track-cooler/docs/Estrutura/PC2/Simulações/statistics_malha_sapatas.PNG

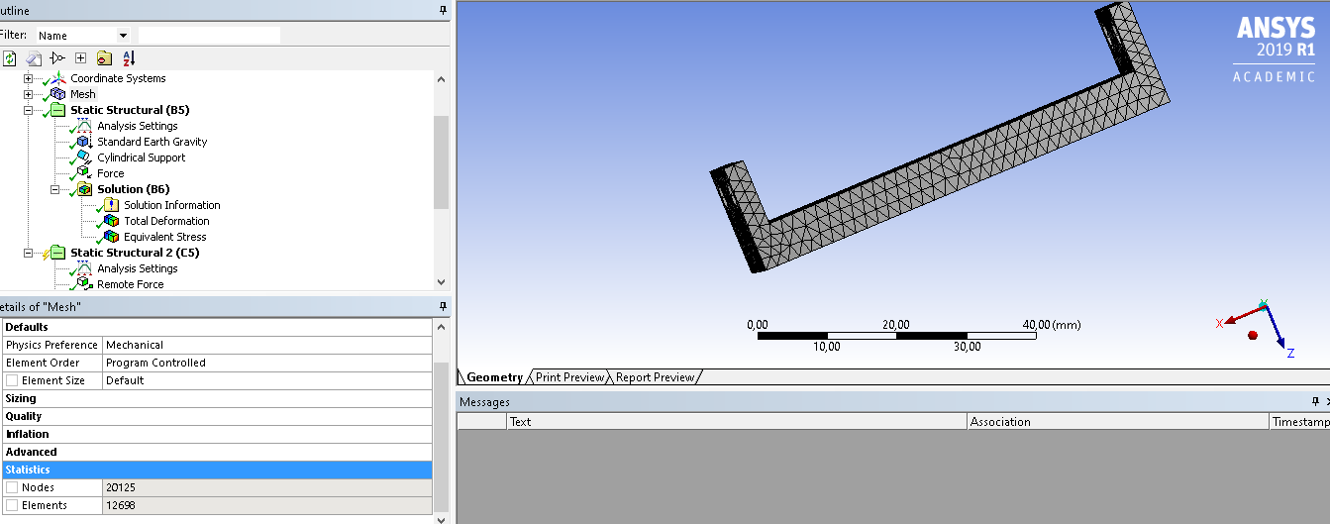
Estrutura/PC2/Simulações/statistics_malha_sapatas.PNG
