track-cooler/docs/Estrutura/PC2/Simulações/sapatanovaforcas.png

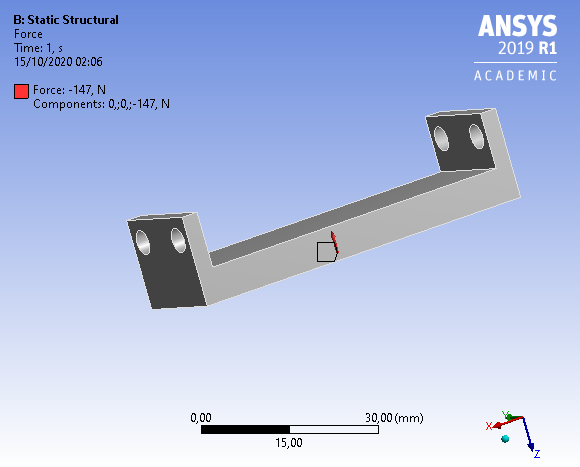
Estrutura/PC2/Simulações/sapatanovaforcas.png
