track-cooler/docs/README.md

# docs
Documentos relacionados ao Track Cooler - PI2
