track-cooler/docs/Software/README.md

## docs de Software

Para entender um pouco mais sobre o produto, acesse nossa [documentação](https://track-cooler.github.io/app_track_cooler/).
