track-cooler/docs/Estrutura/PC2/Análise Térmica/README.md

# Pasta para arquivos de análise térmica
