track-cooler/docs/Estrutura/PC2/Sistema de Alimentação/README.md

# Pasta para arquivos do sistema de alimentação
