track-cooler/docs/Apresentacoes/PONTO_DE_CONTROLE_1/TRACK_COOLER.pptx

## Track Cooler

## Problema

- Mudança nos Hábitos de Consumo;
- Busca de Produtos e Serviços;
- Soluções modernas no setor de bens de consumo;
- Tecnologia Disruptivas;
- Entretenimento e Lazer;

## Slide 3

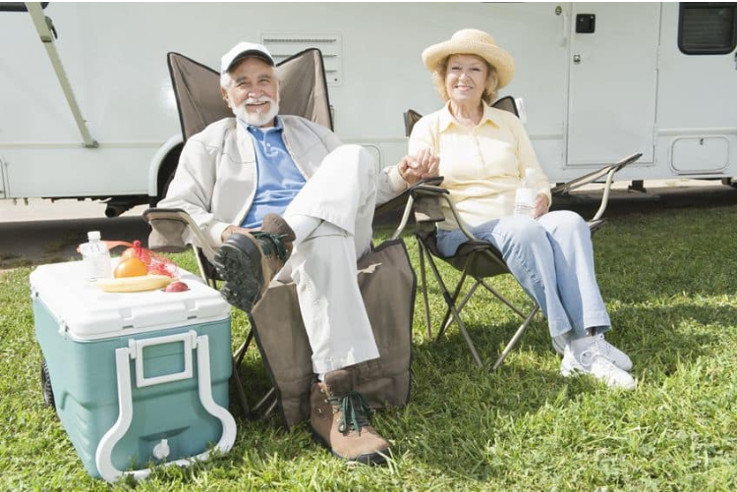
[picture p27: figure]
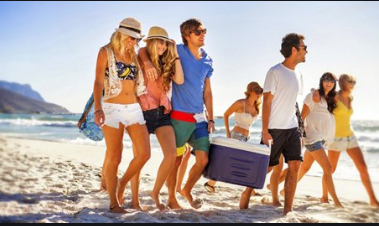
[picture p28: figure]
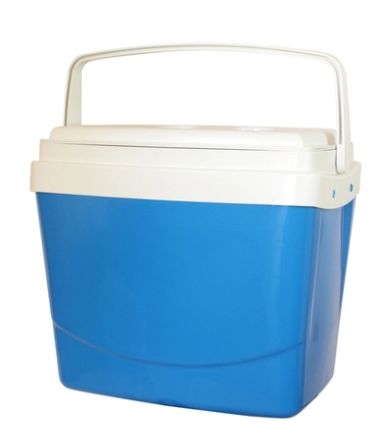
[picture p29: figure]
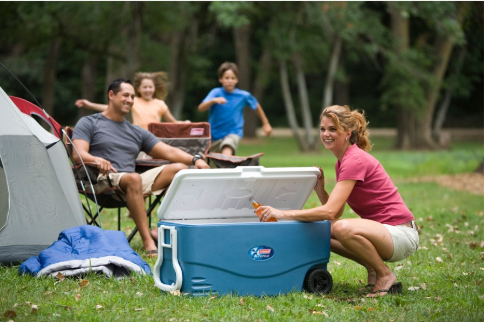
[picture p30: figure]
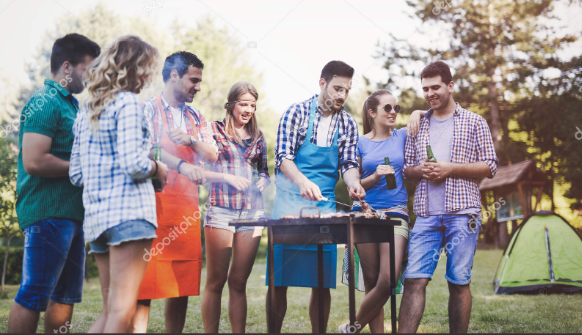
[picture p31: figure]

## Escopo

- TRACK COOLER

## Slide 5

Oportunidade de Negócio

- Público Alvo;
- Carência;
- Solução;
- Descrição da Solução;
- Diferenciais;

## Slide 6

Oportunidade de Negócio

- Linguagem Simples;
- Aplicação possuirá menu com todos recursos não-administrativos do sistema
- Consultar a temperatura
- Melhora a Capacidade de locomoção do usuário

## Requisitos do Projeto

## Requisitos de estrutura

- Boa capacidade de manter a temperatura interna;
- Possível se movimentar em terrenos planos e baixa erosão;
- Absorver vibrações;
- Suportar a carga total da caixa térmica;
- Suprir a demanda de potência das cargas eletroeletrônicas do cooler;

## Requisitos Eletrônica

- Localizar o cooler através do GPS.
- Seguir o cliente a partir do uso de celular por módulo bluetooth.
- Aferir a temperatura do cooler.
- Identificar desníveis
- Protótipo funcionará através do app ligado.
- Seguir o usuário a partir de determinada distância.

## Requisitos de Software

- Ver e atualizar informações do cooler;
- Conectar com bluetooth do cooler;
- Ligar/desligar o cooler;
- Abrir configurações (gps e bluetooth);
- Exibir alerta caso o cooler não consiga seguir a pessoa ou se for desconectado;
- Comandos por voz;
- Mudança de contraste no aplicativo;
- Alterar tamanho da fonte da letra;

## Estrutura Analítica do Projeto (EAP)

## Slide 12

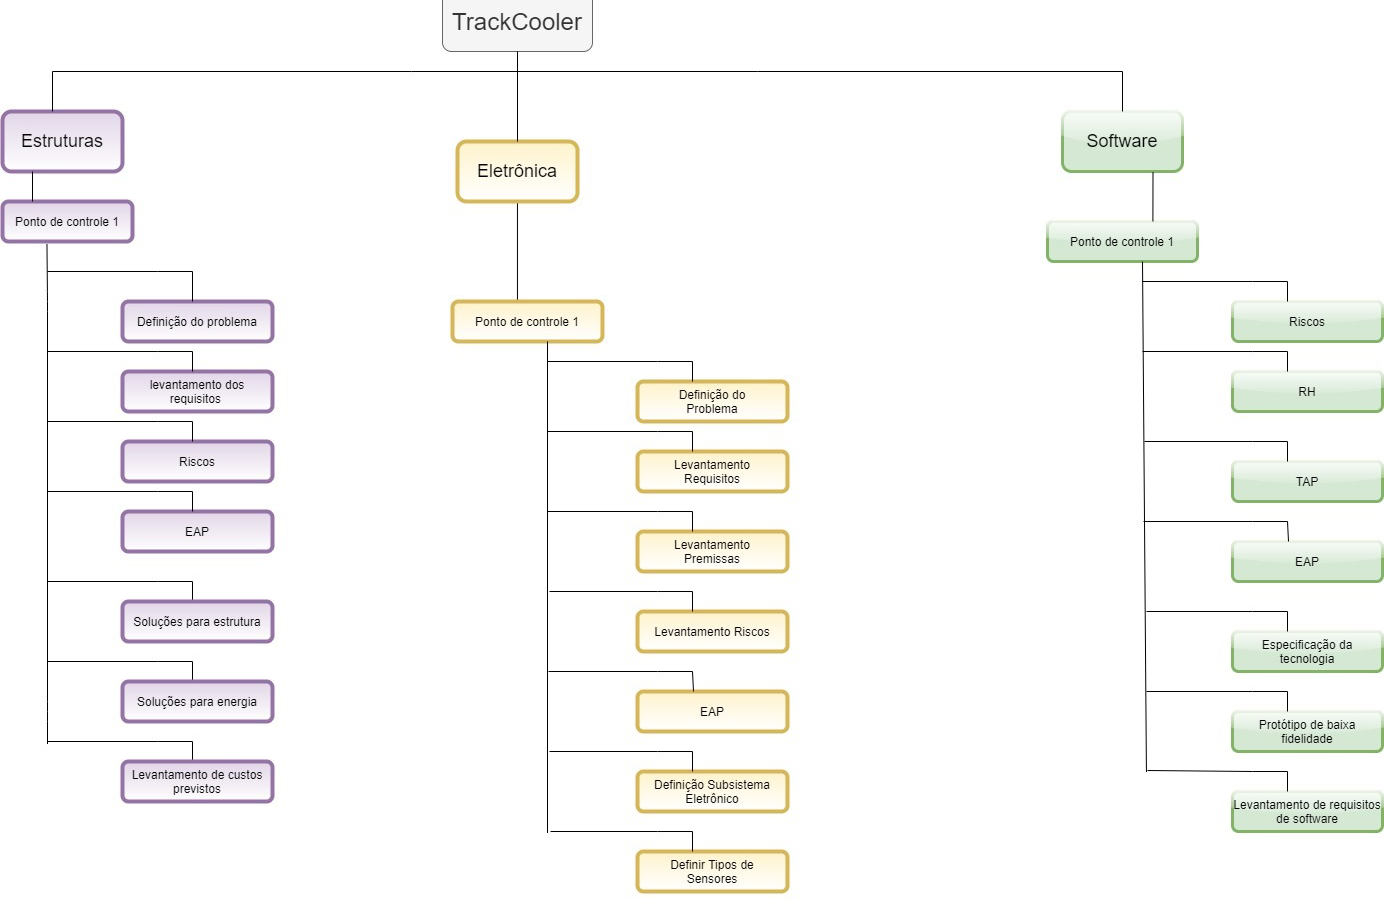
[picture p32: figure]

## Slide 13


## Slide 14

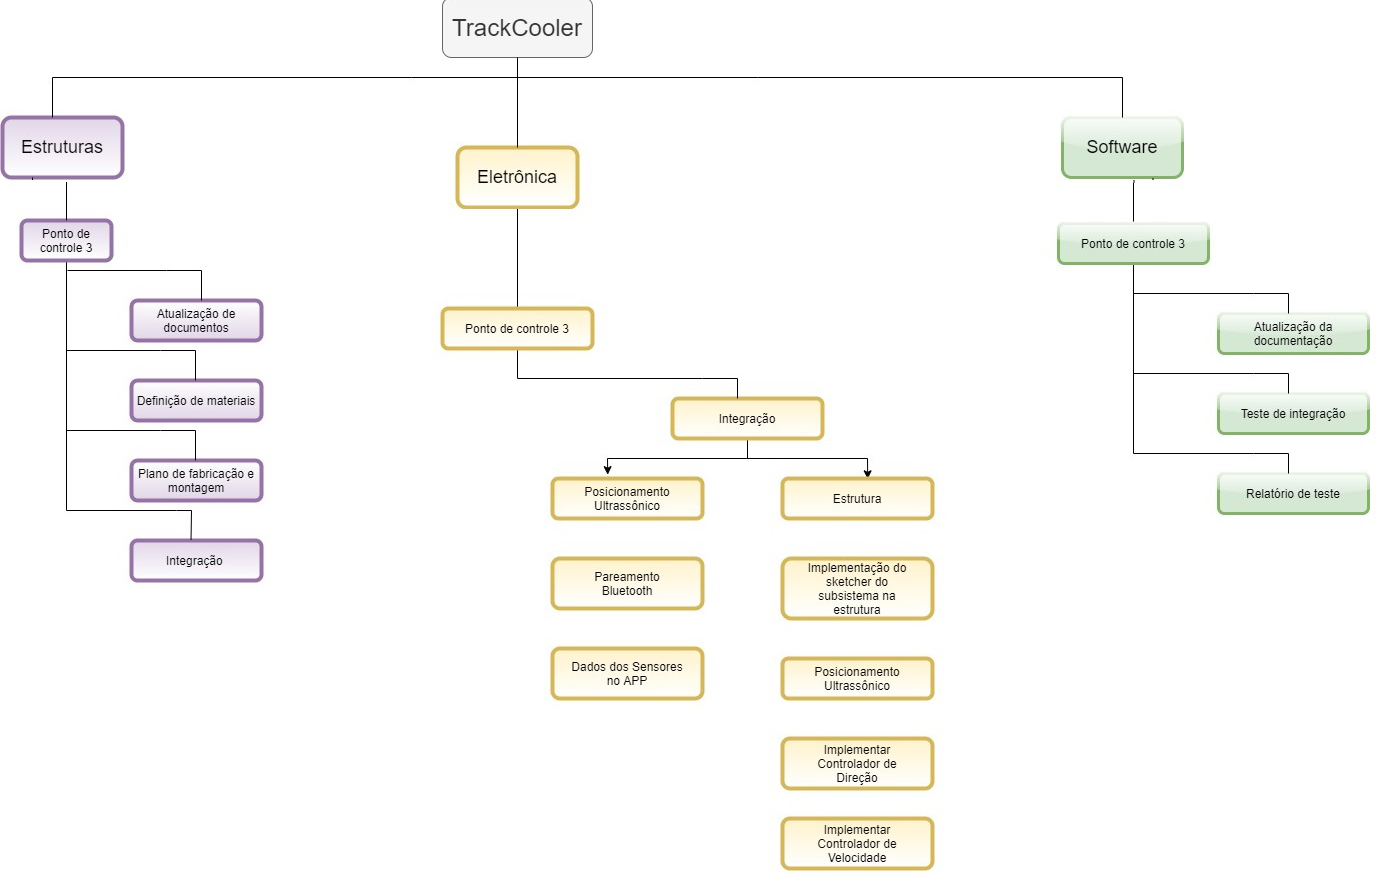
[picture p33: figure]

## Proposta de Solução

## Solução de estruturas

- Mecanismo de locomoção;
- Cooler;
- Chassi;
- Sistema de alimentação.

## Slide 17

Mecanismo de locomoção


## Slide 18

Mecanismo de locomoção

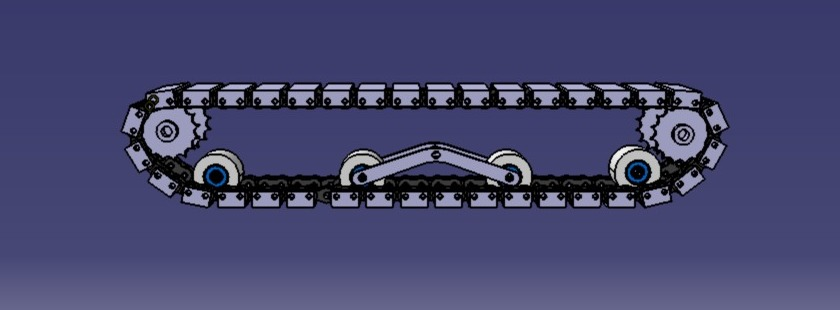
[picture p34: figure]

## Cooler

- Caixa organizadora para a parte interna;
- Poliestireno expandido (isopor) para a segunda camada;
- Chapas de policloreto de vinila (PVC) para a terceira e última camada.

## Slide 20

Chassi

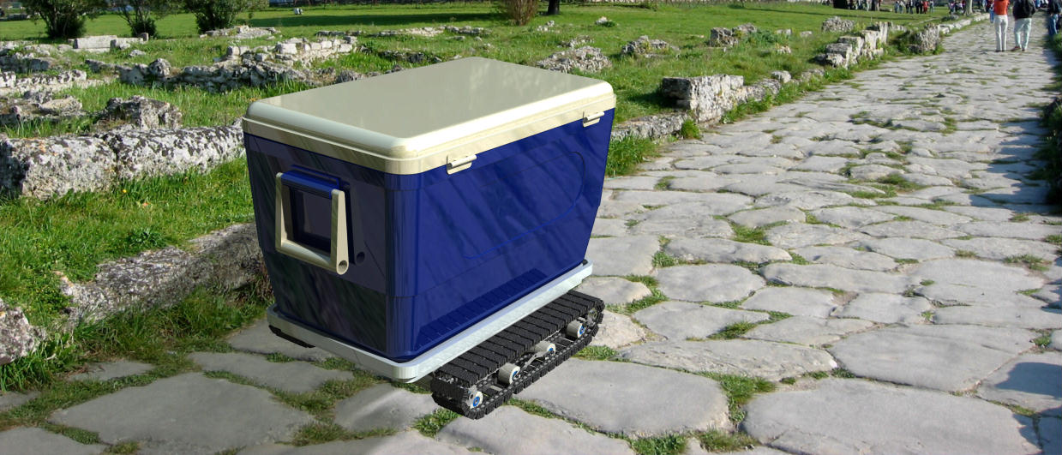
[picture p35: figure]

## Slide 21

Sistema de alimentação

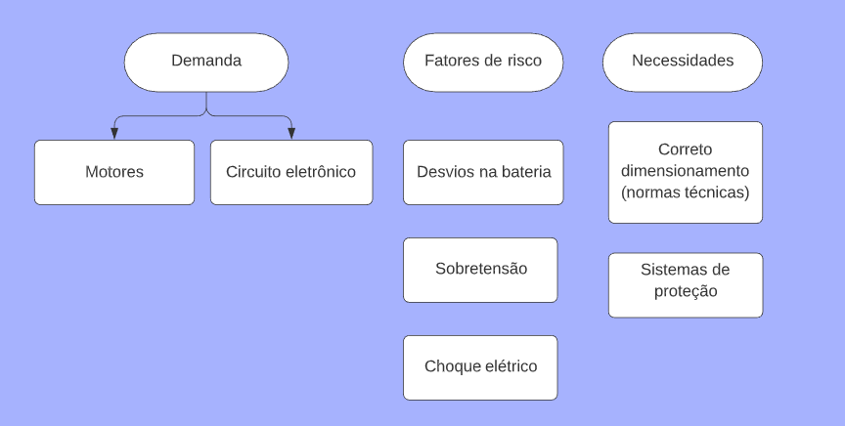
[picture p36: figure]

## Slide 22

Sistema de alimentação

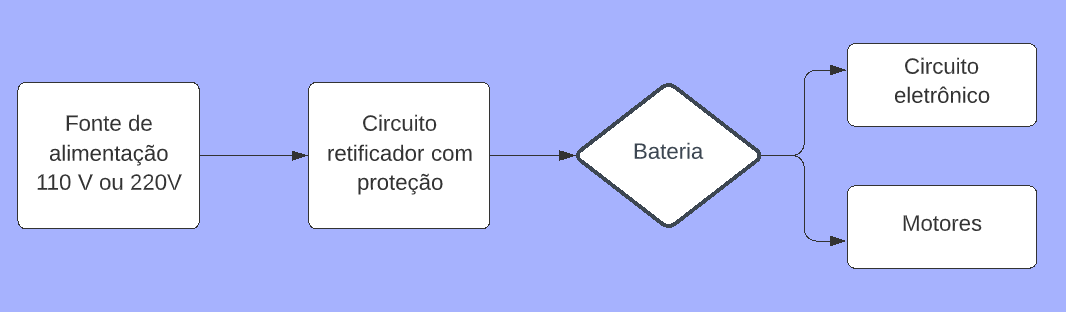
[picture p37: figure]

## Solução de Eletrônica

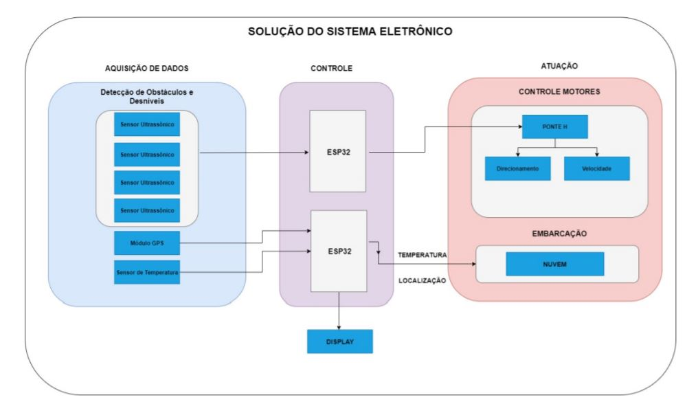
[picture p38: figure]

## Solução de Software

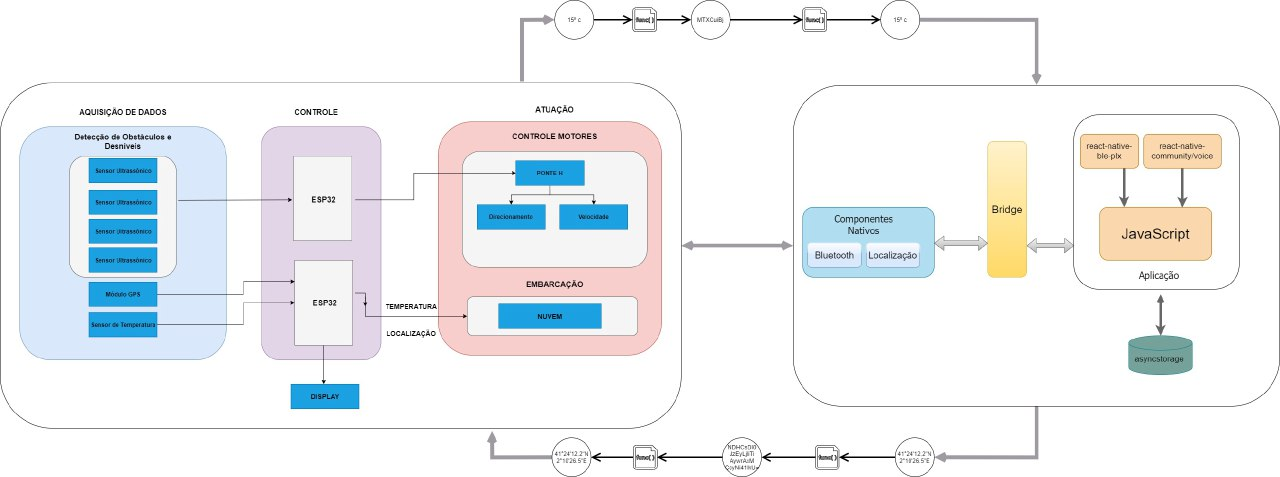
[picture p39: figure]

## Slide 25

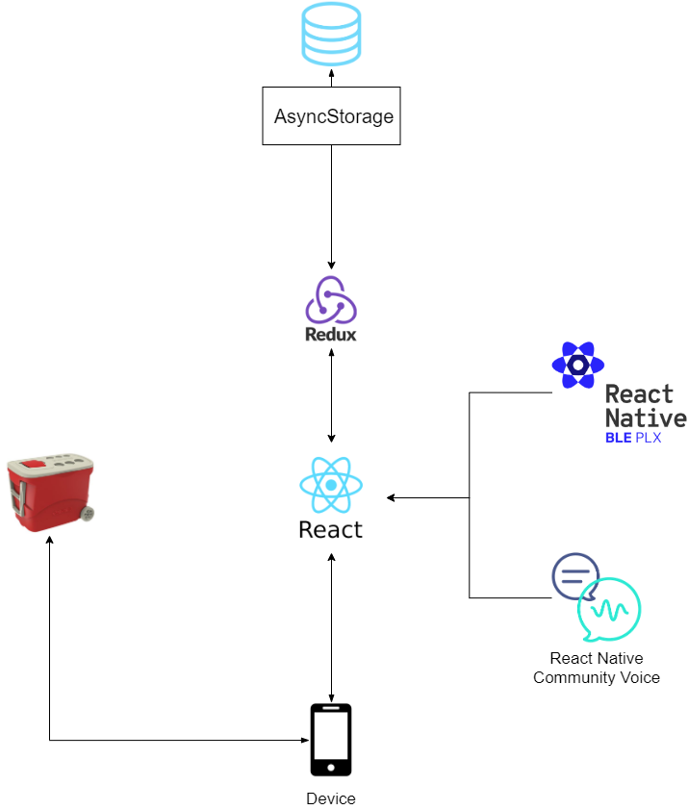
[picture p40: figure]

## Slide 26

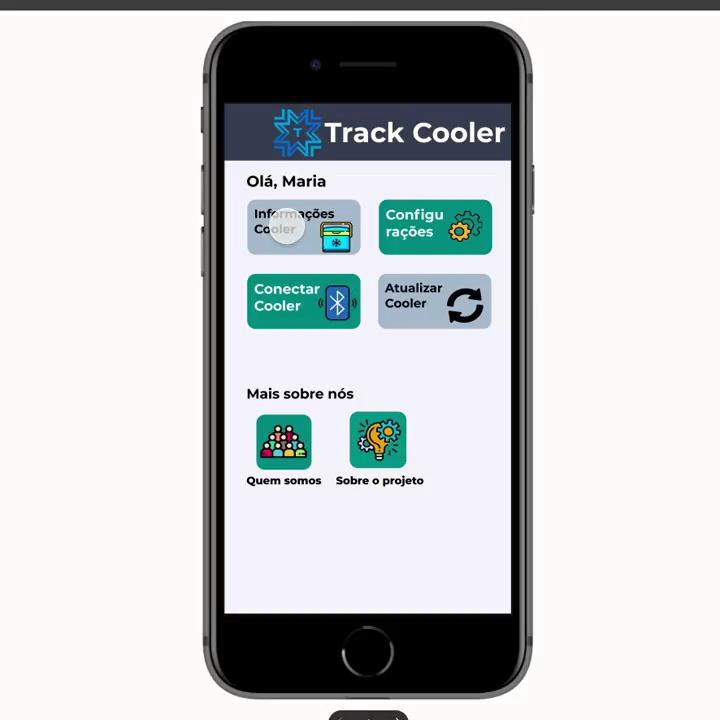
[picture p41: figure]

## Obrigado!
