track-cooler/docs/Reunioes/PC1/REUNIÃO_18_09.pdf

-Oportunidade de Negócios

-Visão do produto (Sannya estruturar) - Apêndice

-perfil do usuário

-Trabalhos Correlatos

-Animação com movimentação (Apresentação).

-Resumo: Resultados esperados

-Mandar TAP para o Apêndice A:

- Descrição do Projeto;
- Justificativa;
- Objetivo;
- Requisitos;
- Riscos
- Cronograma;

-Apêndice B: Plano de Gerenciamento de Recursos Humanos

-Imagens nos anexos ????

REUNIÃO (18/09/2020):

-Objetivos Gerais mais integrados;

-gráfico de Gantt (arruma texto);

- integração software e Eletrônica;
- desenvolvimento de diagramas de integração.

-Apresentar trabalho – antes da premissa;

- Integrar os tópicos =;

-Escopo (1.4) = talvez colocar antes das premissas;

- Apresentar Resultados esperados

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
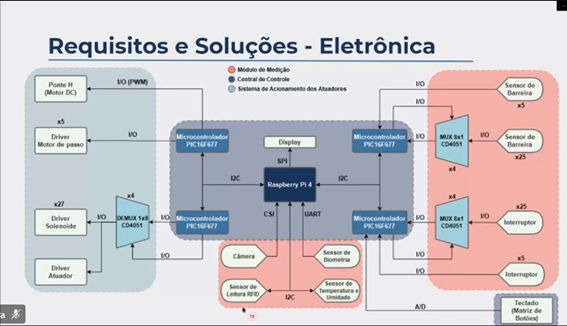
[picture p42: figure]
