track-cooler/docs/Estrutura/PC3/Alimentacao/Simulações.pdf

SIMULAÇÕES

Software Proteus

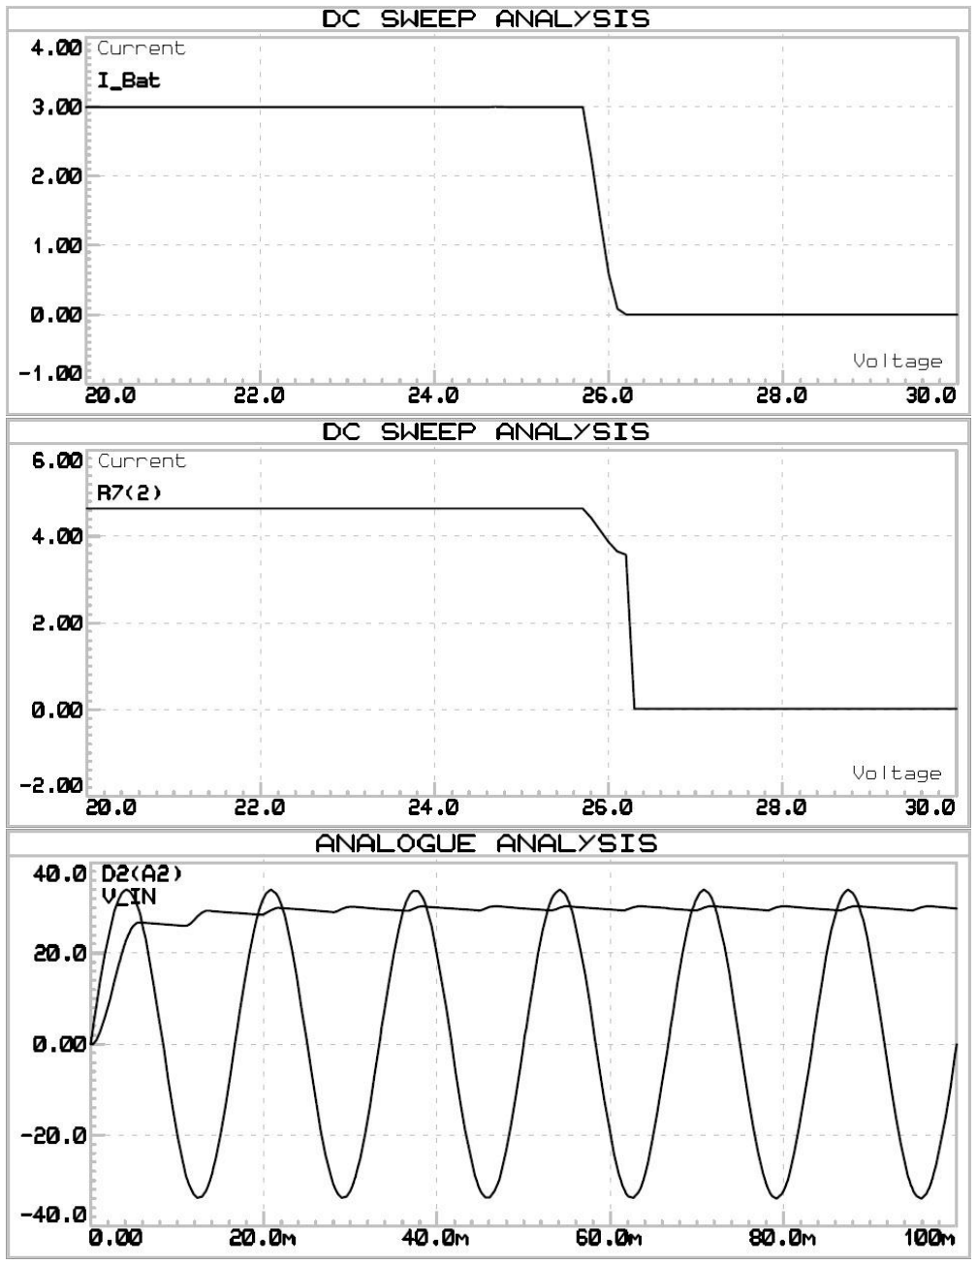
[picture p43: figure]

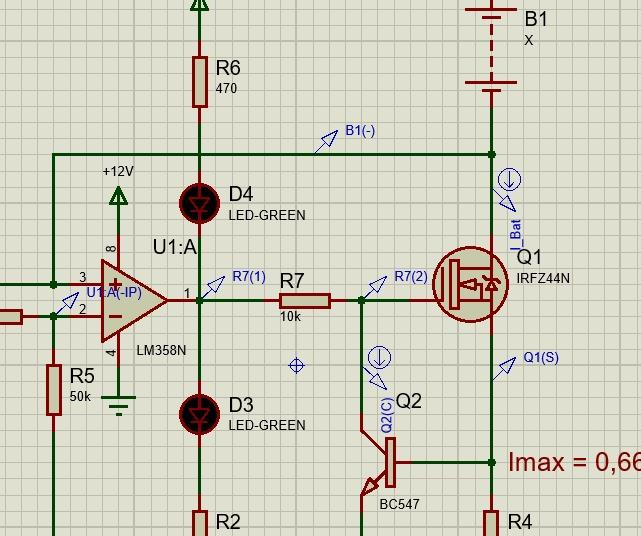
[picture p44: figure]
