track-cooler/docs/Estrutura/PC2/Sistema de Alimentação/Simulações.pdf

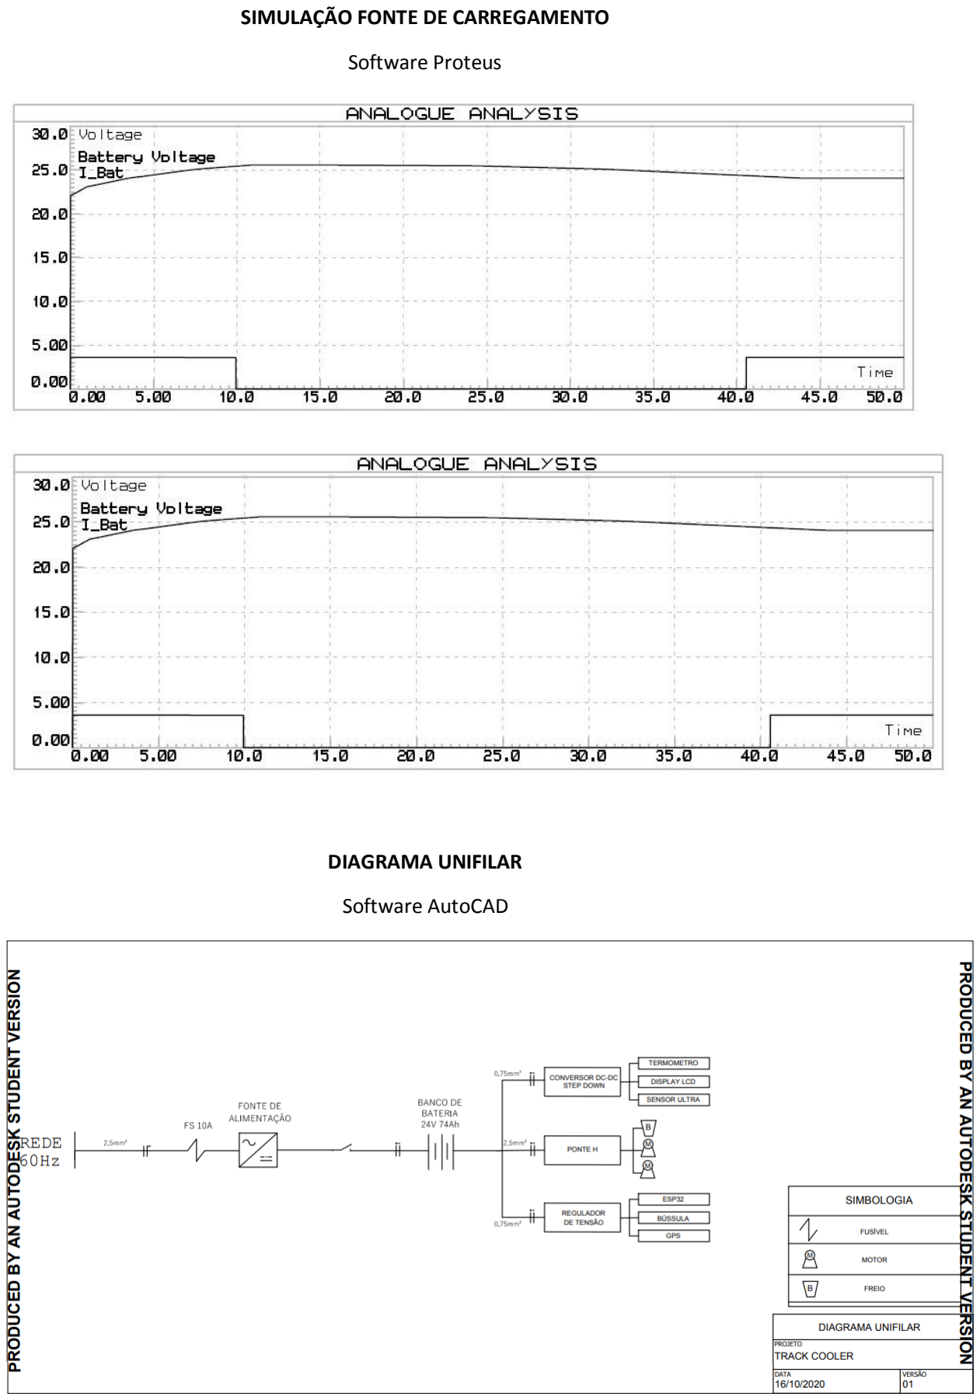
[picture p45: page 1]

SIMULAÇÃO FONTE DE CARREGAMENTO

Software Proteus

DIAGRAMA UNIFILAR

Software AutoCAD
