track-cooler/docs/Eletronica/PC2/SISTEMA_DE_SEGUIMENTO.PNG

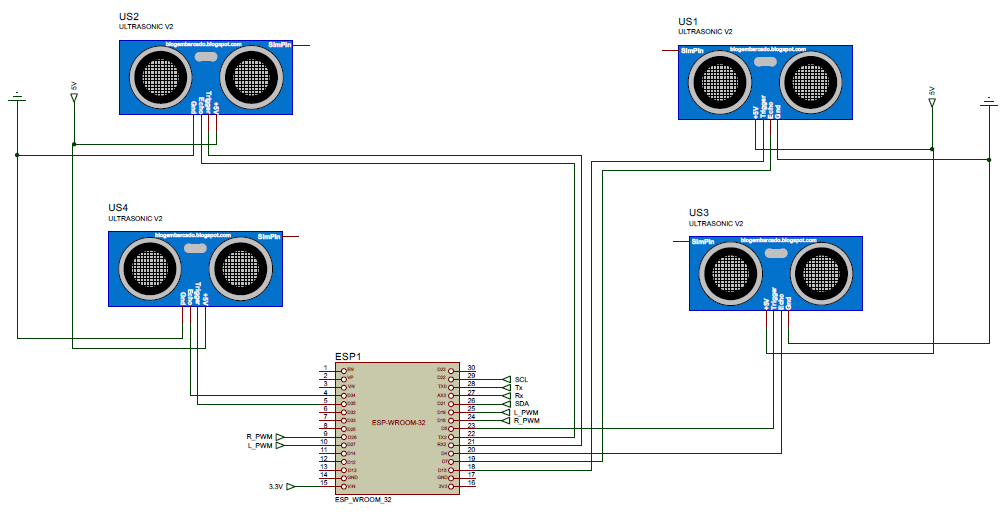
Eletronica/PC2/SISTEMA_DE_SEGUIMENTO.PNG
