track-cooler/docs/Eletronica/PC2/SISTEMA_ELETRONICA_COMPLETO.PNG

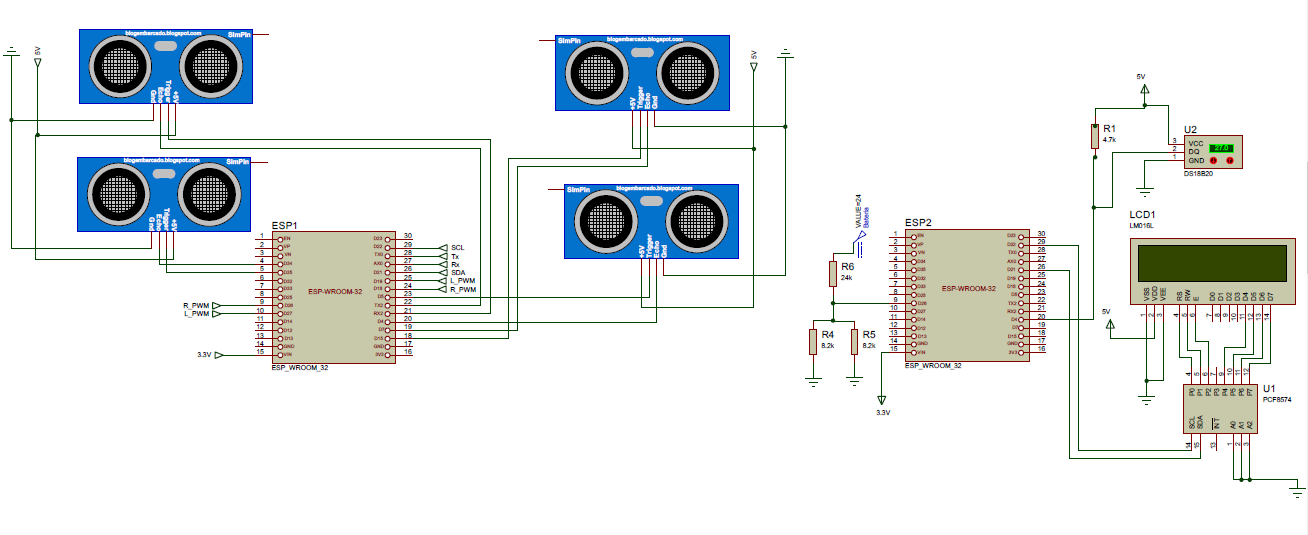
Eletronica/PC2/SISTEMA_ELETRONICA_COMPLETO.PNG
