track-cooler/docs/Eletronica/PC2/TEMPERATURA_BATERIA_LCD_I2C.PNG

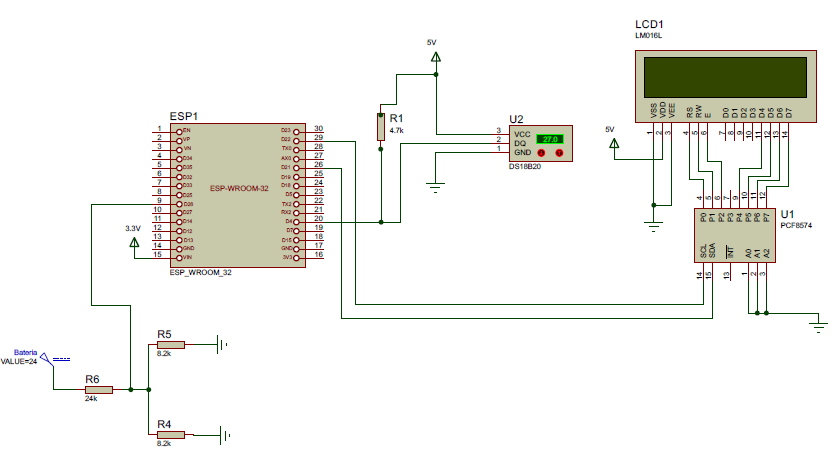
Eletronica/PC2/TEMPERATURA_BATERIA_LCD_I2C.PNG
