track-cooler/docs/Estrutura/PC2/Análise Térmica/3600s  aberta.png

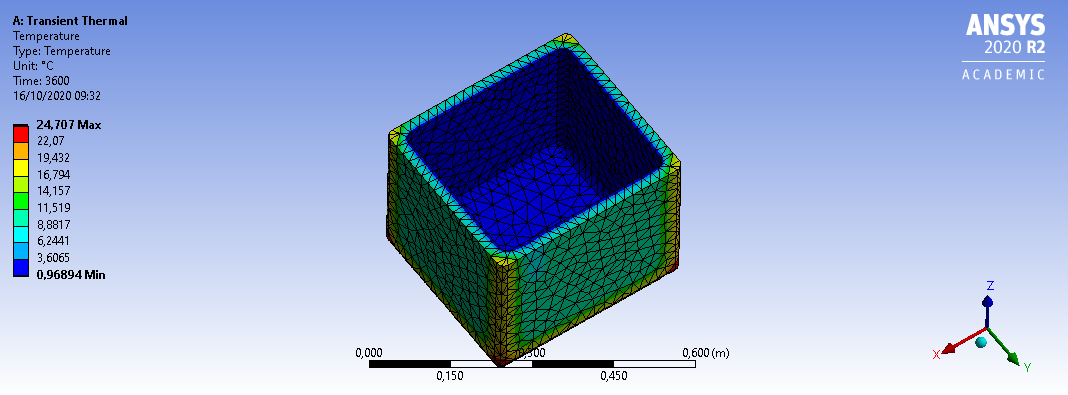
Estrutura/PC2/Análise Térmica/3600s aberta.png
