track-cooler/docs/Estrutura/PC2/Análise Térmica/tampa.png

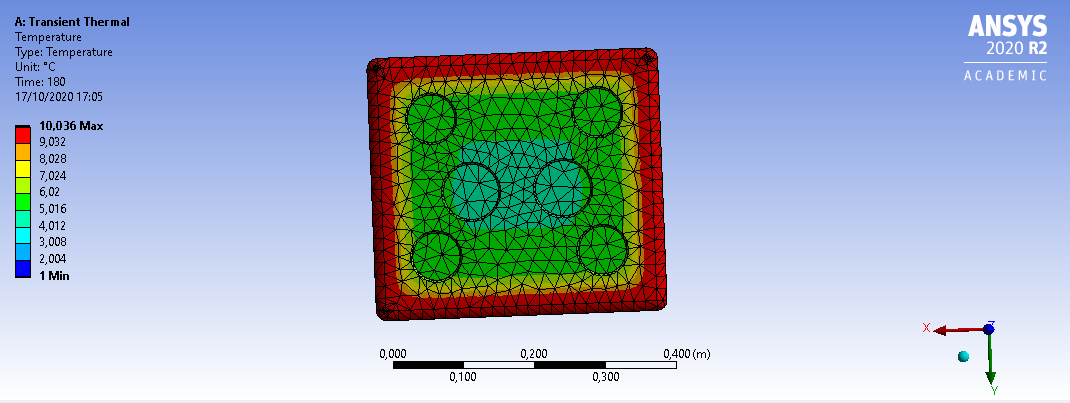
Estrutura/PC2/Análise Térmica/tampa.png
