track-cooler/docs/Estrutura/PC2/CAD/CAD/brakecooler.PNG

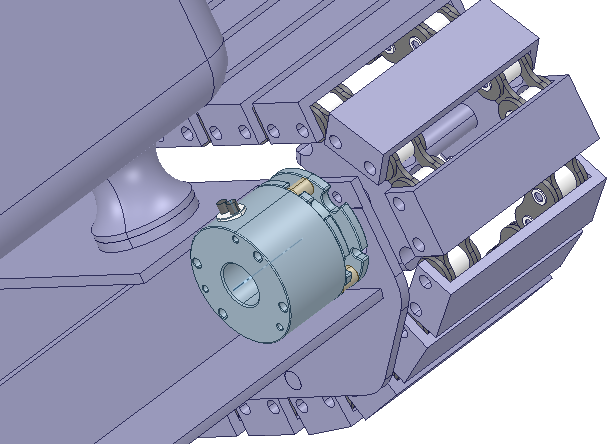
Estrutura/PC2/CAD/CAD/brakecooler.PNG
