track-cooler/docs/Estrutura/PC2/CAD/CAD/caixa2.PNG

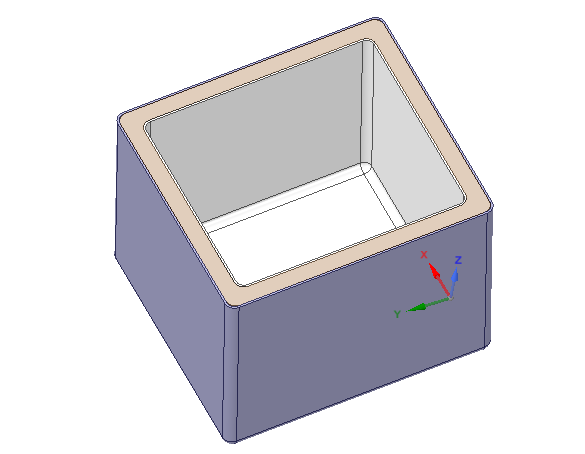
Estrutura/PC2/CAD/CAD/caixa2.PNG
