track-cooler/docs/Estrutura/PC2/CAD/CAD/Caixa3.PNG

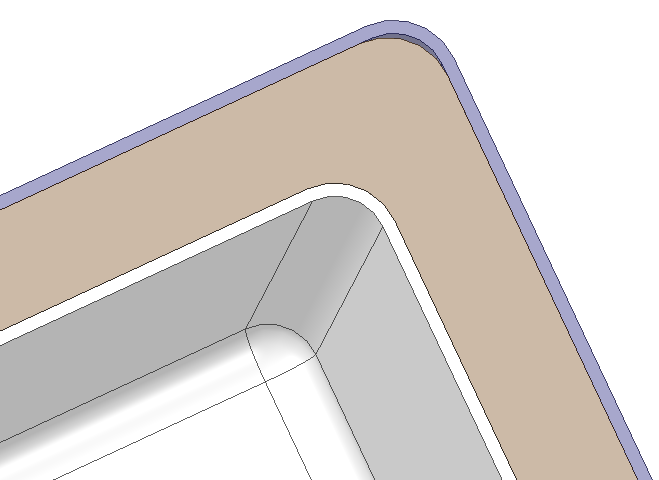
Estrutura/PC2/CAD/CAD/Caixa3.PNG
