track-cooler/docs/Estrutura/PC2/CAD/CAD/caixa.PNG

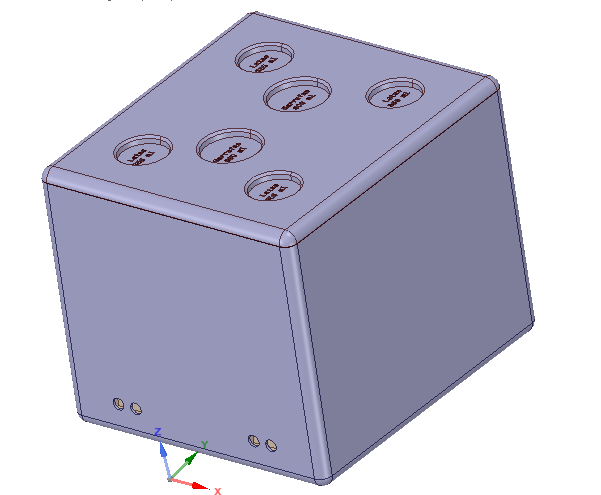
Estrutura/PC2/CAD/CAD/caixa.PNG
