track-cooler/docs/Estrutura/PC2/CAD/CAD/cantoneira.PNG

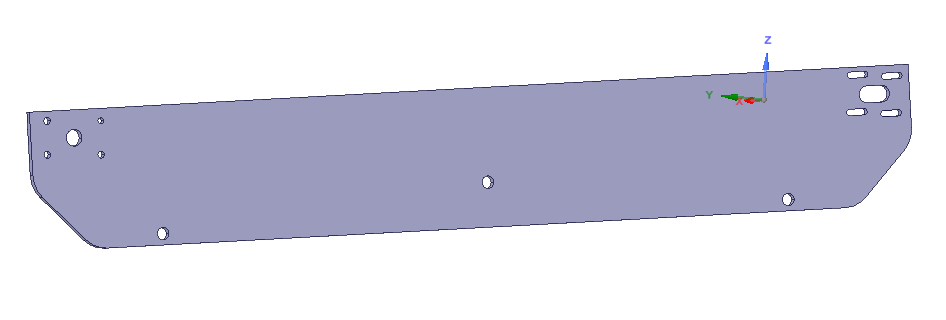
Estrutura/PC2/CAD/CAD/cantoneira.PNG
