track-cooler/docs/Estrutura/PC2/CAD/CAD/cantoneirareforco.PNG

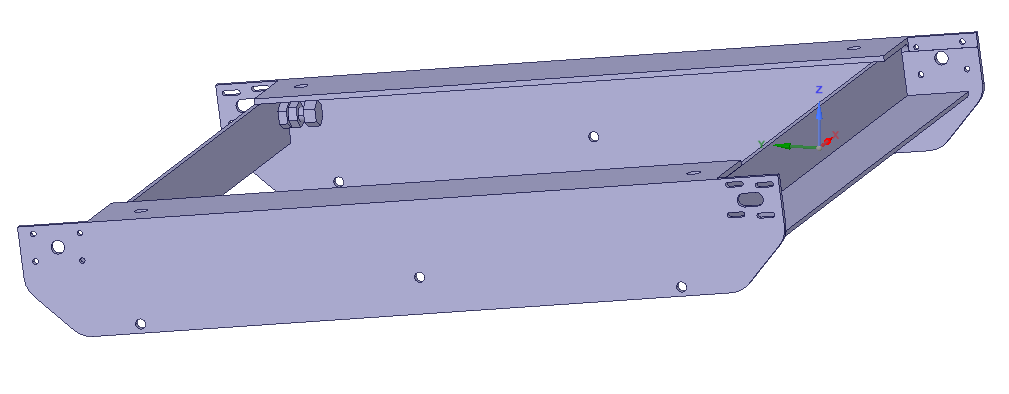
Estrutura/PC2/CAD/CAD/cantoneirareforco.PNG
