track-cooler/docs/Estrutura/PC2/CAD/CAD/CG.png

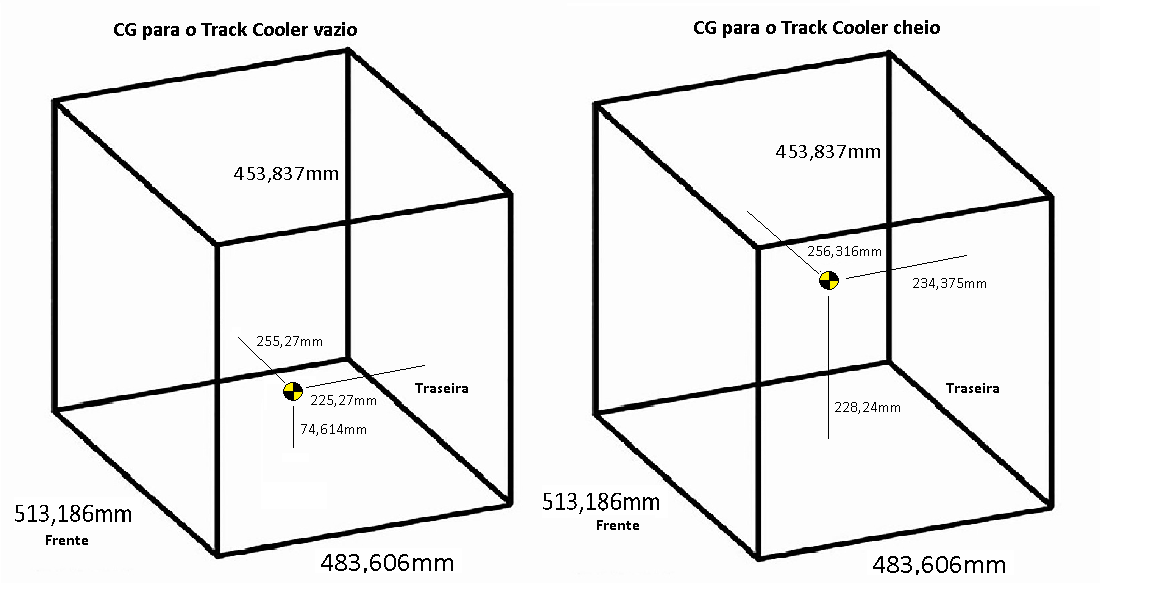
Estrutura/PC2/CAD/CAD/CG.png
