track-cooler/docs/Estrutura/PC2/CAD/CAD/CGcalc.jpg

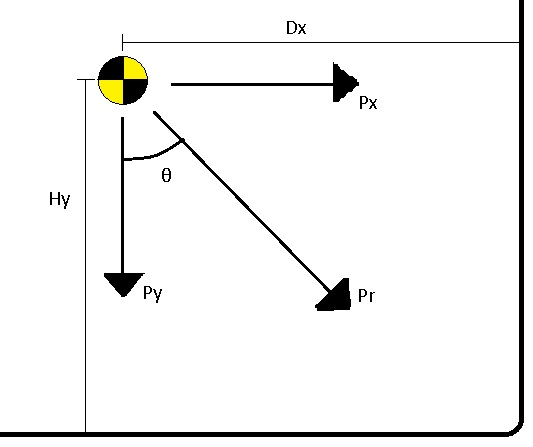
Estrutura/PC2/CAD/CAD/CGcalc.jpg
