track-cooler/docs/Estrutura/PC2/CAD/CAD/Coxim.PNG

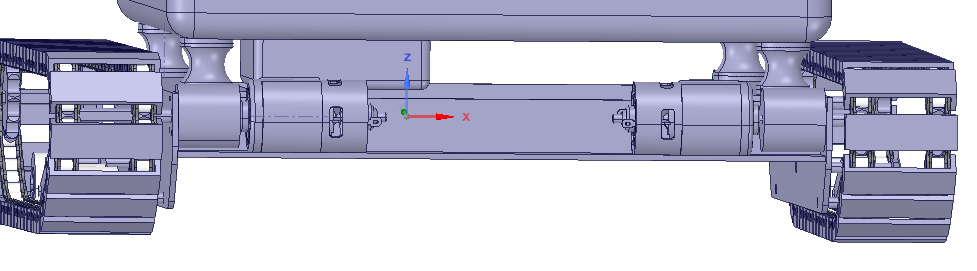
Estrutura/PC2/CAD/CAD/Coxim.PNG
