track-cooler/docs/Estrutura/PC2/CAD/CAD/Gangorra.PNG

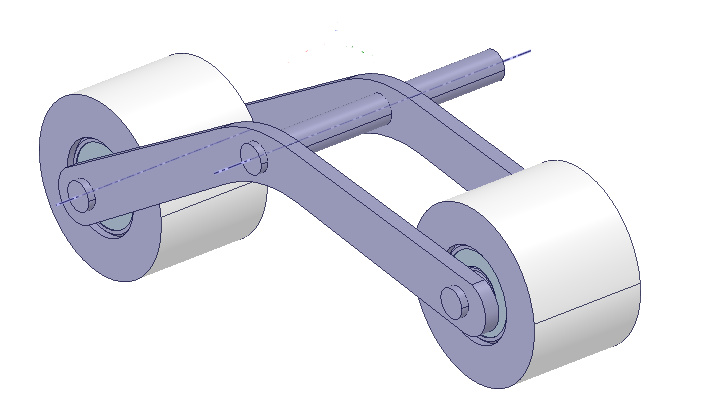
Estrutura/PC2/CAD/CAD/Gangorra.PNG
