track-cooler/docs/Estrutura/PC2/CAD/CAD/motores.PNG

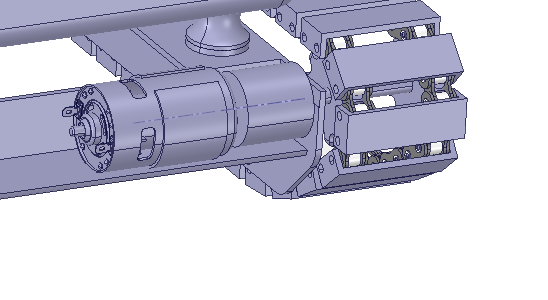
Estrutura/PC2/CAD/CAD/motores.PNG
