track-cooler/docs/Estrutura/PC2/CAD/CAD/pinhao.PNG

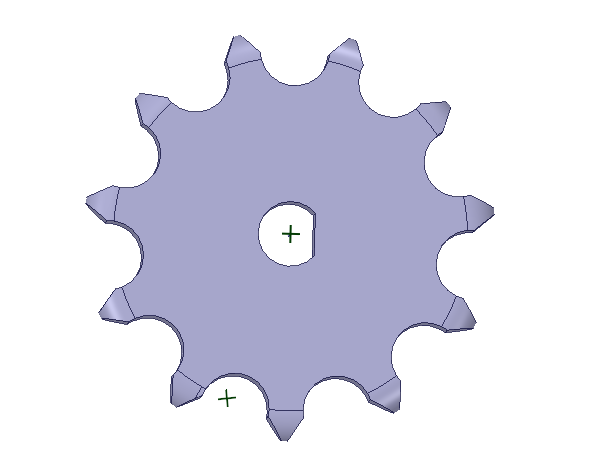
Estrutura/PC2/CAD/CAD/pinhao.PNG
