track-cooler/docs/Estrutura/PC2/CAD/CAD/pinhaocomeixo.PNG

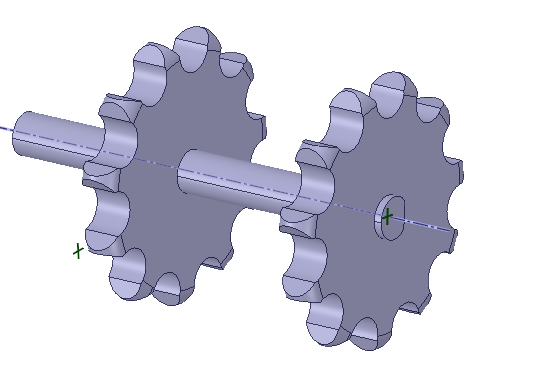
Estrutura/PC2/CAD/CAD/pinhaocomeixo.PNG
