track-cooler/docs/Estrutura/PC2/CAD/CAD/tensionador.PNG

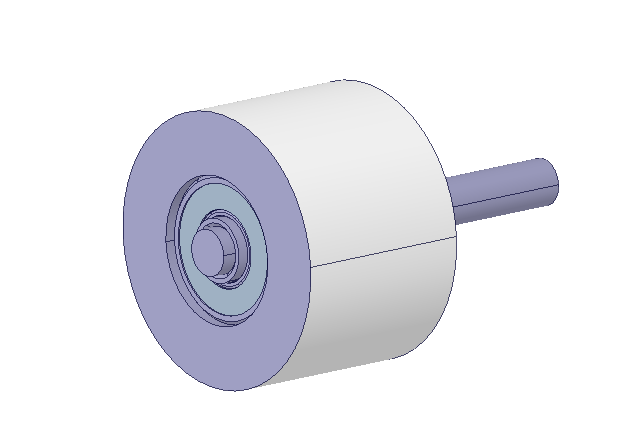
Estrutura/PC2/CAD/CAD/tensionador.PNG
