track-cooler/docs/Estrutura/PC2/CAD/CAD/Track Cooler.jpg

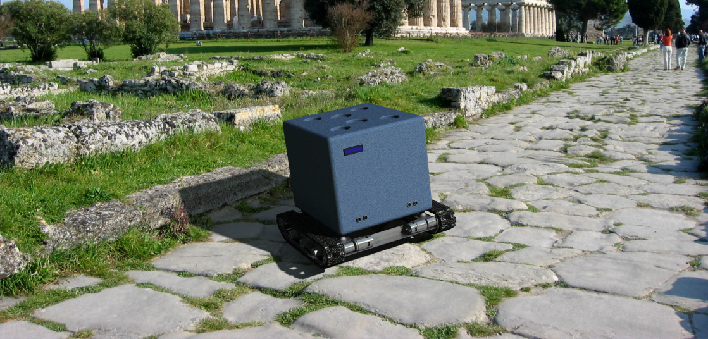
Estrutura/PC2/CAD/CAD/Track Cooler.jpg
