track-cooler/docs/Estrutura/PC2/CAD/CAD/Visaolateralsemesteira.PNG

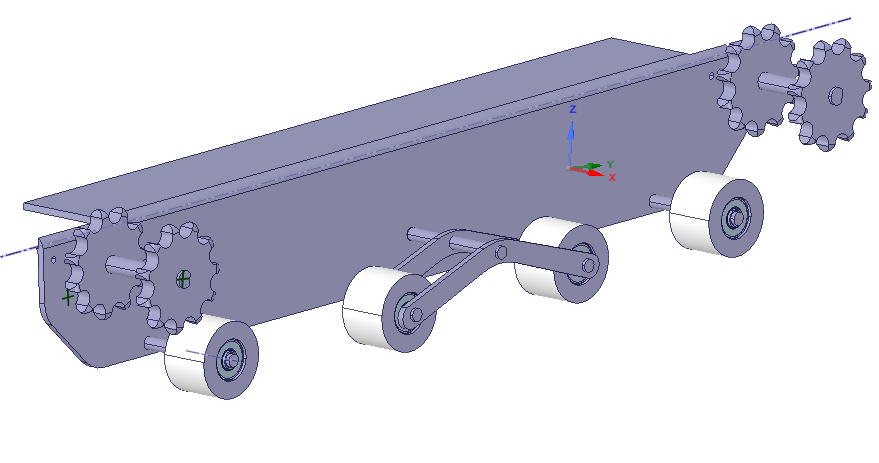
Estrutura/PC2/CAD/CAD/Visaolateralsemesteira.PNG
