track-cooler/docs/Estrutura/PC2/CAD/CAD/visãolateralesteira.PNG

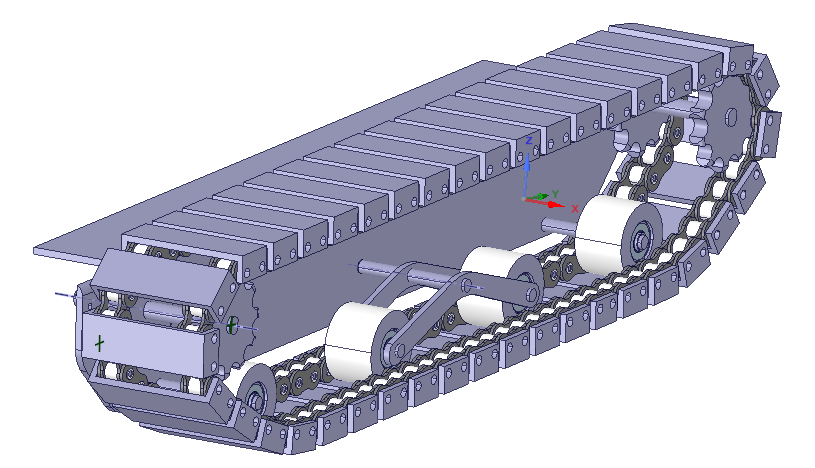
Estrutura/PC2/CAD/CAD/visãolateralesteira.PNG
