track-cooler/docs/Estrutura/PC2/Simulações/chassidef.jpg

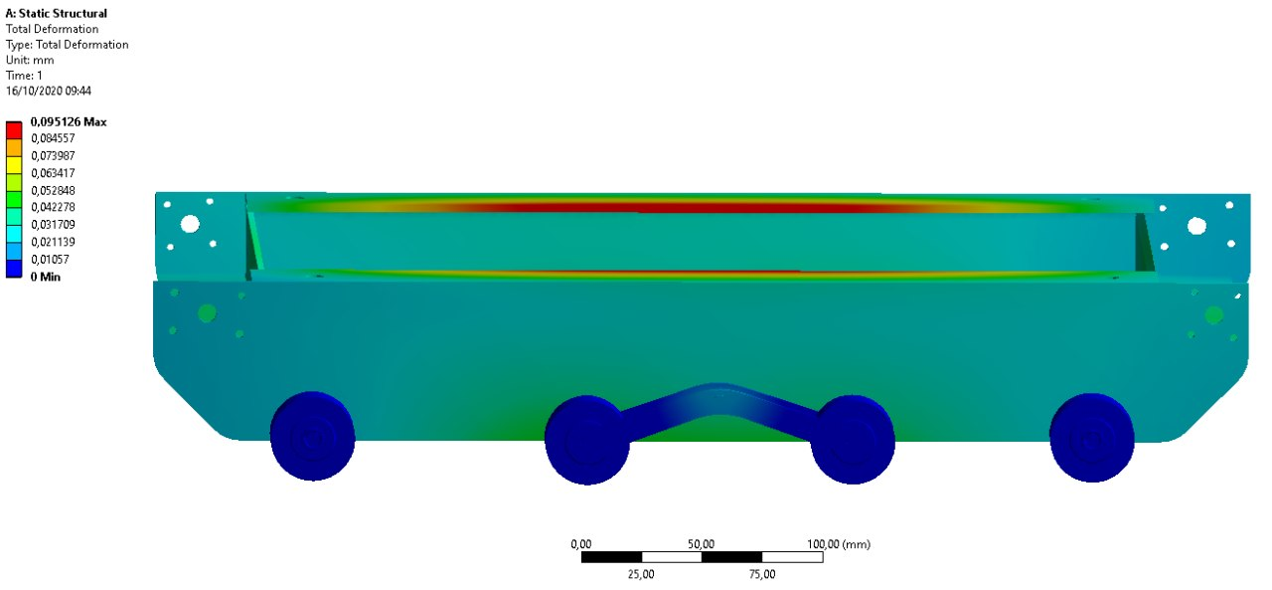
Estrutura/PC2/Simulações/chassidef.jpg
