track-cooler/docs/Estrutura/PC2/Simulações/chassitensao2.jpg

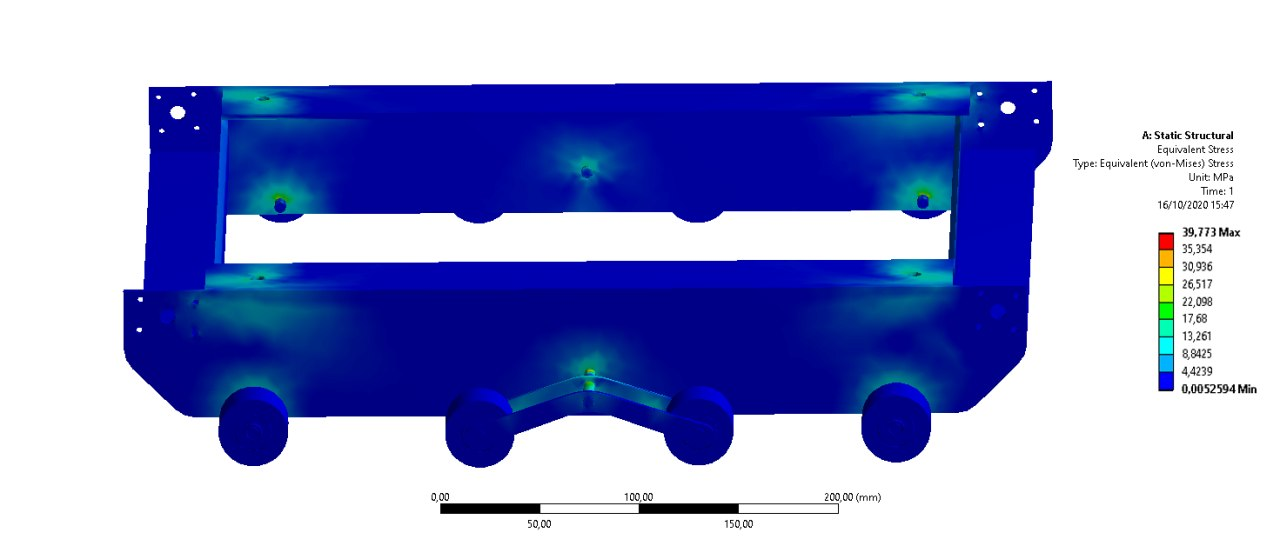
Estrutura/PC2/Simulações/chassitensao2.jpg
