track-cooler/docs/Estrutura/PC2/Simulações/chassitensao.jpg

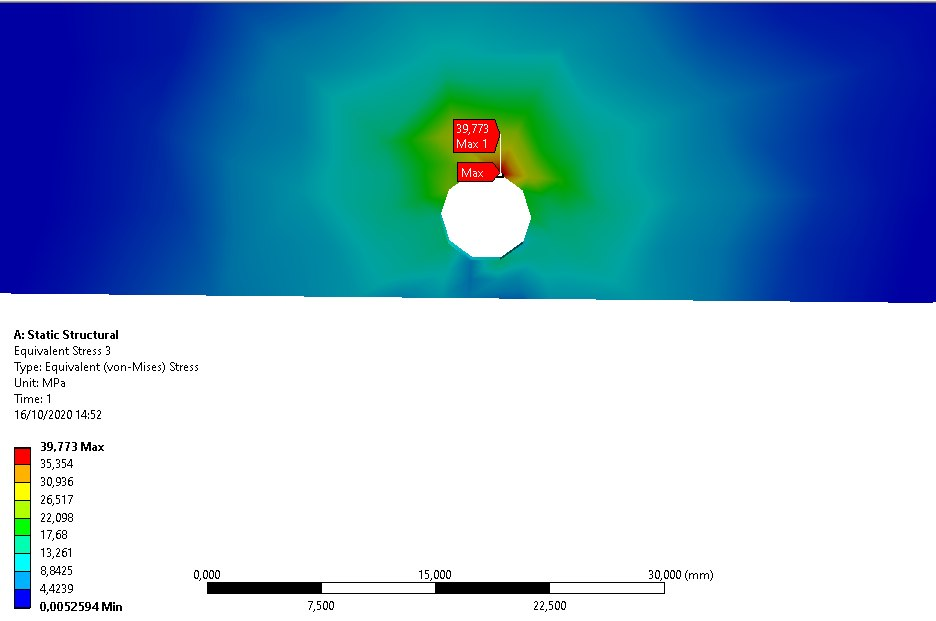
Estrutura/PC2/Simulações/chassitensao.jpg
