track-cooler/docs/Estrutura/PC2/Simulações/elementos_de_malha_sapata.png

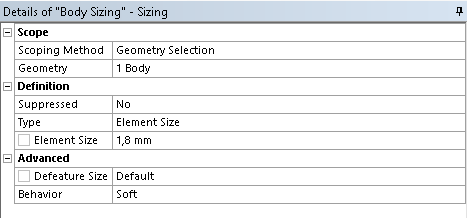
Estrutura/PC2/Simulações/elementos_de_malha_sapata.png
