track-cooler/docs/Estrutura/PC2/Simulações/Estrutura Simulação.png

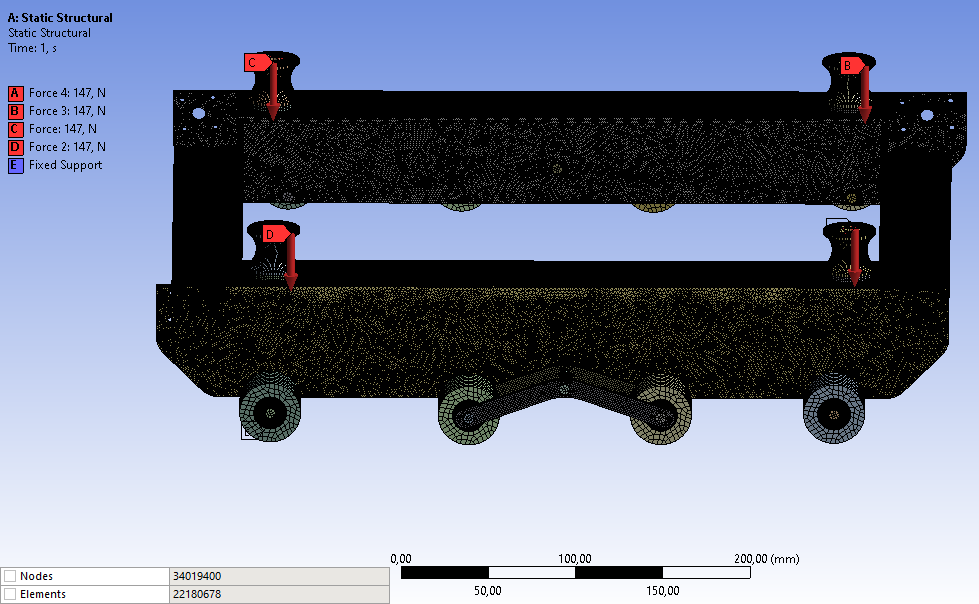
Estrutura/PC2/Simulações/Estrutura Simulação.png
