track-cooler/docs/Estrutura/PC2/Simulações/Gangorra.png

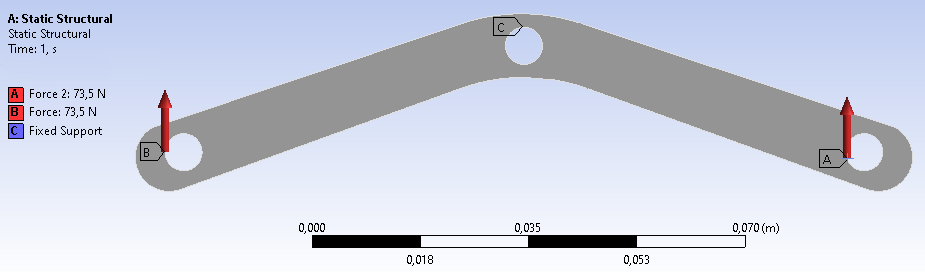
Estrutura/PC2/Simulações/Gangorra.png
