track-cooler/docs/Estrutura/PC2/Simulações/gangorrabraco.jpg

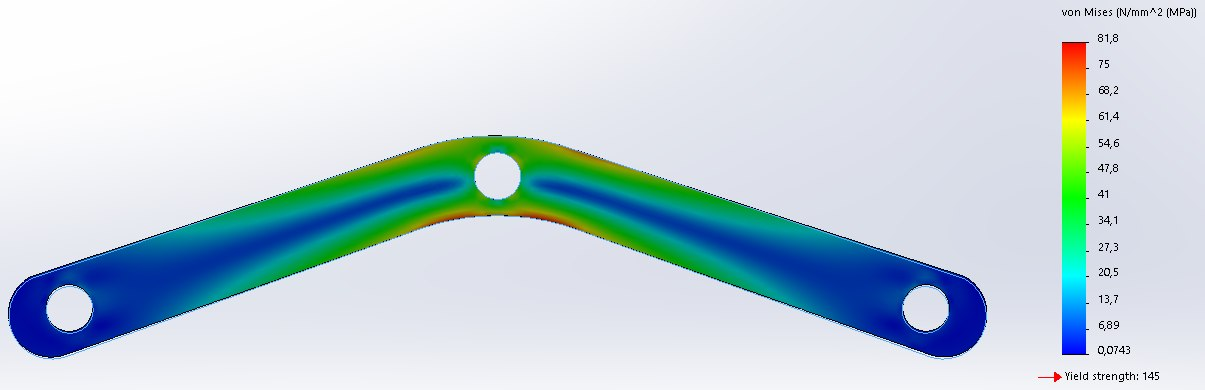
Estrutura/PC2/Simulações/gangorrabraco.jpg
