track-cooler/docs/Estrutura/PC2/Simulações/pinhaoforcas.png

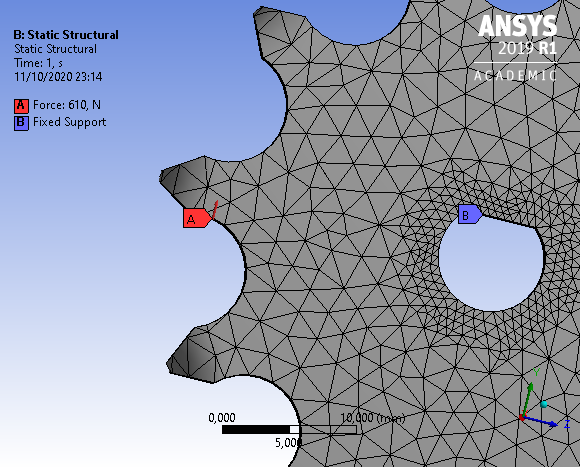
Estrutura/PC2/Simulações/pinhaoforcas.png
