track-cooler/docs/Estrutura/PC2/Simulações/pinhaovonmisses.png

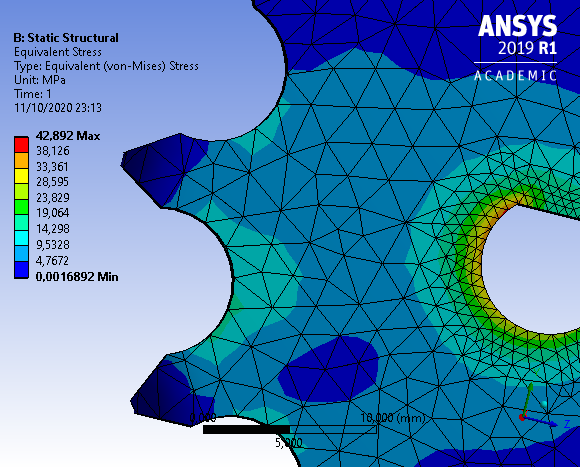
Estrutura/PC2/Simulações/pinhaovonmisses.png
