track-cooler/docs/Estrutura/PC2/Simulações/sapatanova.png

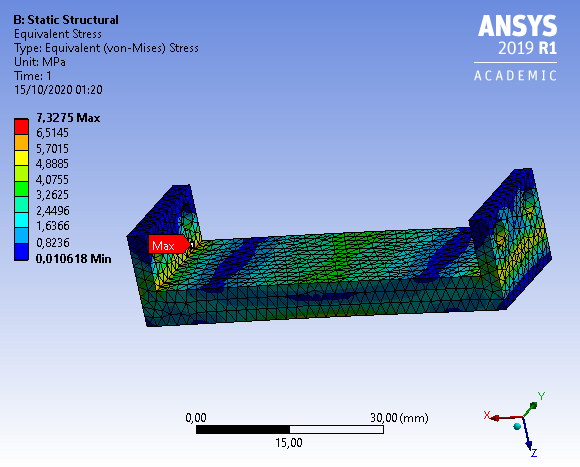
Estrutura/PC2/Simulações/sapatanova.png
