track-cooler/docs/Estrutura/PC2/Simulações/sapatanovadeformacao.png

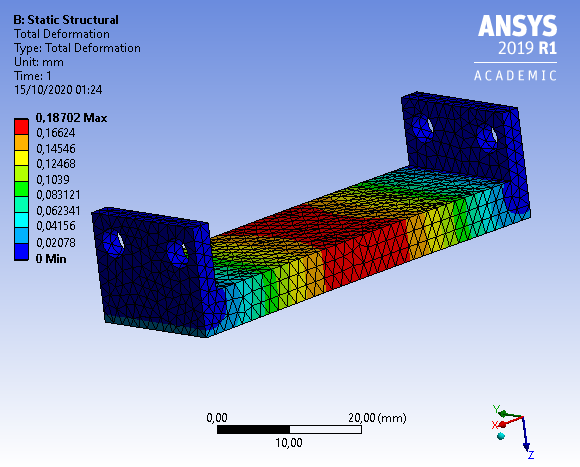
Estrutura/PC2/Simulações/sapatanovadeformacao.png
