track-cooler/docs/Estrutura/PC2/Simulações/sapatanovalateral.png

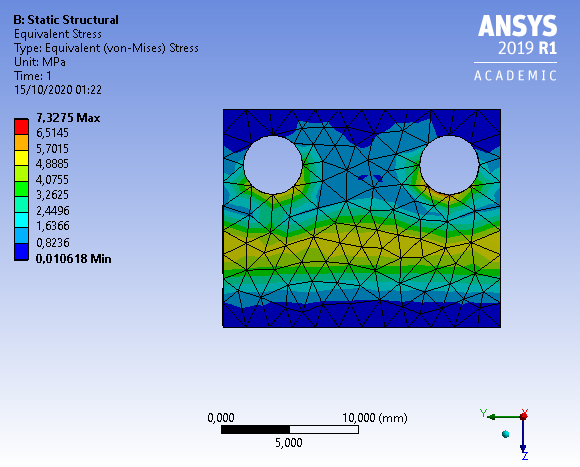
Estrutura/PC2/Simulações/sapatanovalateral.png
