track-cooler/docs/Estrutura/PC3/CAD final/ajustecorrente2.jpg

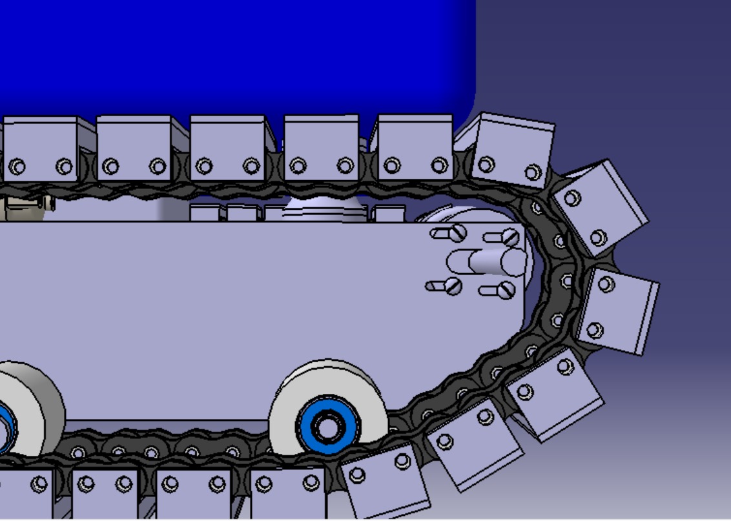
Estrutura/PC3/CAD final/ajustecorrente2.jpg
