track-cooler/docs/Estrutura/PC3/CAD final/ajustecorrente.jpg

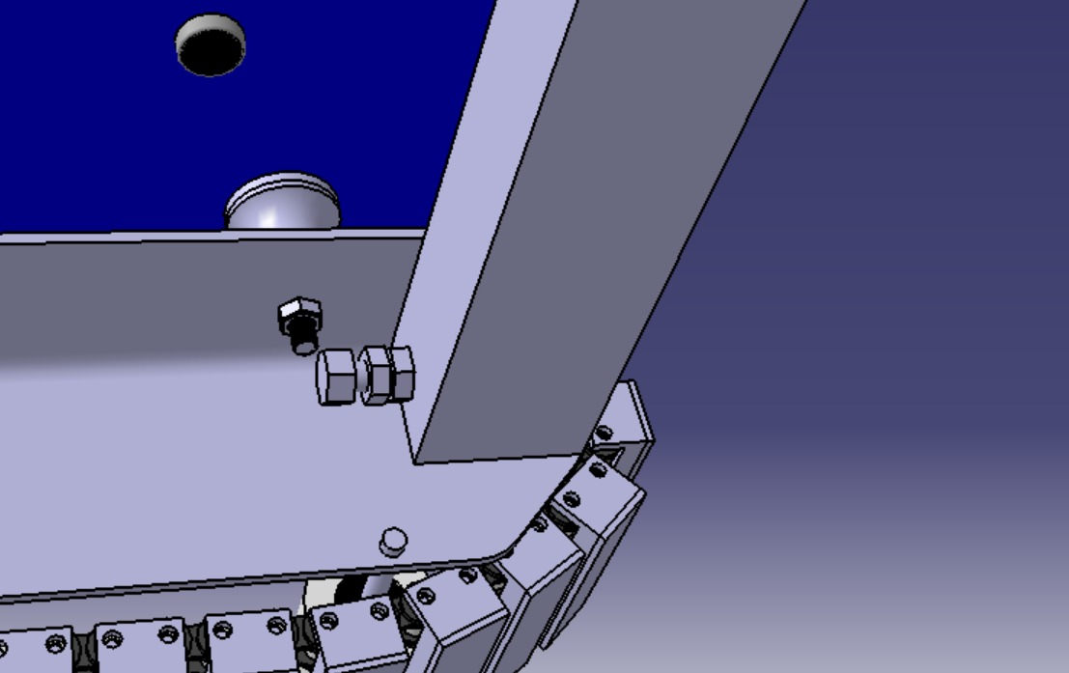
Estrutura/PC3/CAD final/ajustecorrente.jpg
