track-cooler/docs/Estrutura/PC3/CAD final/bateria.PNG

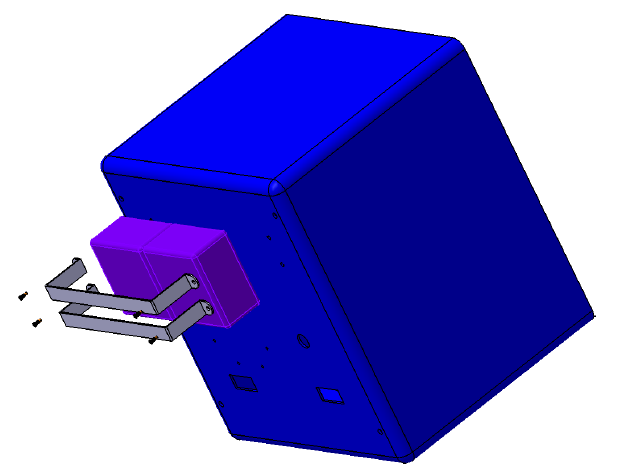
Estrutura/PC3/CAD final/bateria.PNG
