track-cooler/docs/Estrutura/PC3/CAD final/caixacocacola.jpg

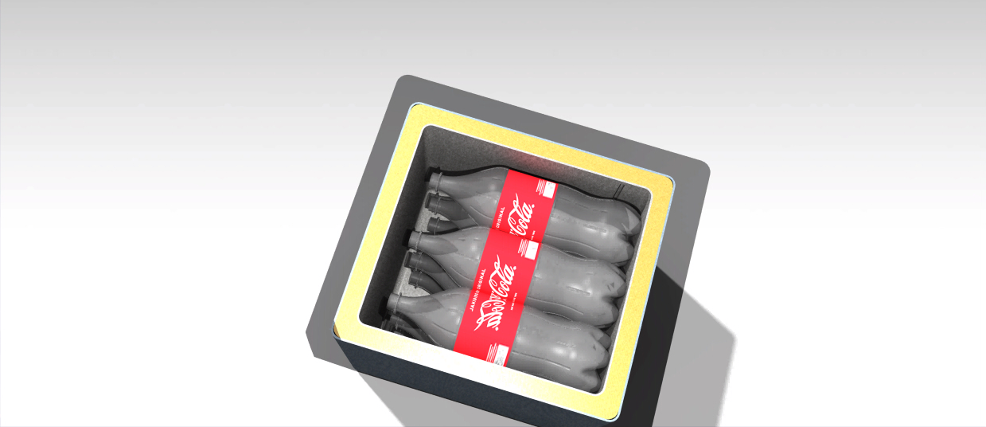
Estrutura/PC3/CAD final/caixacocacola.jpg
