track-cooler/docs/Estrutura/PC3/CAD final/caixalatascima.jpg

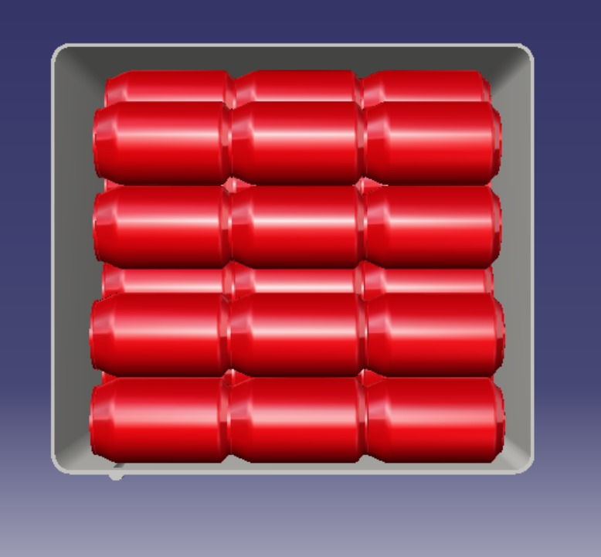
Estrutura/PC3/CAD final/caixalatascima.jpg
