track-cooler/docs/Estrutura/PC3/CAD final/caixalataslateral.jpg

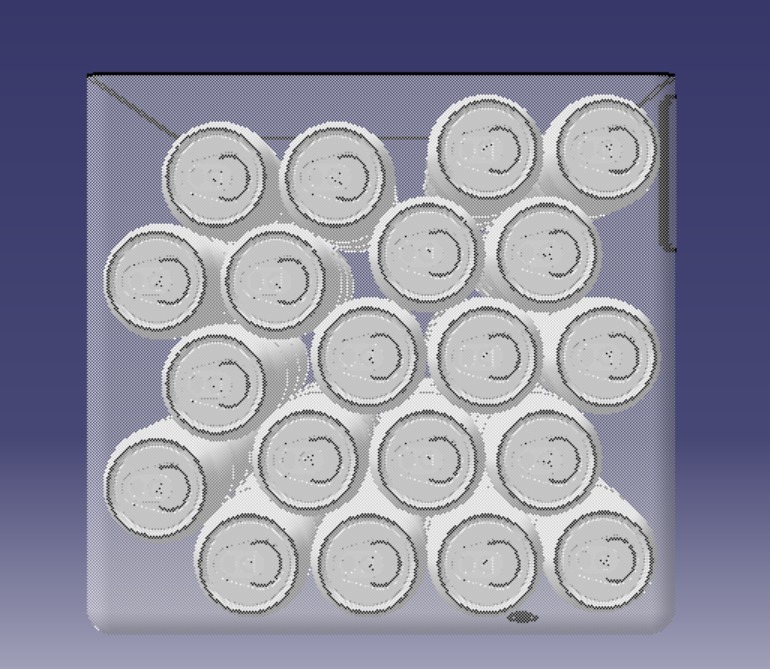
Estrutura/PC3/CAD final/caixalataslateral.jpg
