track-cooler/docs/Estrutura/PC3/CAD final/carreg.PNG

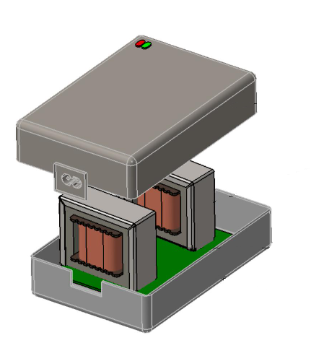
Estrutura/PC3/CAD final/carreg.PNG
