track-cooler/docs/Estrutura/PC3/CAD final/carregador1.jpg

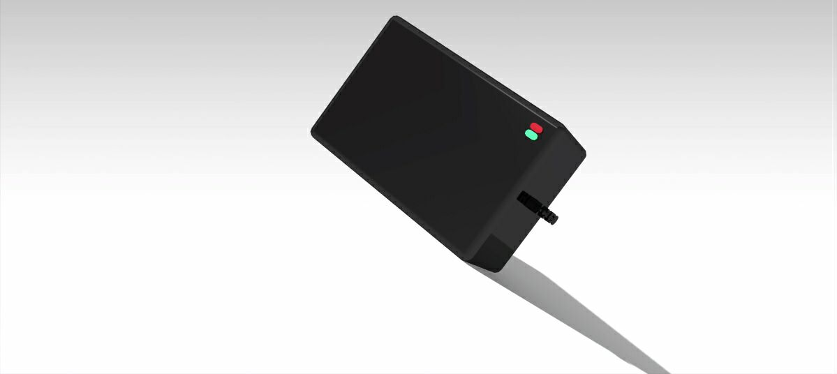
Estrutura/PC3/CAD final/carregador1.jpg
