track-cooler/docs/Estrutura/PC3/CAD final/carregador2.jpg

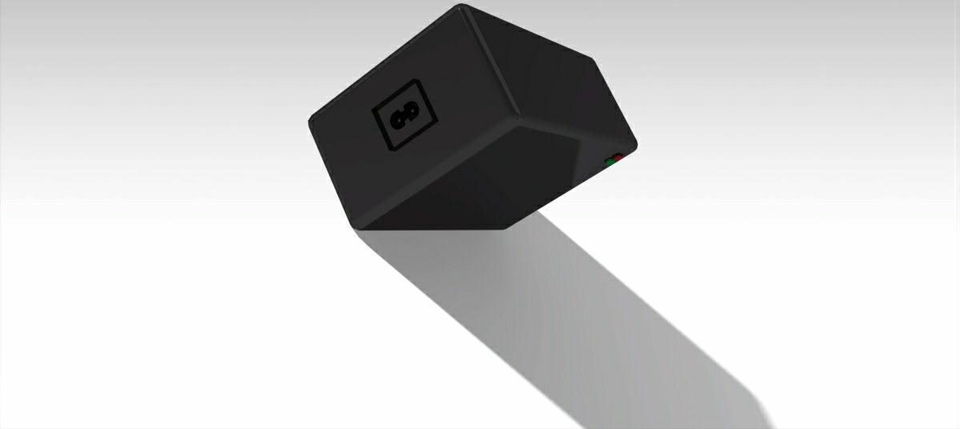
Estrutura/PC3/CAD final/carregador2.jpg
