track-cooler/docs/Estrutura/PC3/CAD final/Carregadorr.jpg

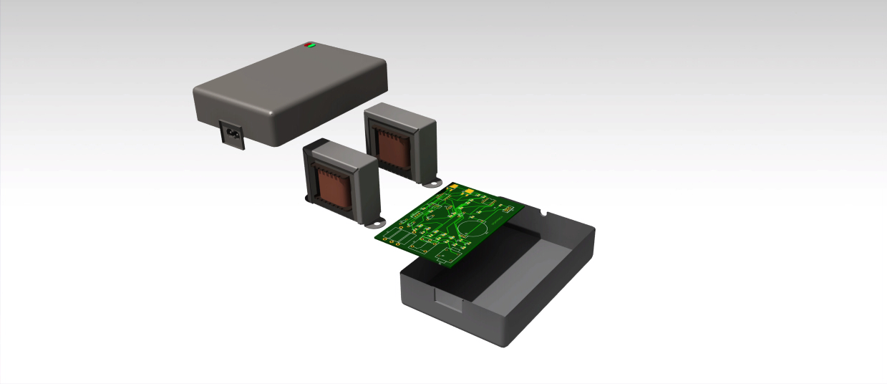
Estrutura/PC3/CAD final/Carregadorr.jpg
