track-cooler/docs/Estrutura/PC3/CAD final/coolerfinalfrente.jpg

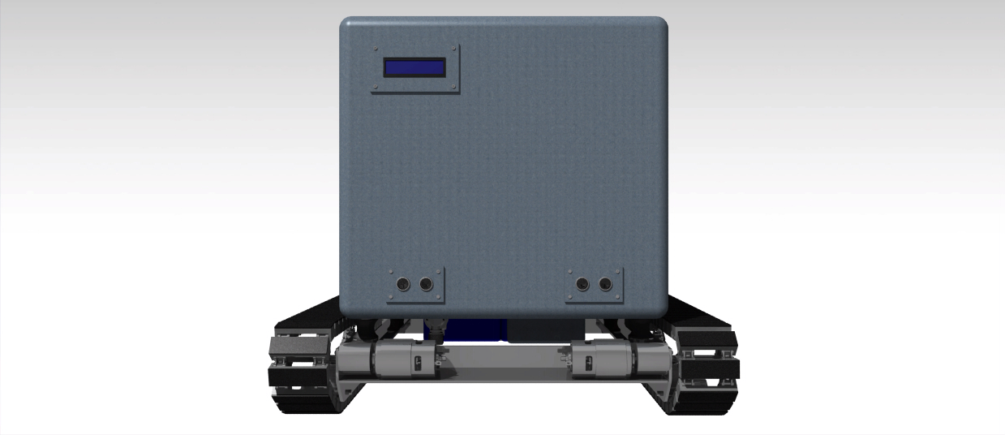
Estrutura/PC3/CAD final/coolerfinalfrente.jpg
