track-cooler/docs/Estrutura/PC3/CAD final/coolerfinalinferior.jpg

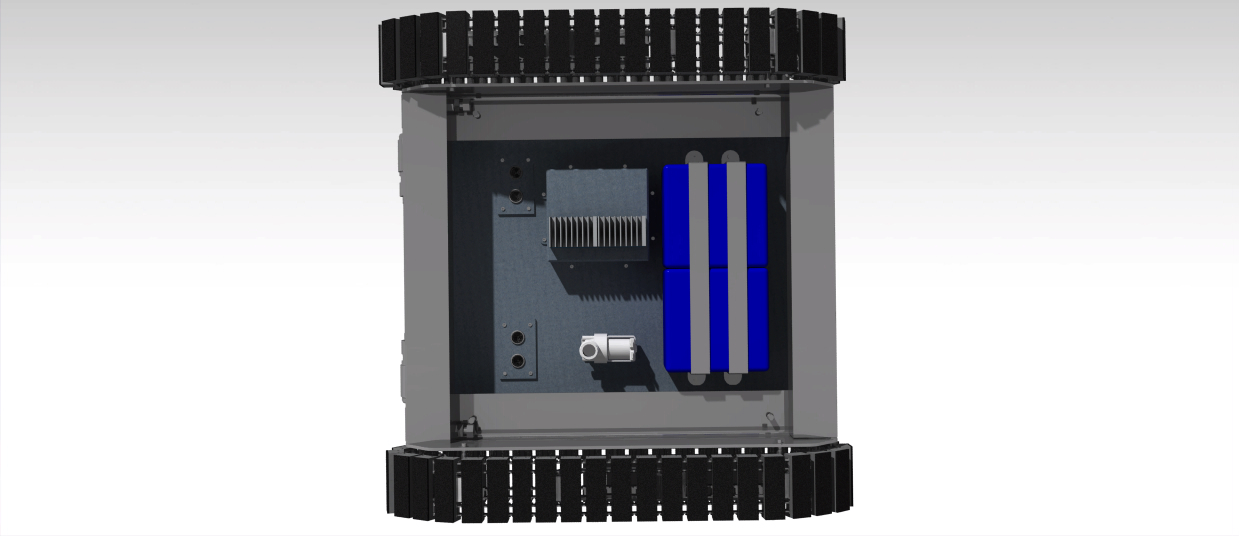
Estrutura/PC3/CAD final/coolerfinalinferior.jpg
