track-cooler/docs/Estrutura/PC3/CAD final/displaylcdcooler.jpg

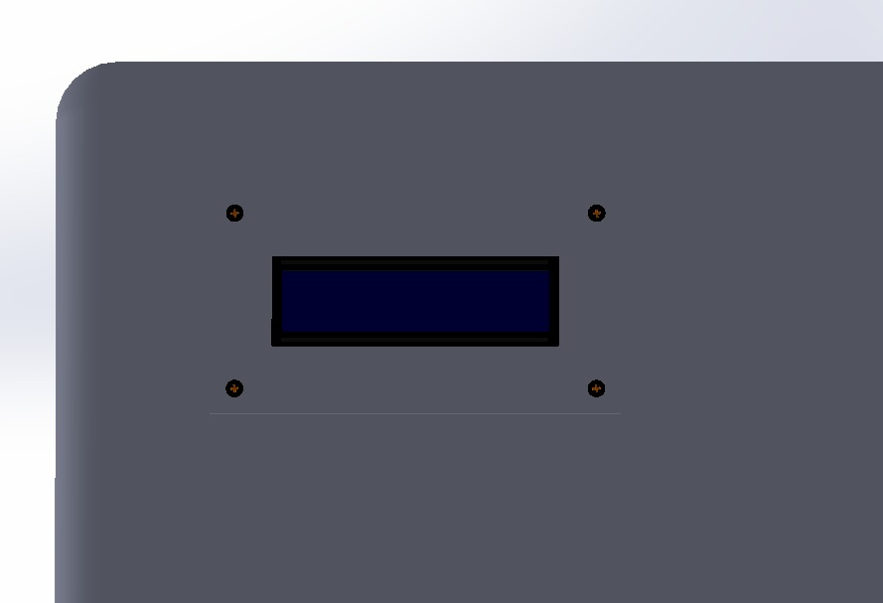
Estrutura/PC3/CAD final/displaylcdcooler.jpg
