track-cooler/docs/Estrutura/PC3/CAD final/interiorcaixa.jpg

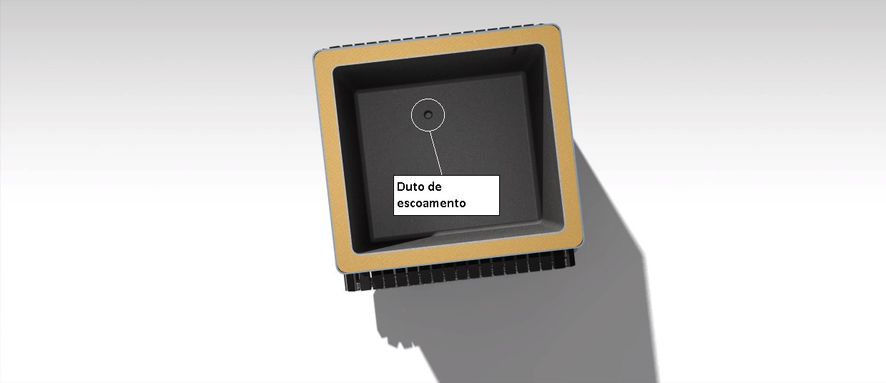
Estrutura/PC3/CAD final/interiorcaixa.jpg
