track-cooler/docs/Estrutura/PC3/CAD final/Interno.jpg

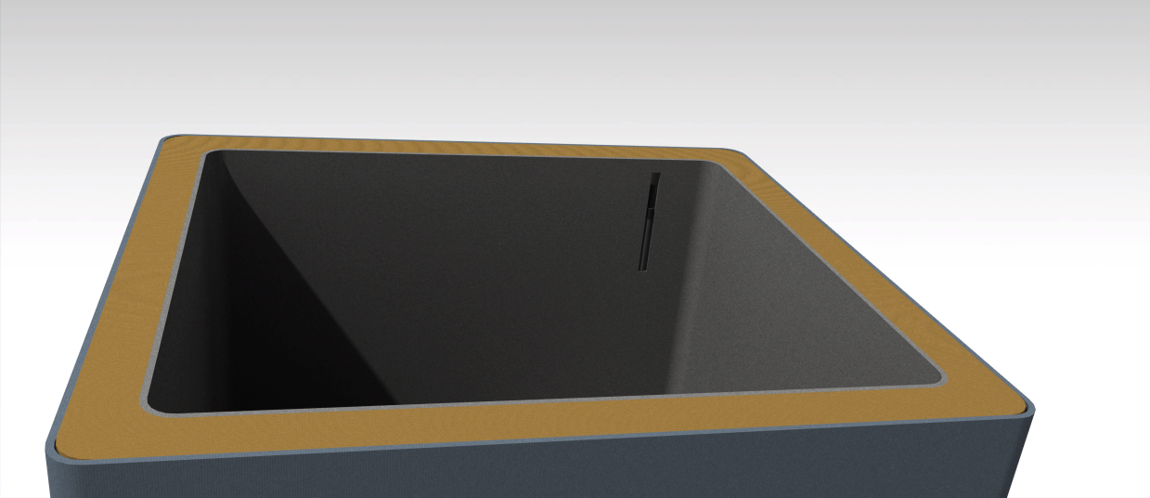
Estrutura/PC3/CAD final/Interno.jpg
