track-cooler/docs/Estrutura/PC3/CAD final/interruptor2.png

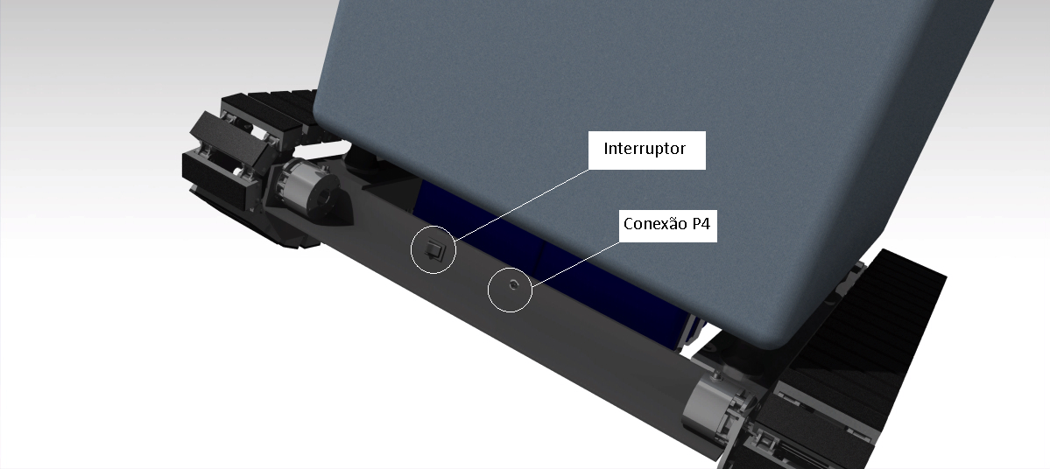
Estrutura/PC3/CAD final/interruptor2.png
