track-cooler/docs/Estrutura/PC3/CAD final/Manutenção.jpg

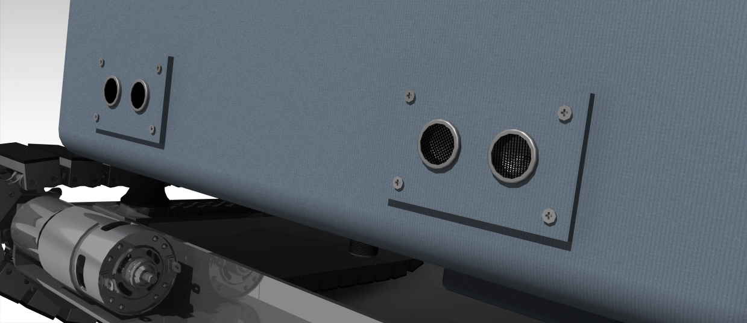
Estrutura/PC3/CAD final/Manutenção.jpg
