track-cooler/docs/Estrutura/PC3/CAD final/MoldeCaixa1.jpg

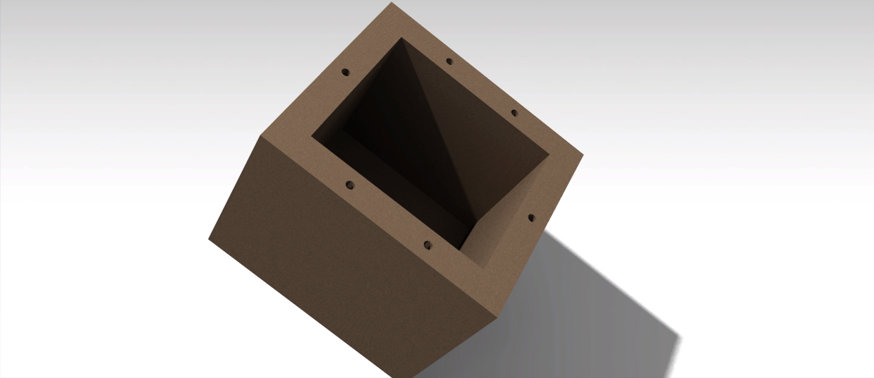
Estrutura/PC3/CAD final/MoldeCaixa1.jpg
