track-cooler/docs/Estrutura/PC3/CAD final/MoldeCaixa2.jpg

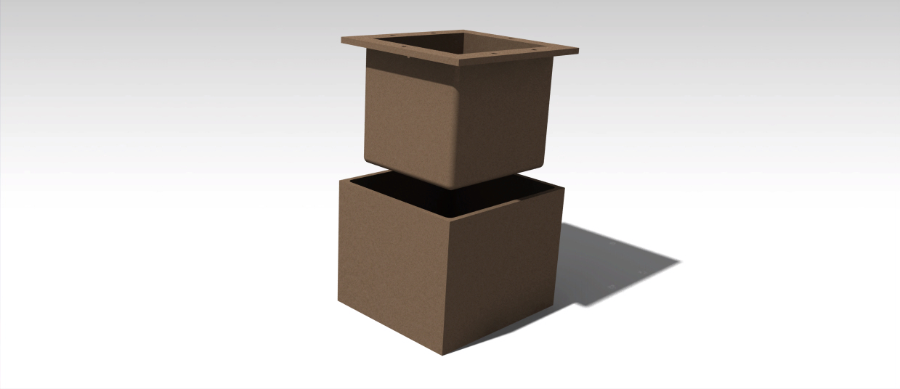
Estrutura/PC3/CAD final/MoldeCaixa2.jpg
