track-cooler/docs/Estrutura/PC3/CAD final/MoldeCaixa3.jpg

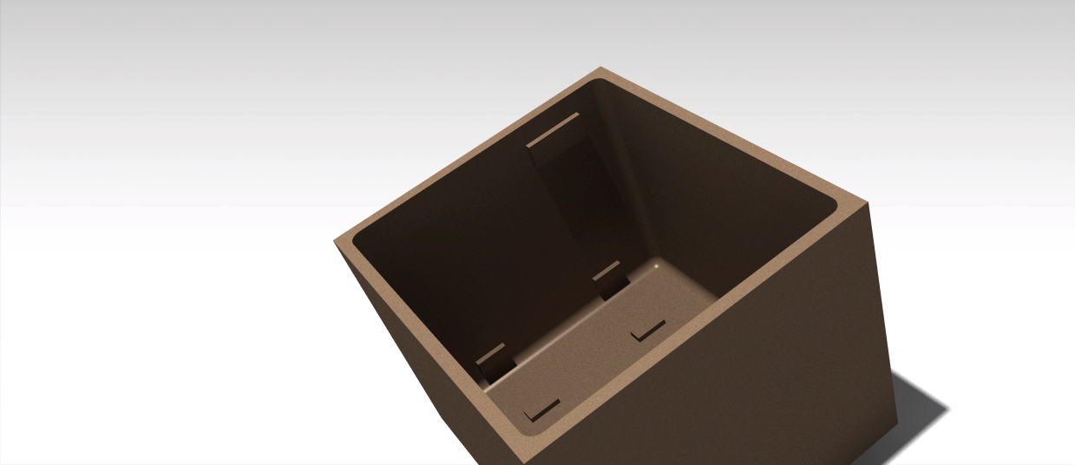
Estrutura/PC3/CAD final/MoldeCaixa3.jpg
