track-cooler/docs/Estrutura/PC3/CAD final/MoldeCaixa4.jpg

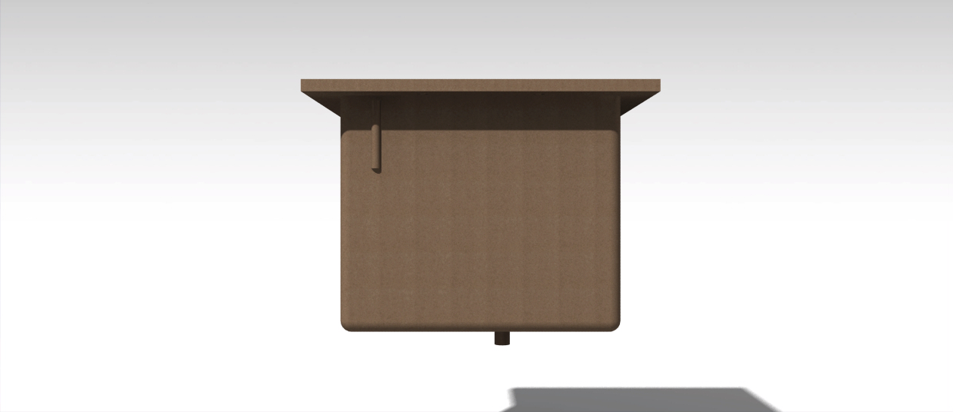
Estrutura/PC3/CAD final/MoldeCaixa4.jpg
