track-cooler/docs/Estrutura/PC3/CAD final/MoldeTampa1.jpg

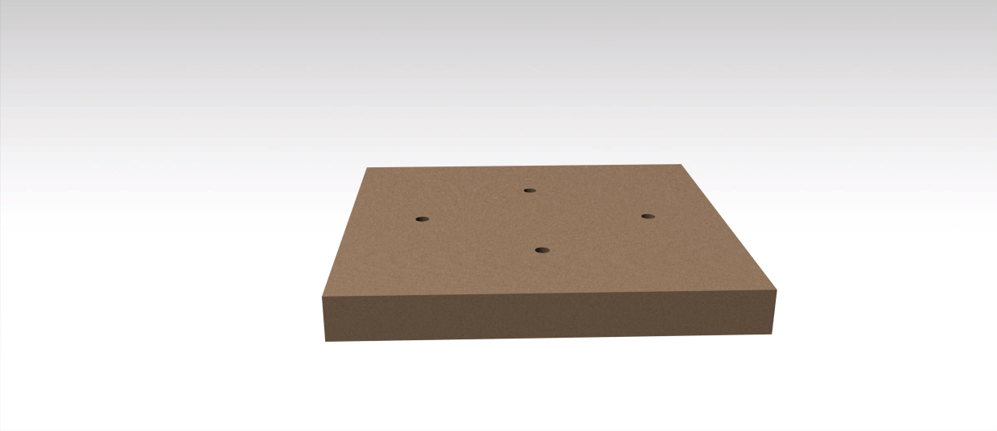
Estrutura/PC3/CAD final/MoldeTampa1.jpg
