track-cooler/docs/Estrutura/PC3/CAD final/MoldeTampa2.jpg

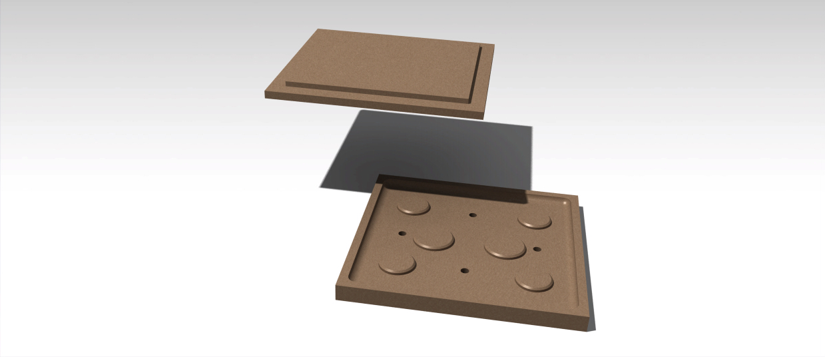
Estrutura/PC3/CAD final/MoldeTampa2.jpg
