track-cooler/docs/Estrutura/PC3/CAD final/ralo.jpg

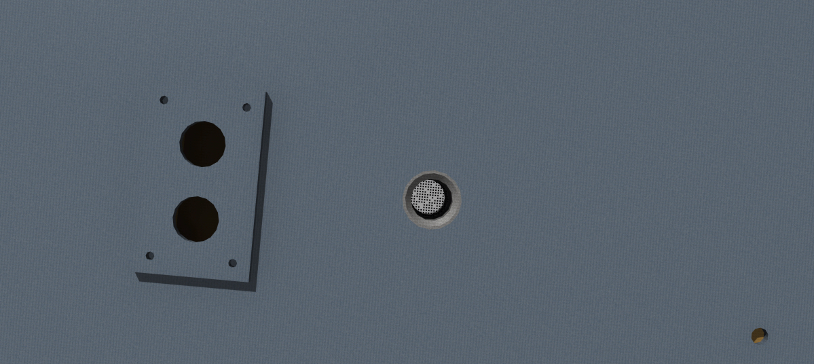
Estrutura/PC3/CAD final/ralo.jpg
