track-cooler/docs/Estrutura/PC3/CAD final/sensores.PNG

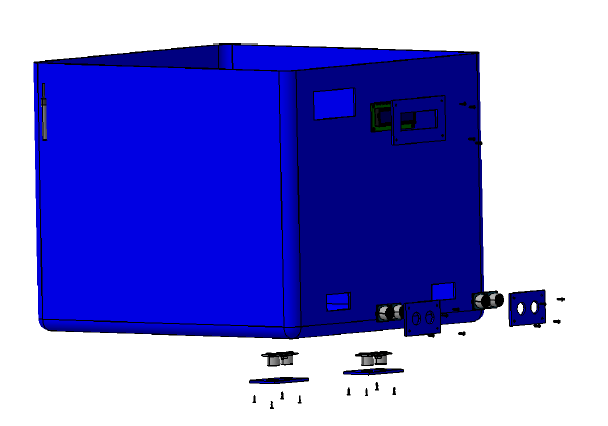
Estrutura/PC3/CAD final/sensores.PNG
