track-cooler/docs/Estrutura/PC3/CAD final/TampaManutençao.jpg

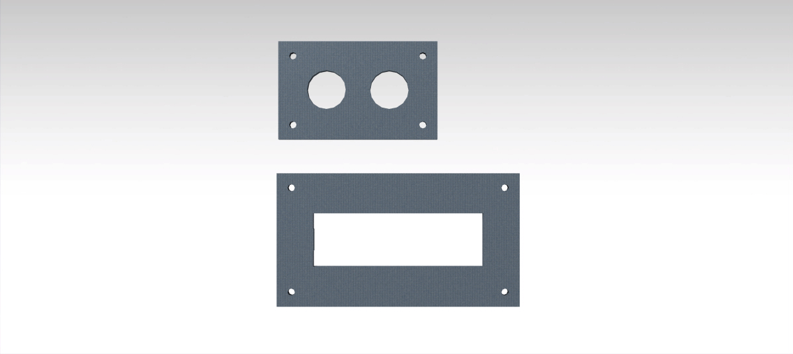
Estrutura/PC3/CAD final/TampaManutençao.jpg
