track-cooler/docs/Estrutura/PC3/CAD final/valvula.PNG

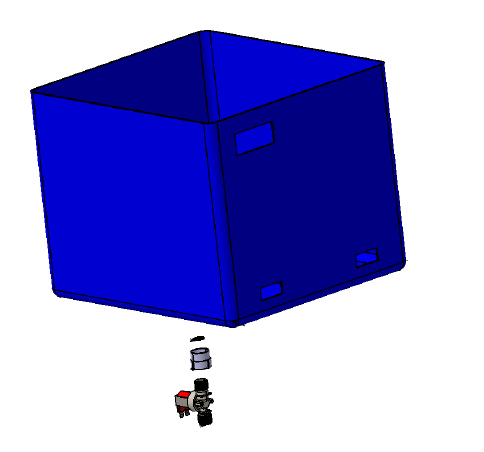
Estrutura/PC3/CAD final/valvula.PNG
