track-cooler/docs/Estrutura/PC3/Desenhos técnicos/0001.jpg

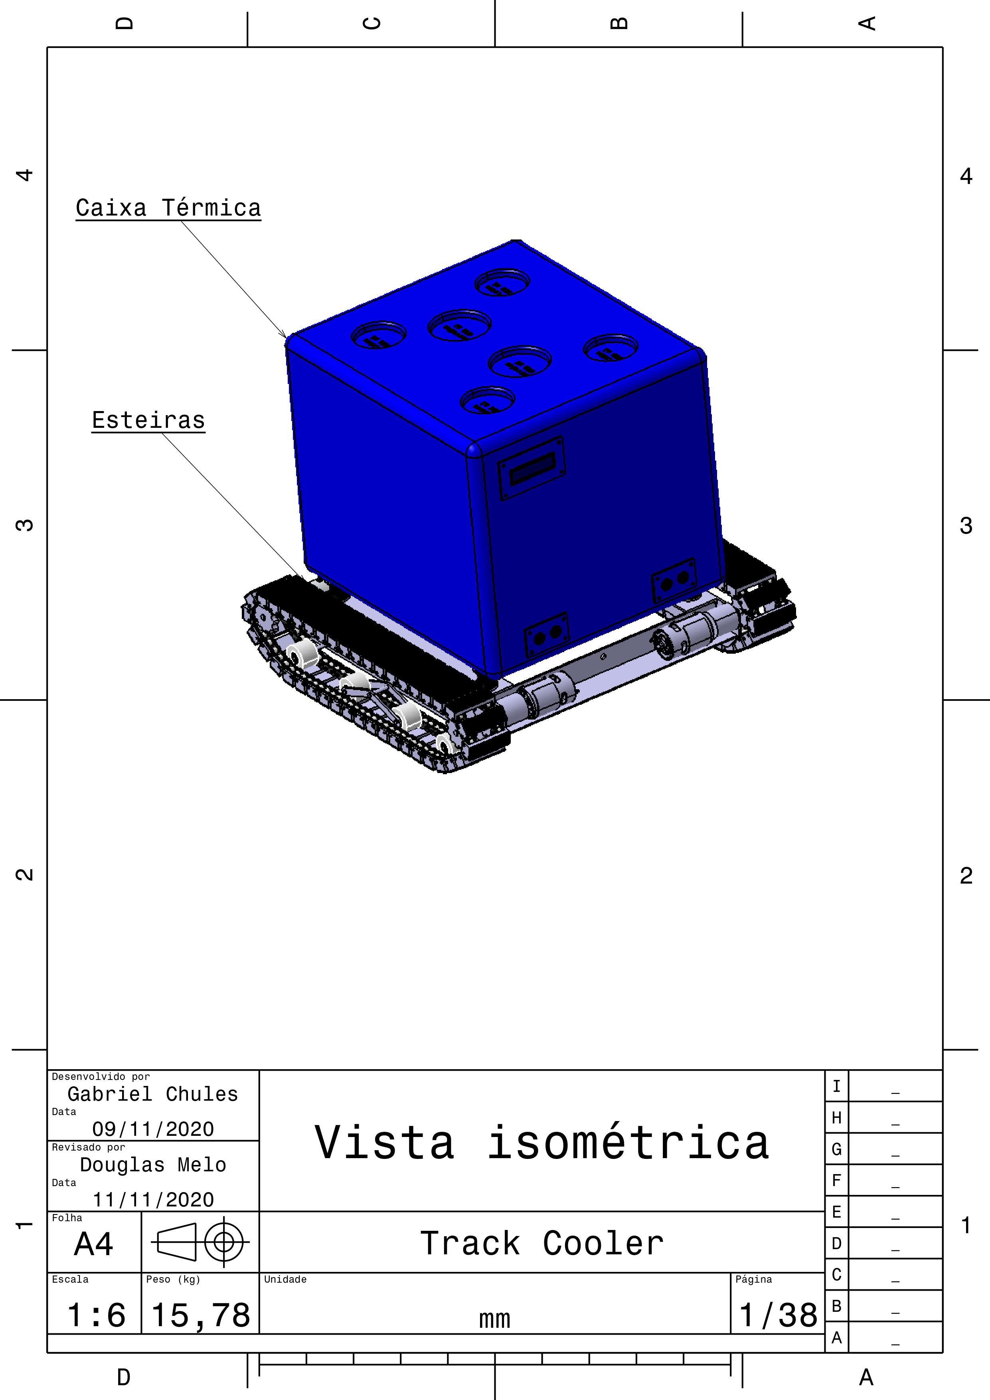
Estrutura/PC3/Desenhos técnicos/0001.jpg
