track-cooler/docs/Estrutura/PC3/Desenhos técnicos/0002.jpg

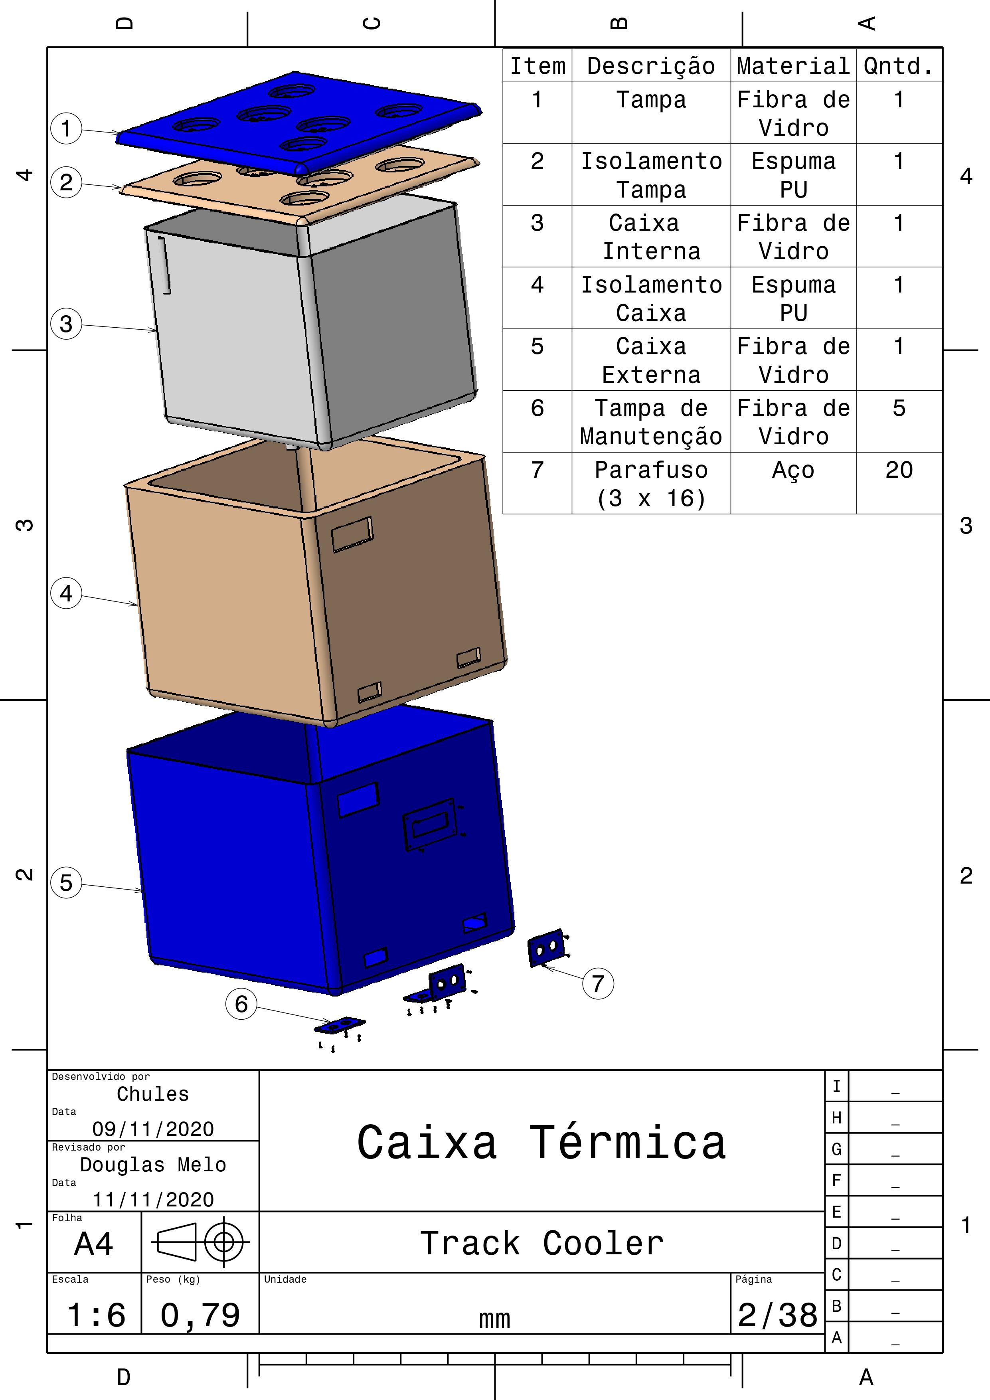
Estrutura/PC3/Desenhos técnicos/0002.jpg
