track-cooler/docs/Estrutura/PC3/Desenhos técnicos/0003.jpg

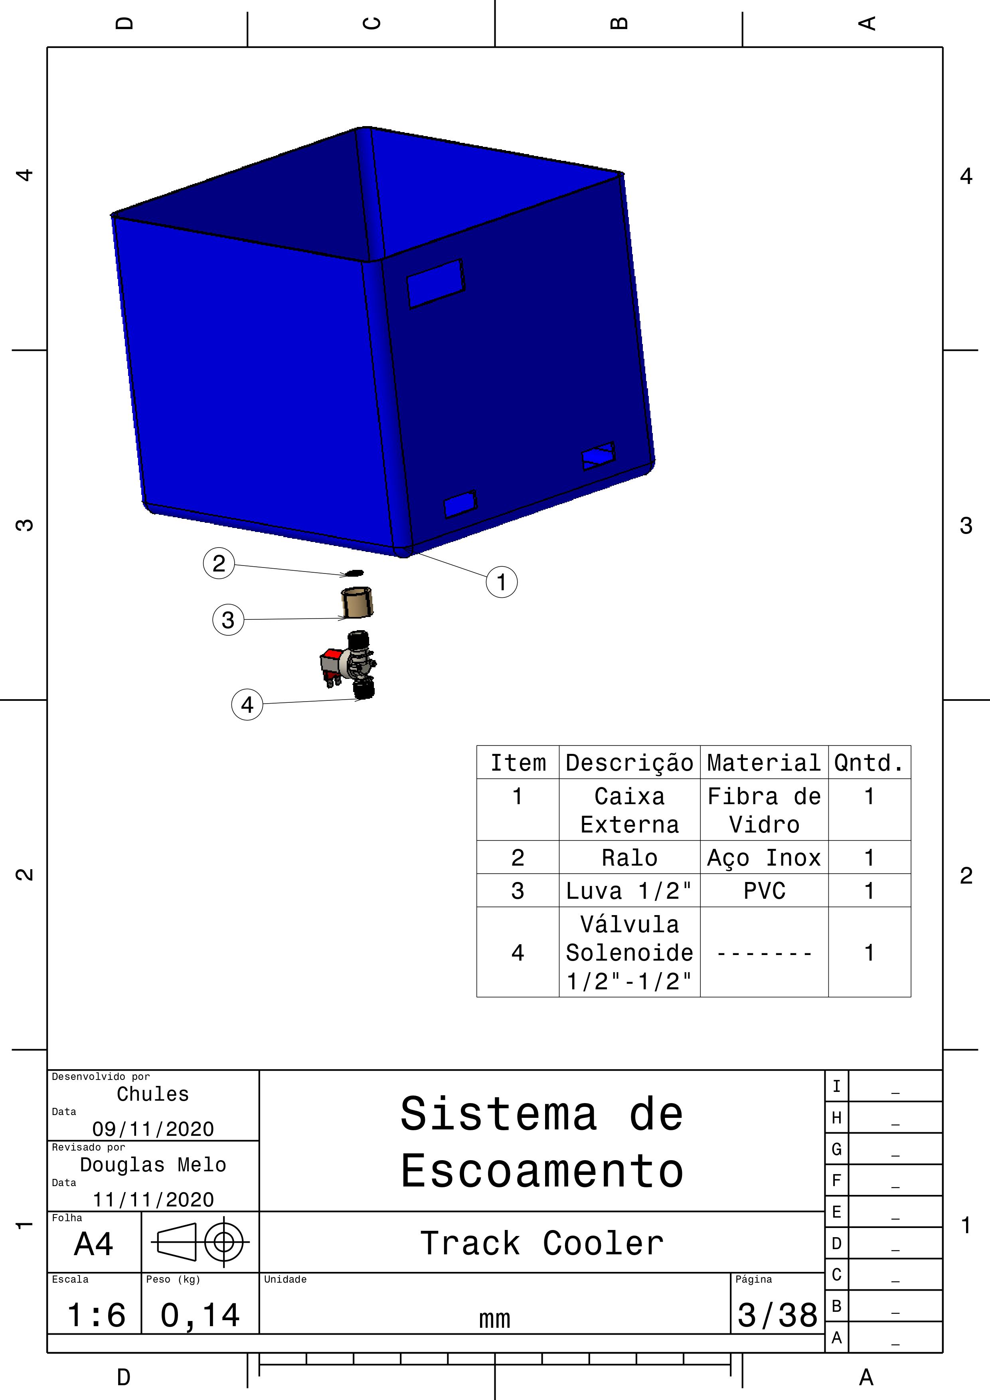
Estrutura/PC3/Desenhos técnicos/0003.jpg
