track-cooler/docs/Estrutura/PC3/Desenhos técnicos/0004.jpg

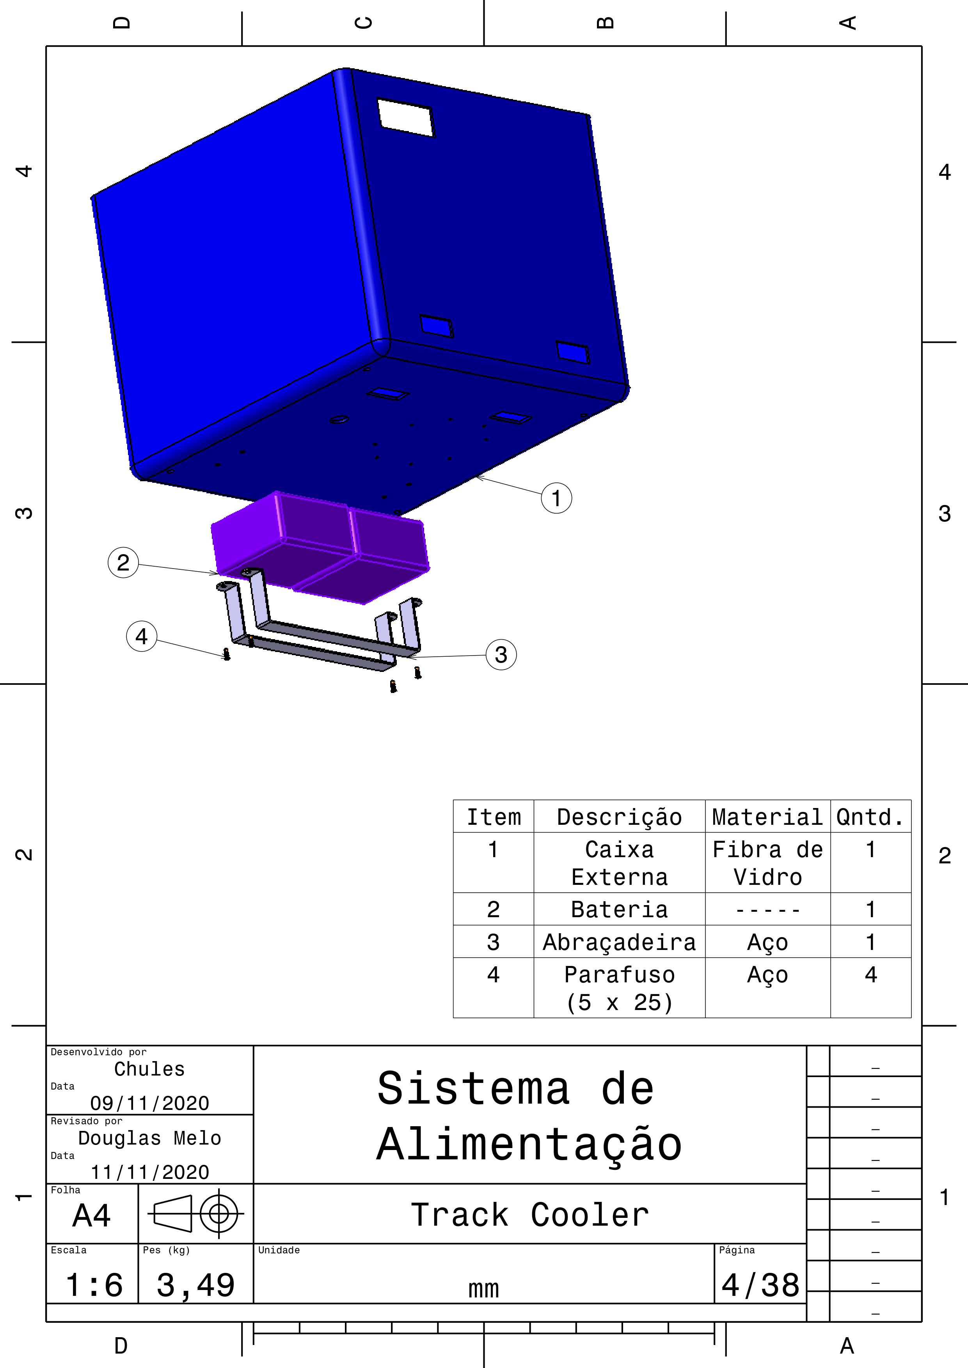
Estrutura/PC3/Desenhos técnicos/0004.jpg
