track-cooler/docs/Estrutura/PC3/Desenhos técnicos/0005.jpg

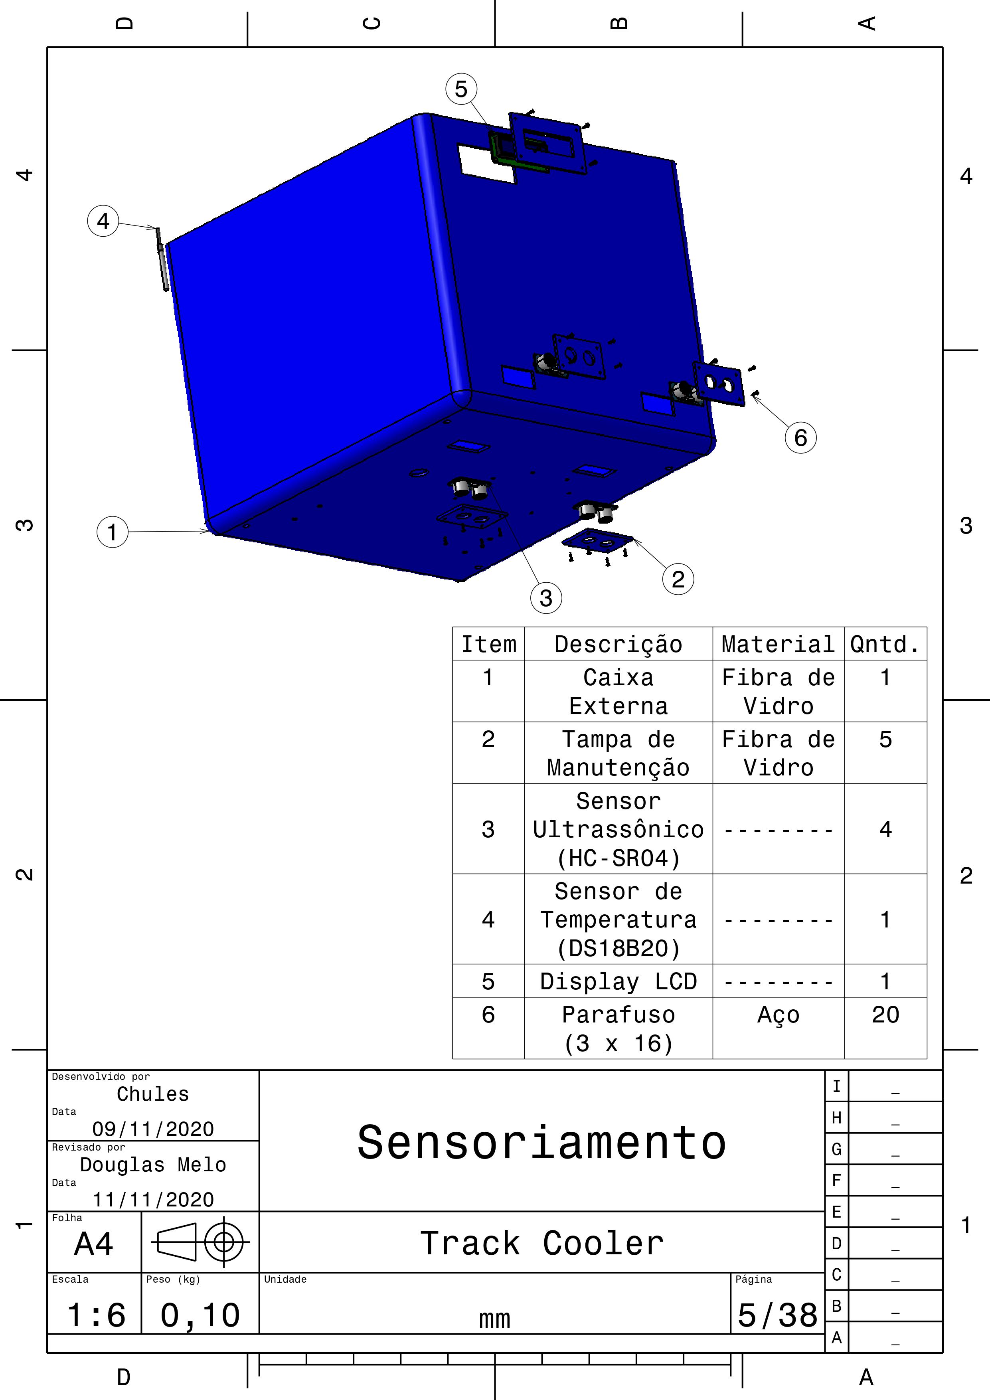
Estrutura/PC3/Desenhos técnicos/0005.jpg
