track-cooler/docs/Estrutura/PC3/Desenhos técnicos/0006.jpg

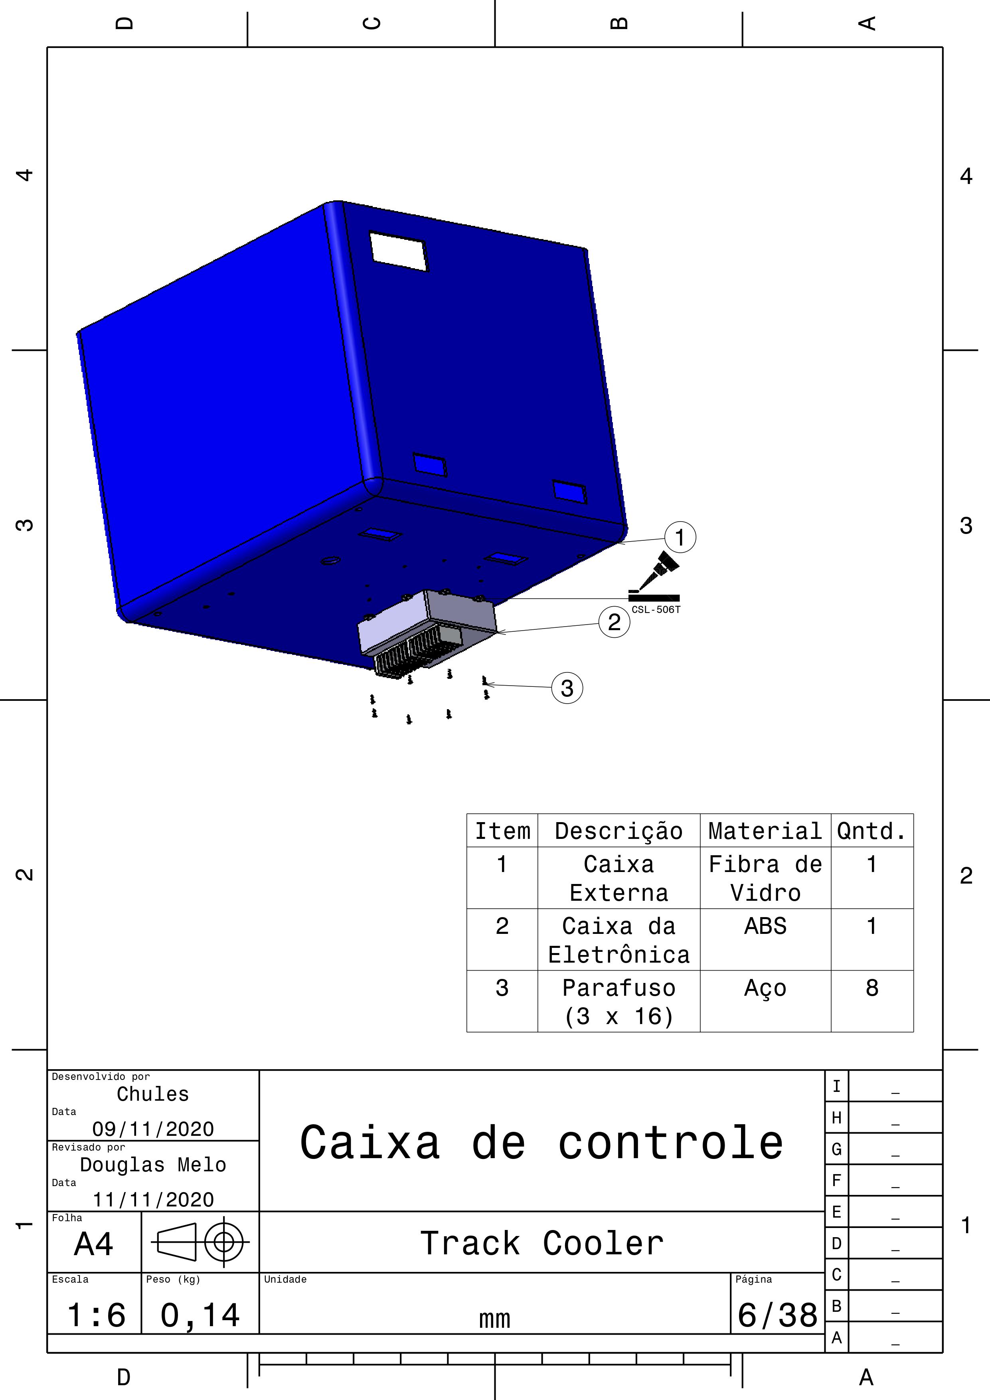
Estrutura/PC3/Desenhos técnicos/0006.jpg
