track-cooler/docs/Estrutura/PC3/Desenhos técnicos/0007.jpg

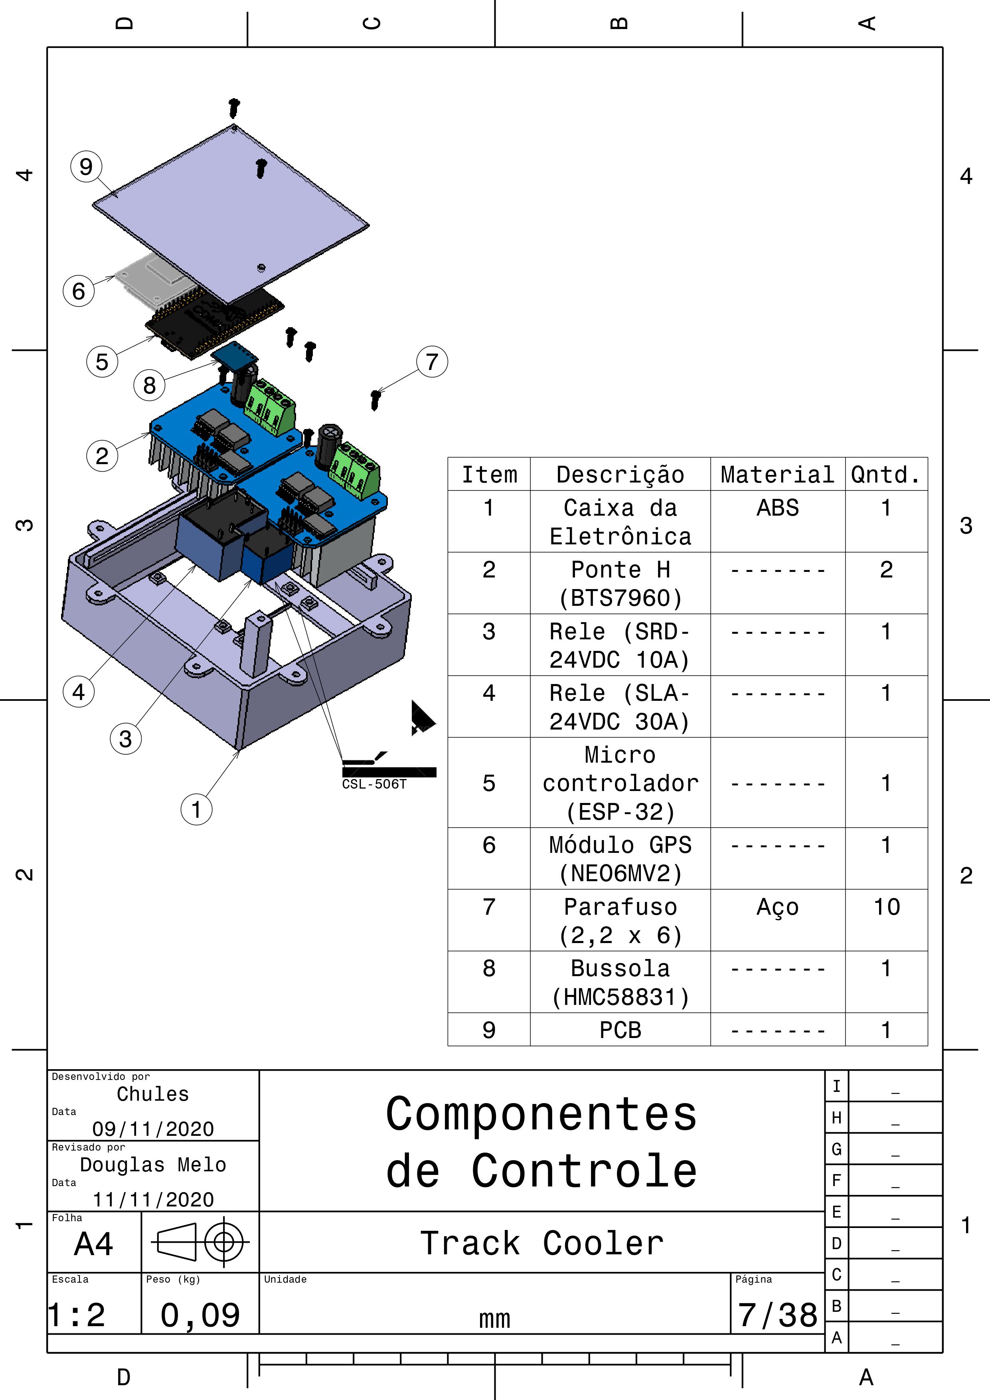
Estrutura/PC3/Desenhos técnicos/0007.jpg
