track-cooler/docs/Estrutura/PC3/Desenhos técnicos/0008.jpg

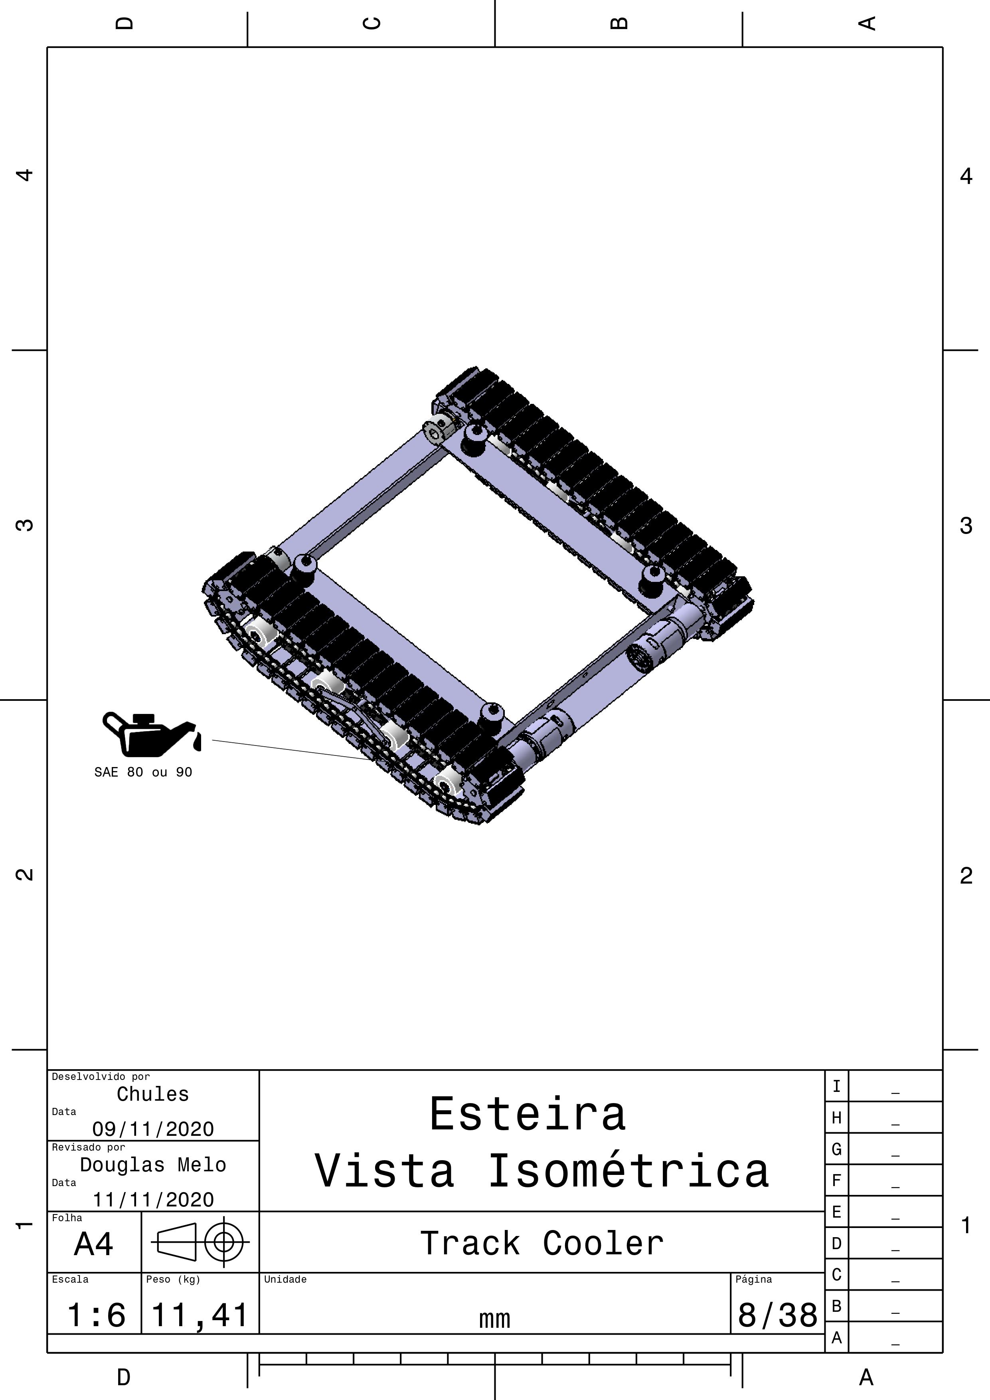
Estrutura/PC3/Desenhos técnicos/0008.jpg
