track-cooler/docs/Estrutura/PC3/Desenhos técnicos/0009.jpg

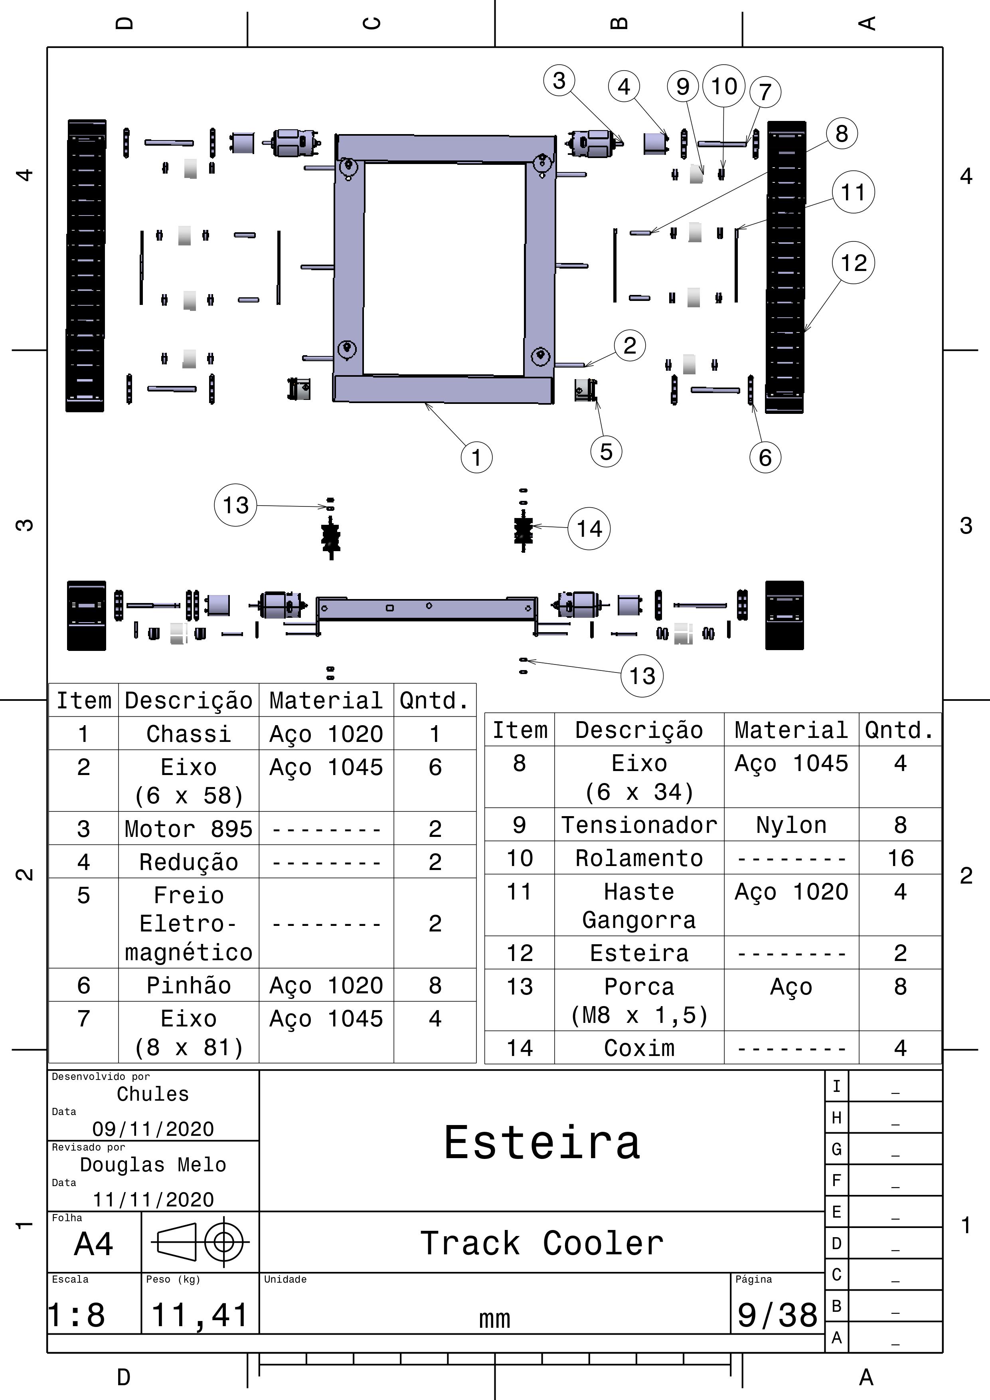
Estrutura/PC3/Desenhos técnicos/0009.jpg
