track-cooler/docs/Estrutura/PC3/Desenhos técnicos/0010.jpg

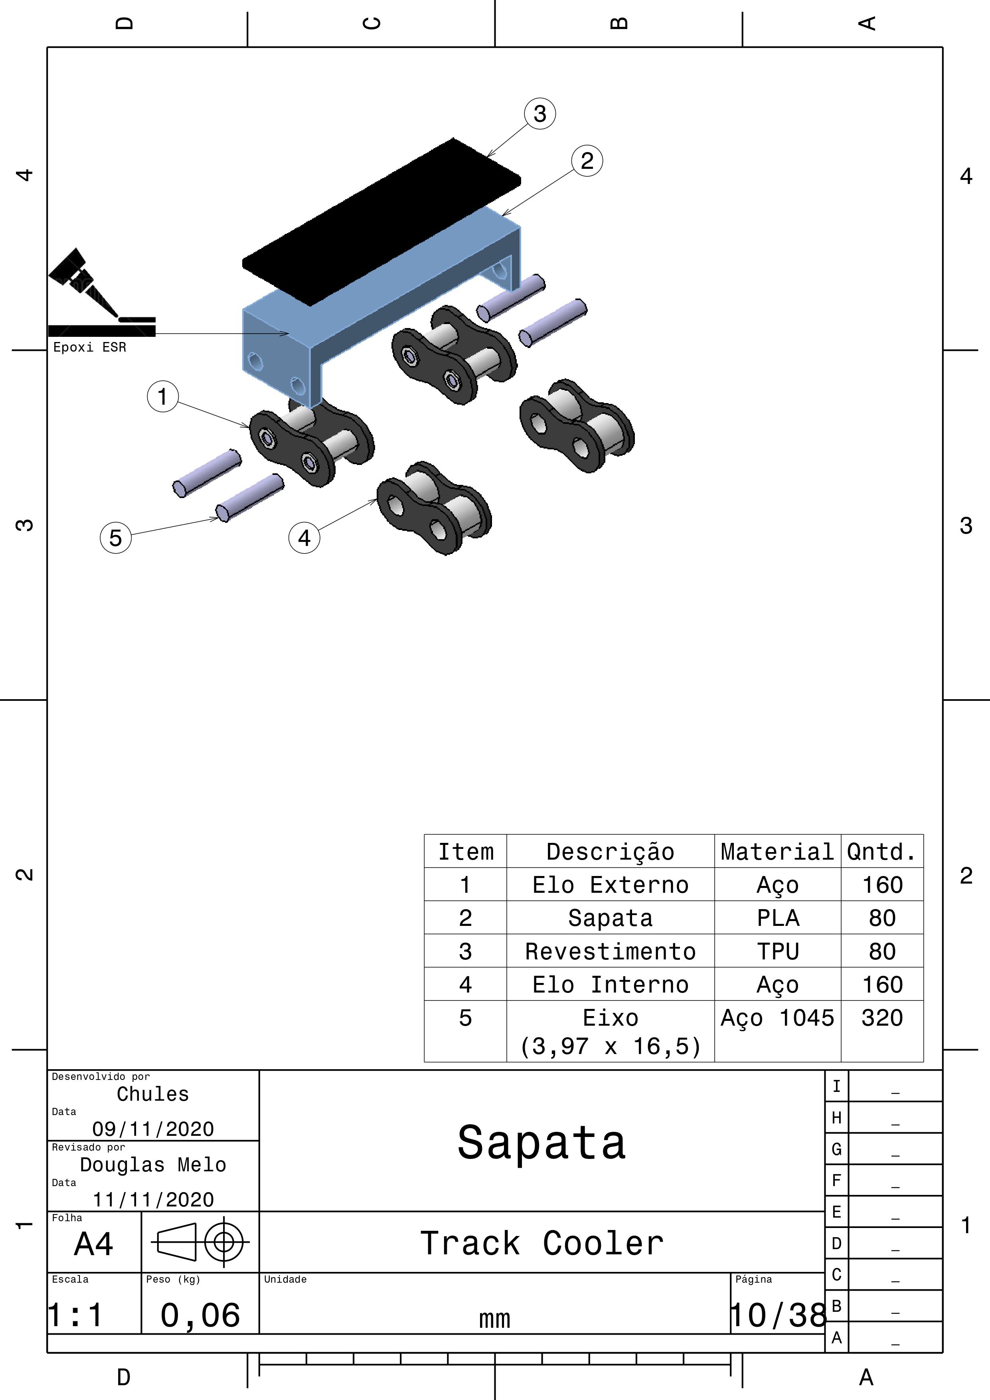
Estrutura/PC3/Desenhos técnicos/0010.jpg
