track-cooler/docs/Estrutura/PC3/Desenhos técnicos/0011.jpg

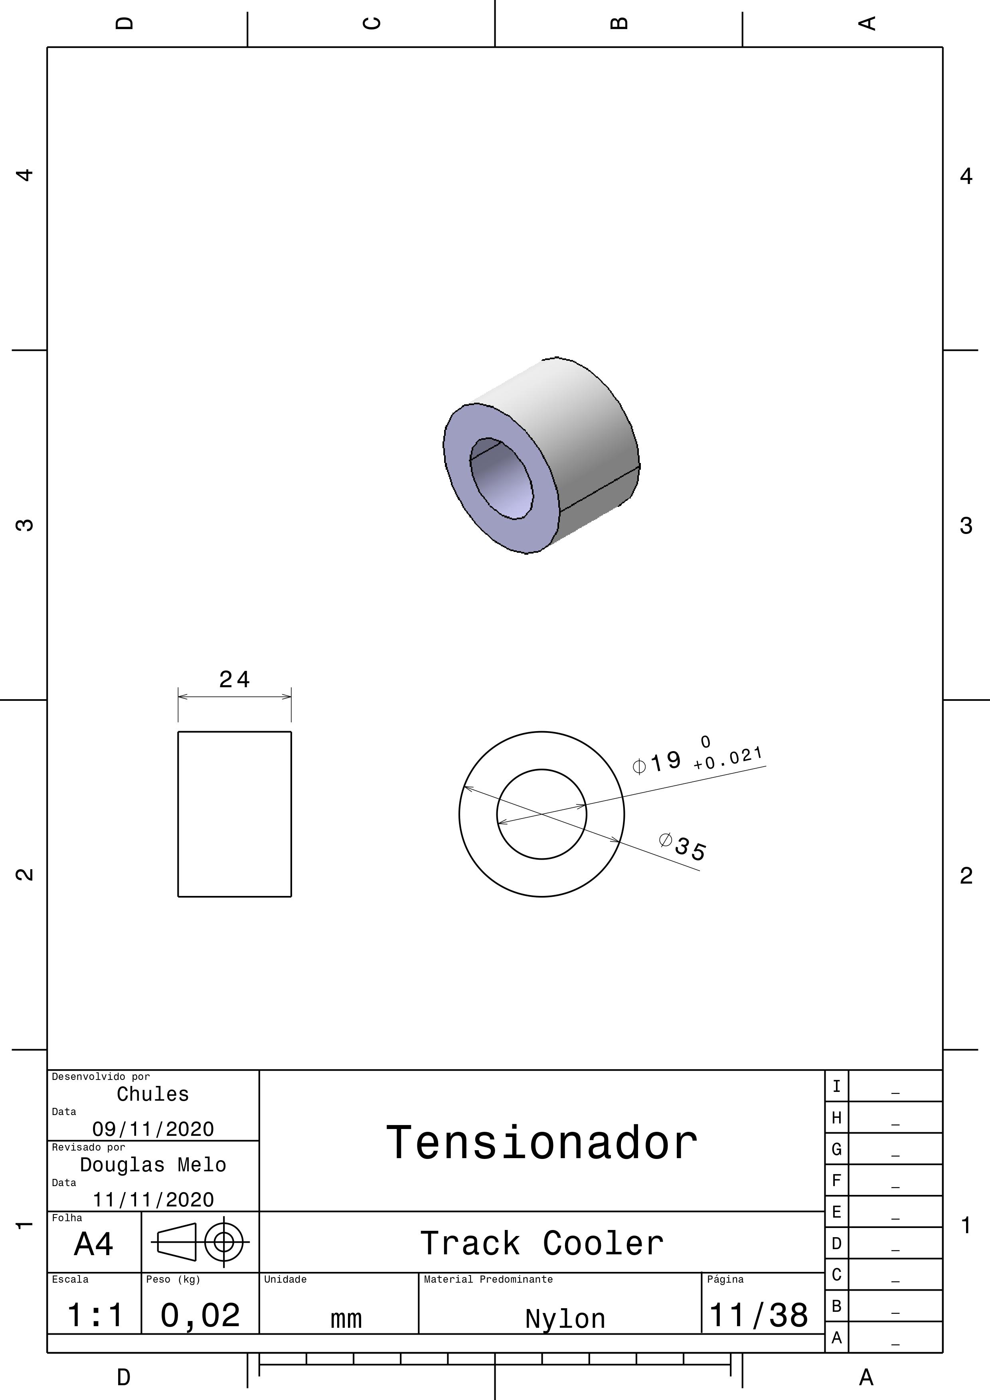
Estrutura/PC3/Desenhos técnicos/0011.jpg
