track-cooler/docs/Estrutura/PC3/Desenhos técnicos/0012.jpg

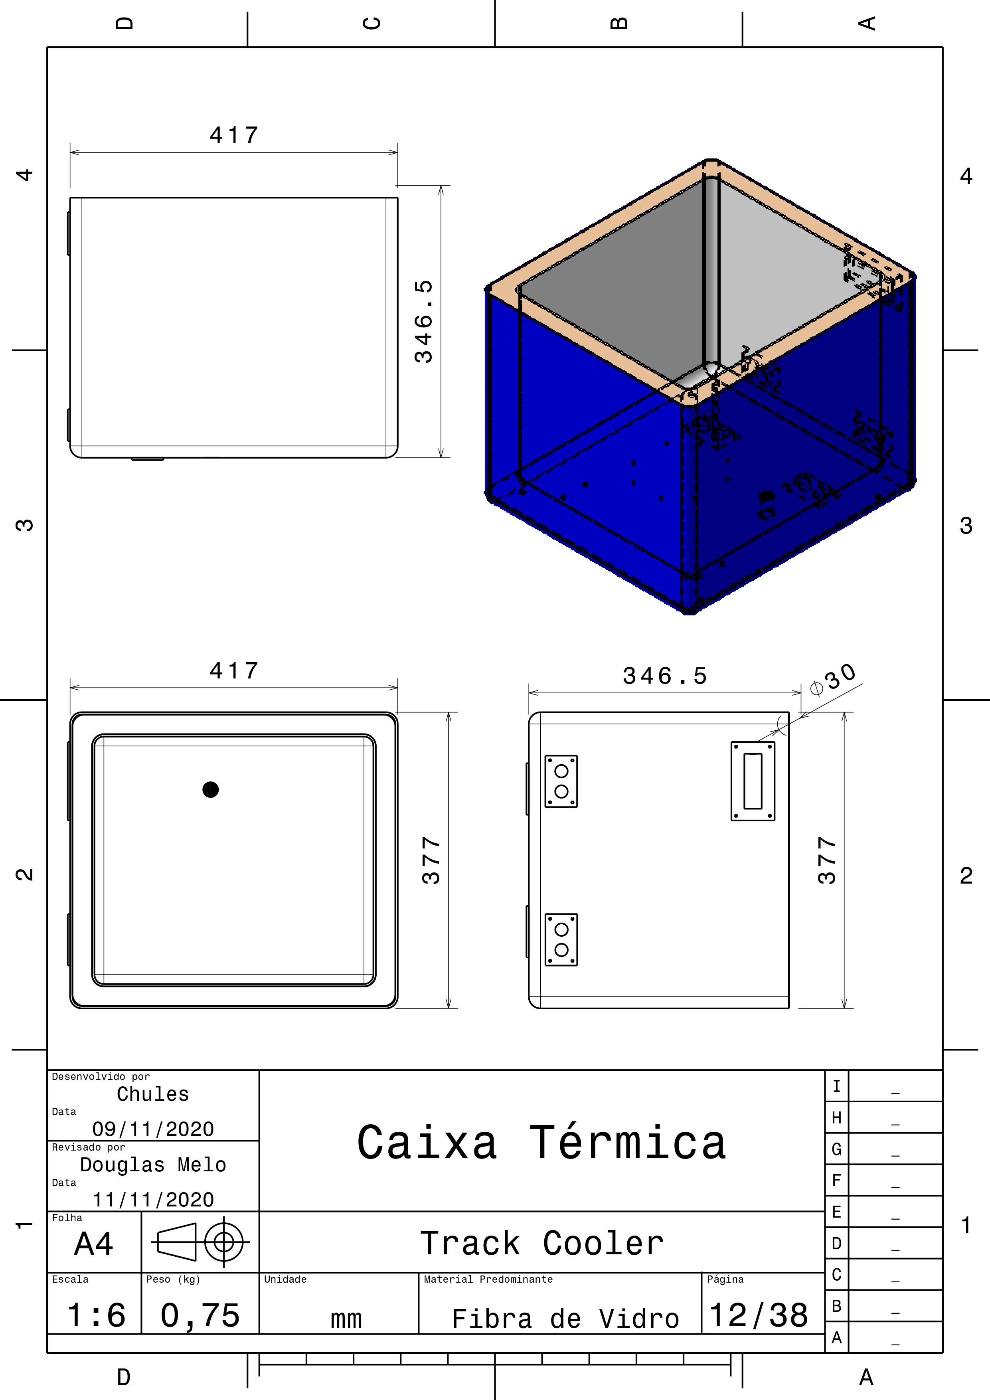
Estrutura/PC3/Desenhos técnicos/0012.jpg
