track-cooler/docs/Estrutura/PC3/Desenhos técnicos/0013.jpg

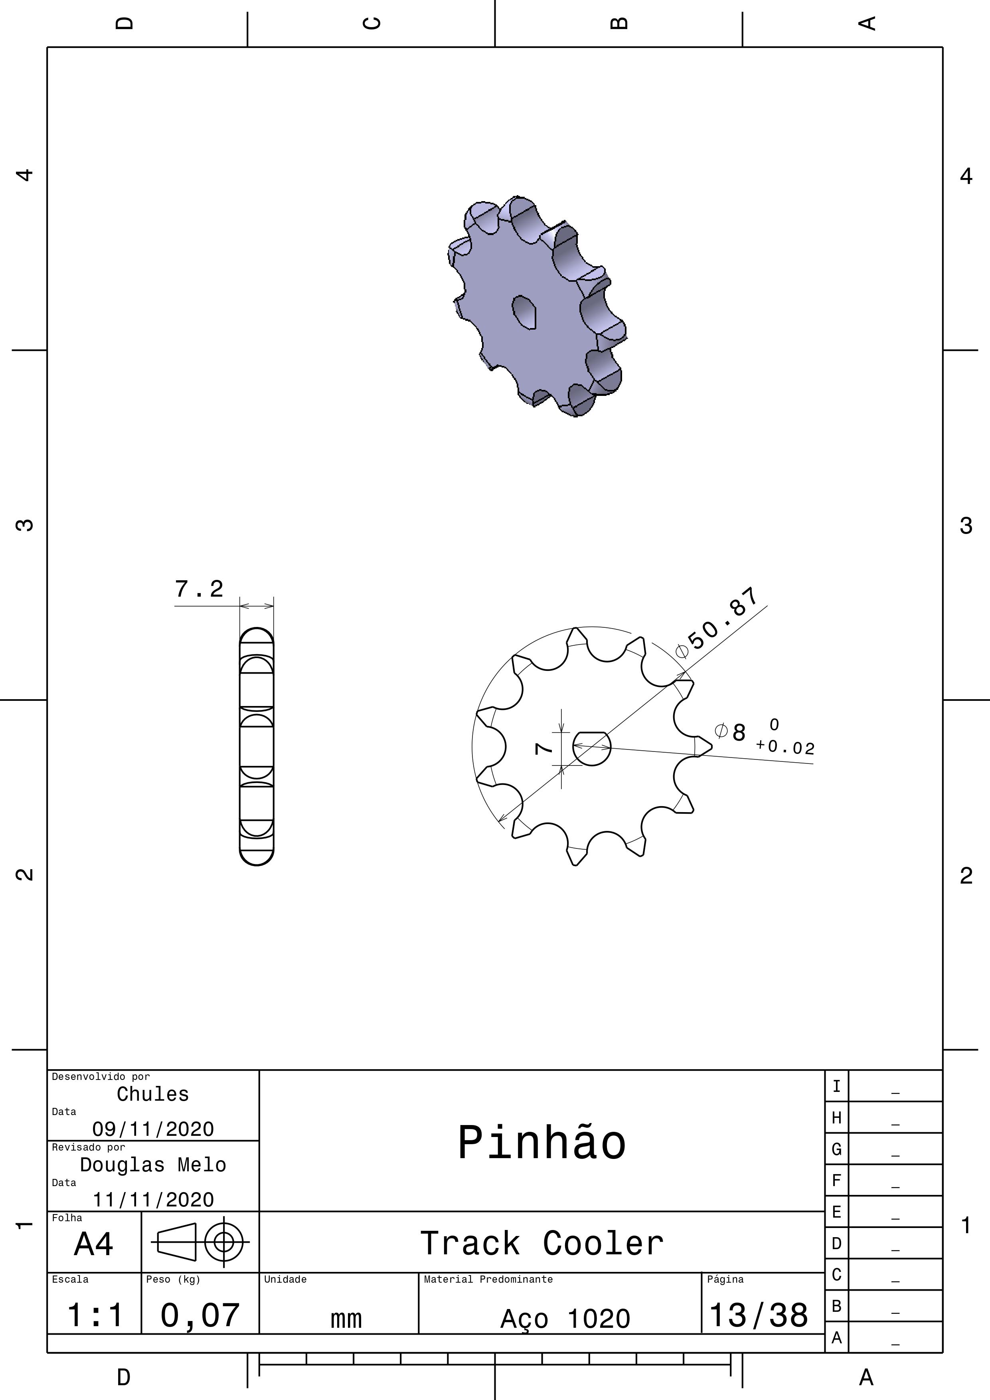
Estrutura/PC3/Desenhos técnicos/0013.jpg
