track-cooler/docs/Estrutura/PC3/Desenhos técnicos/0014.jpg

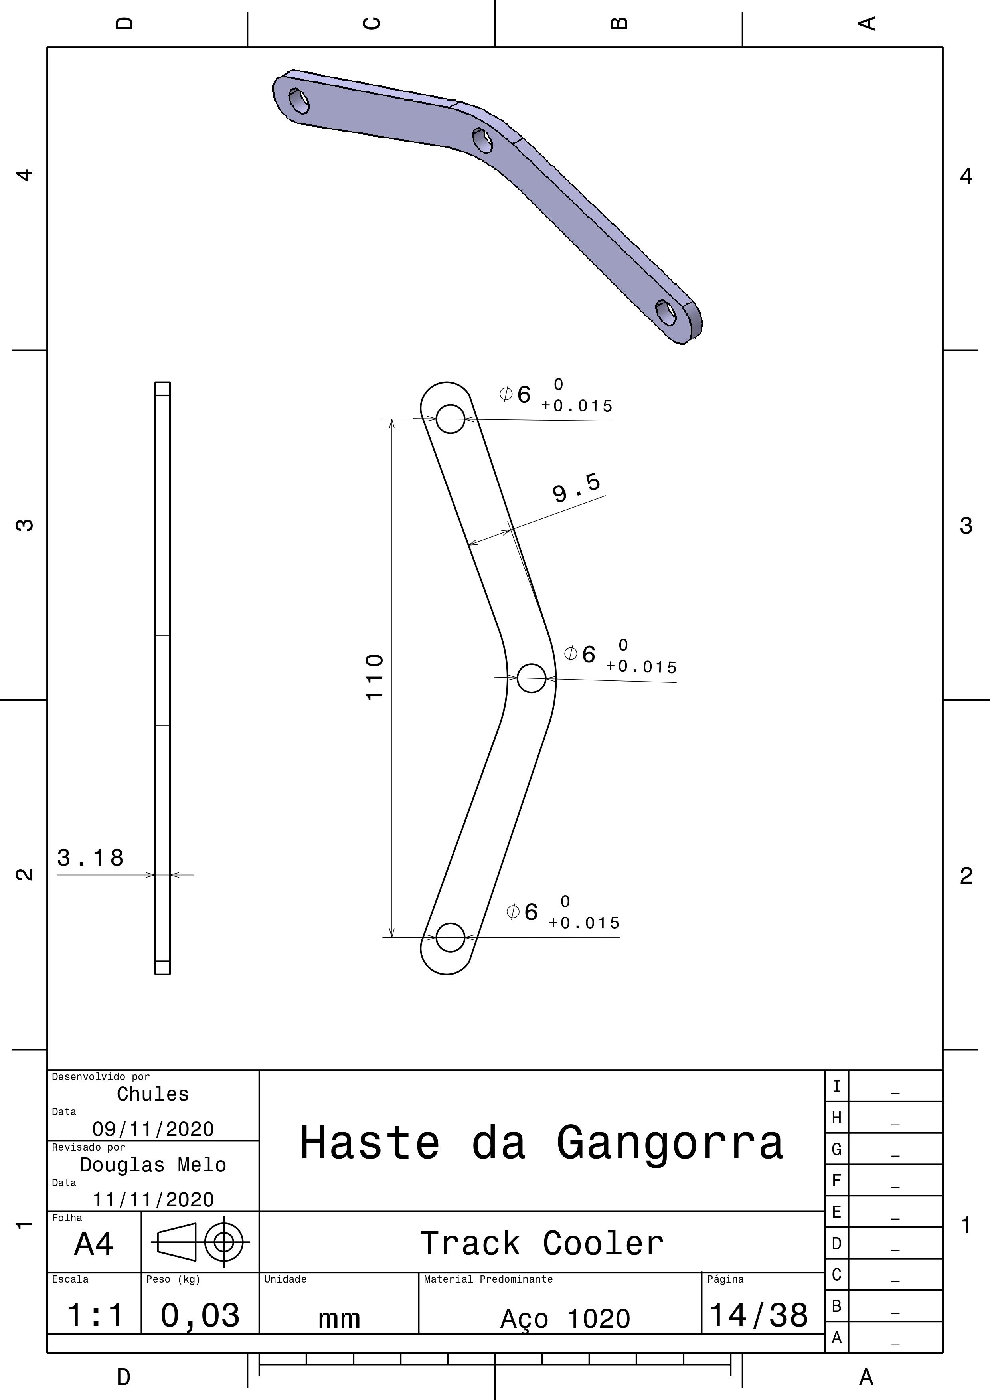
Estrutura/PC3/Desenhos técnicos/0014.jpg
