track-cooler/docs/Estrutura/PC3/Desenhos técnicos/0015.jpg

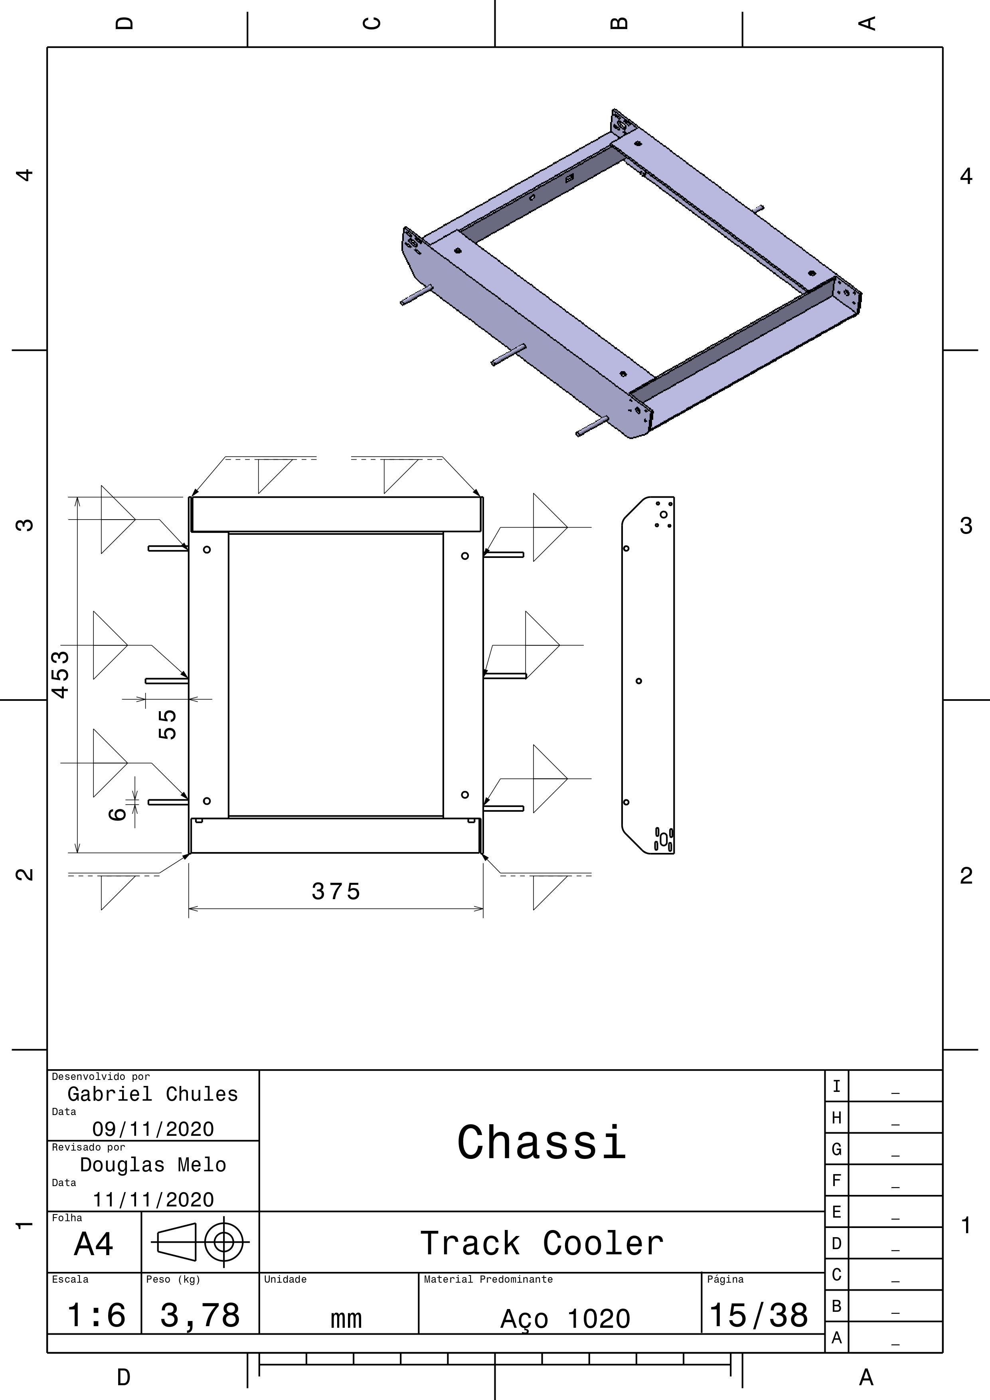
Estrutura/PC3/Desenhos técnicos/0015.jpg
