track-cooler/docs/Estrutura/PC3/Desenhos técnicos/0016.jpg

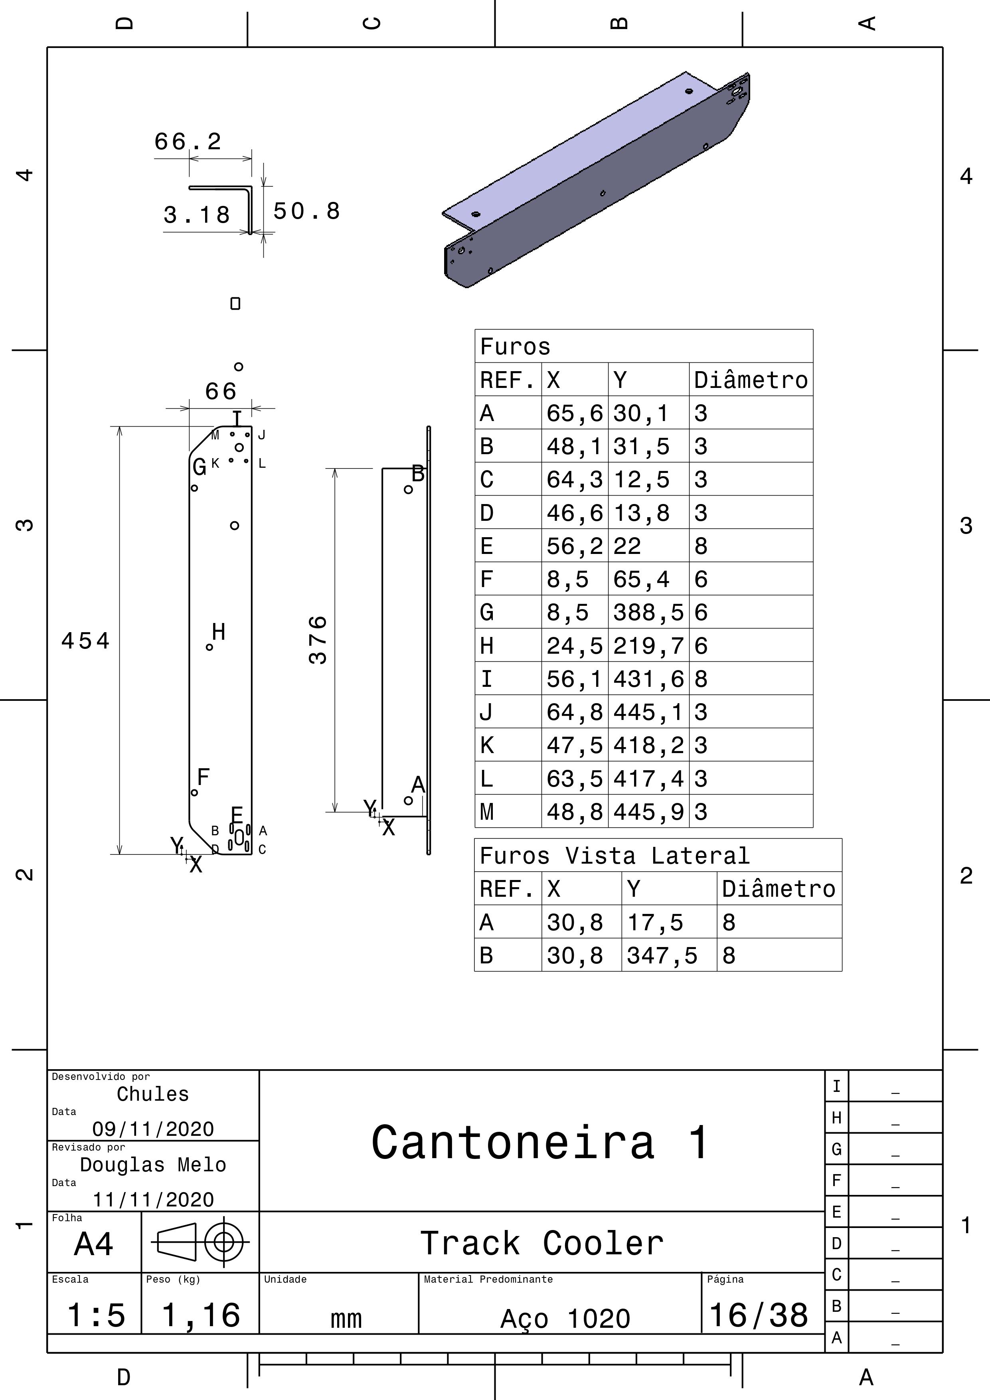
Estrutura/PC3/Desenhos técnicos/0016.jpg
