track-cooler/docs/Estrutura/PC3/Desenhos técnicos/0017.jpg

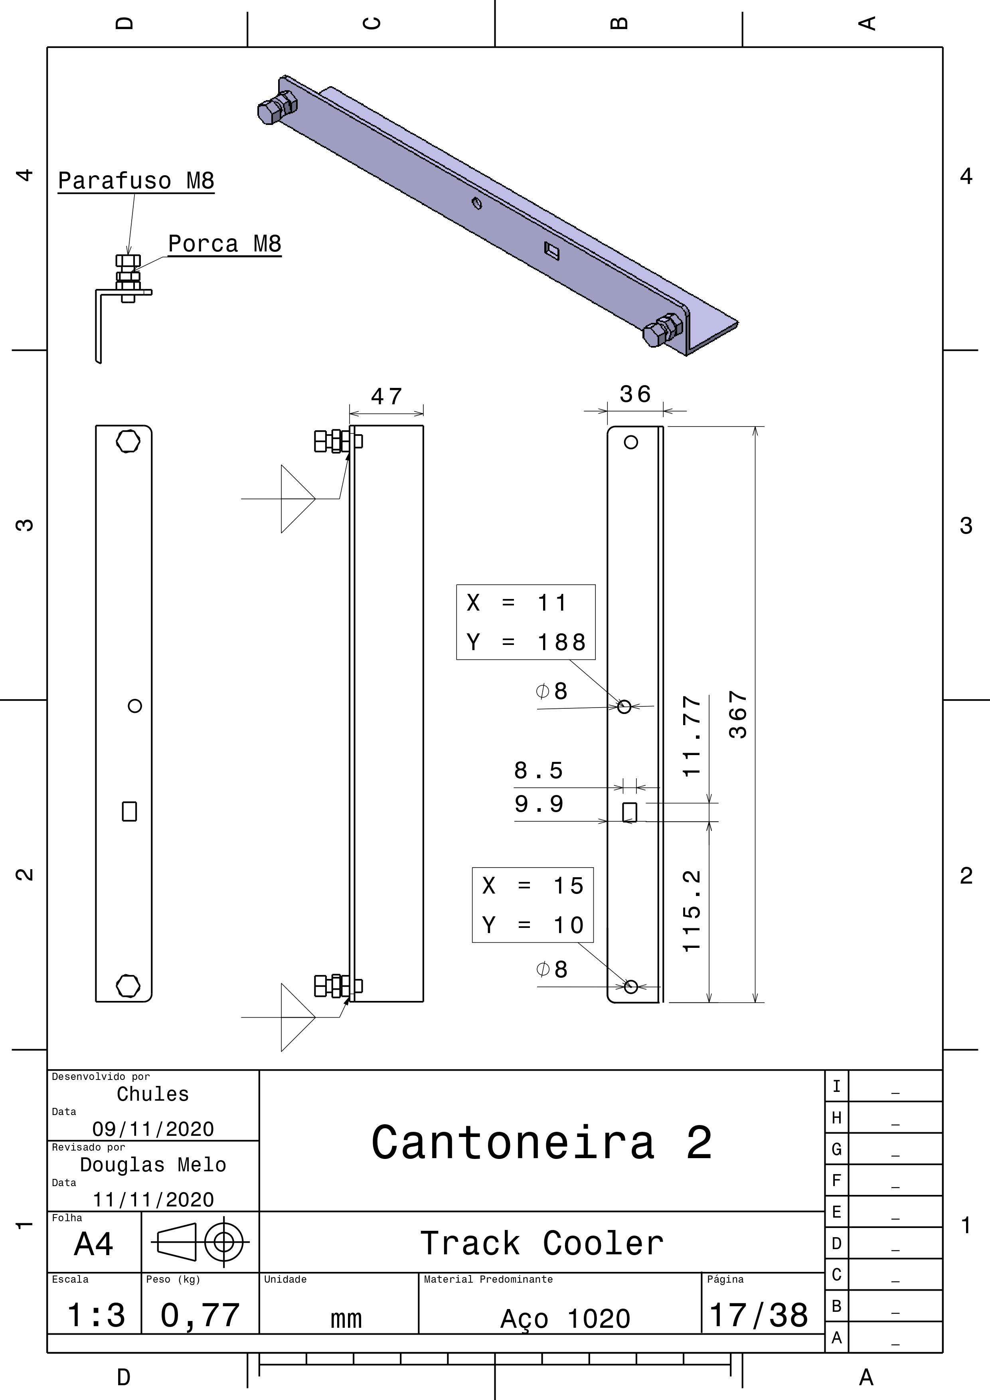
Estrutura/PC3/Desenhos técnicos/0017.jpg
