track-cooler/docs/Estrutura/PC3/Desenhos técnicos/0018.jpg

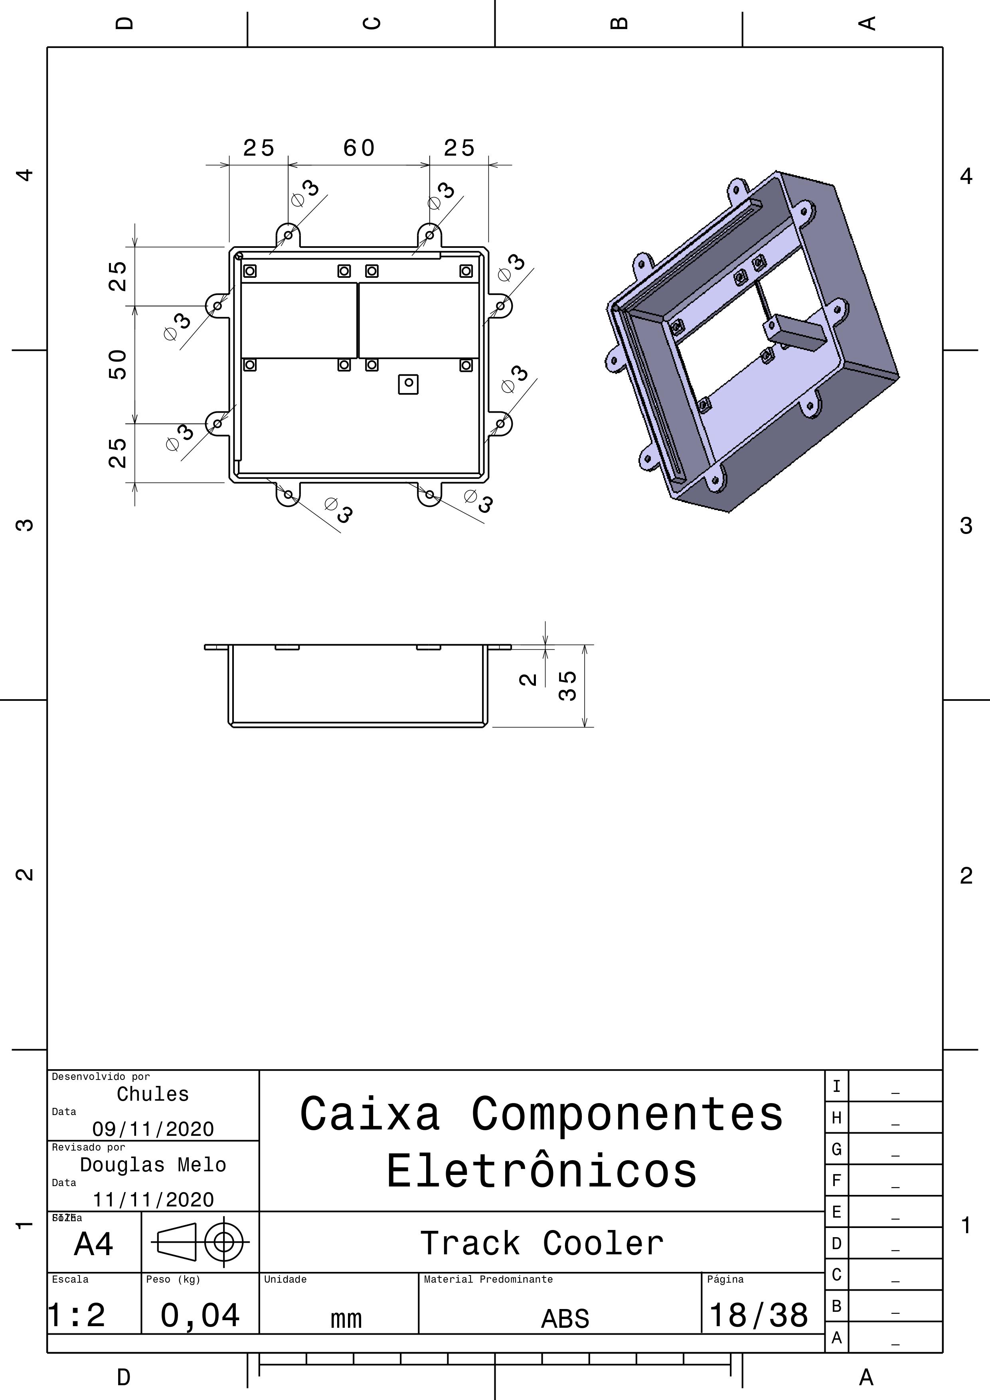
Estrutura/PC3/Desenhos técnicos/0018.jpg
