track-cooler/docs/Estrutura/PC3/Desenhos técnicos/0019.jpg

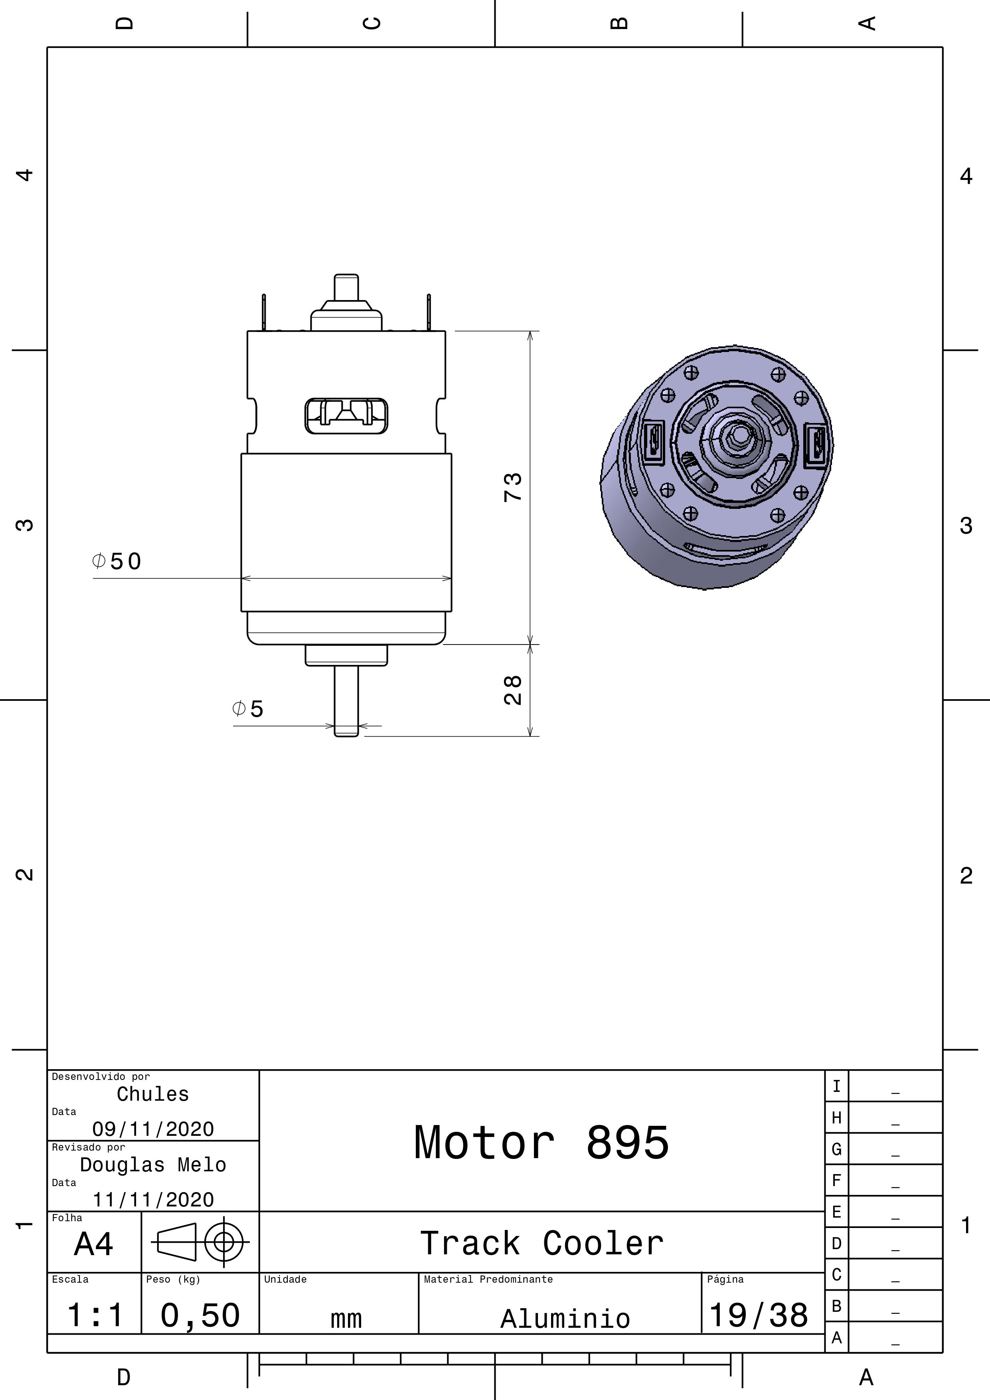
Estrutura/PC3/Desenhos técnicos/0019.jpg
