track-cooler/docs/Estrutura/PC3/Desenhos técnicos/0020.jpg

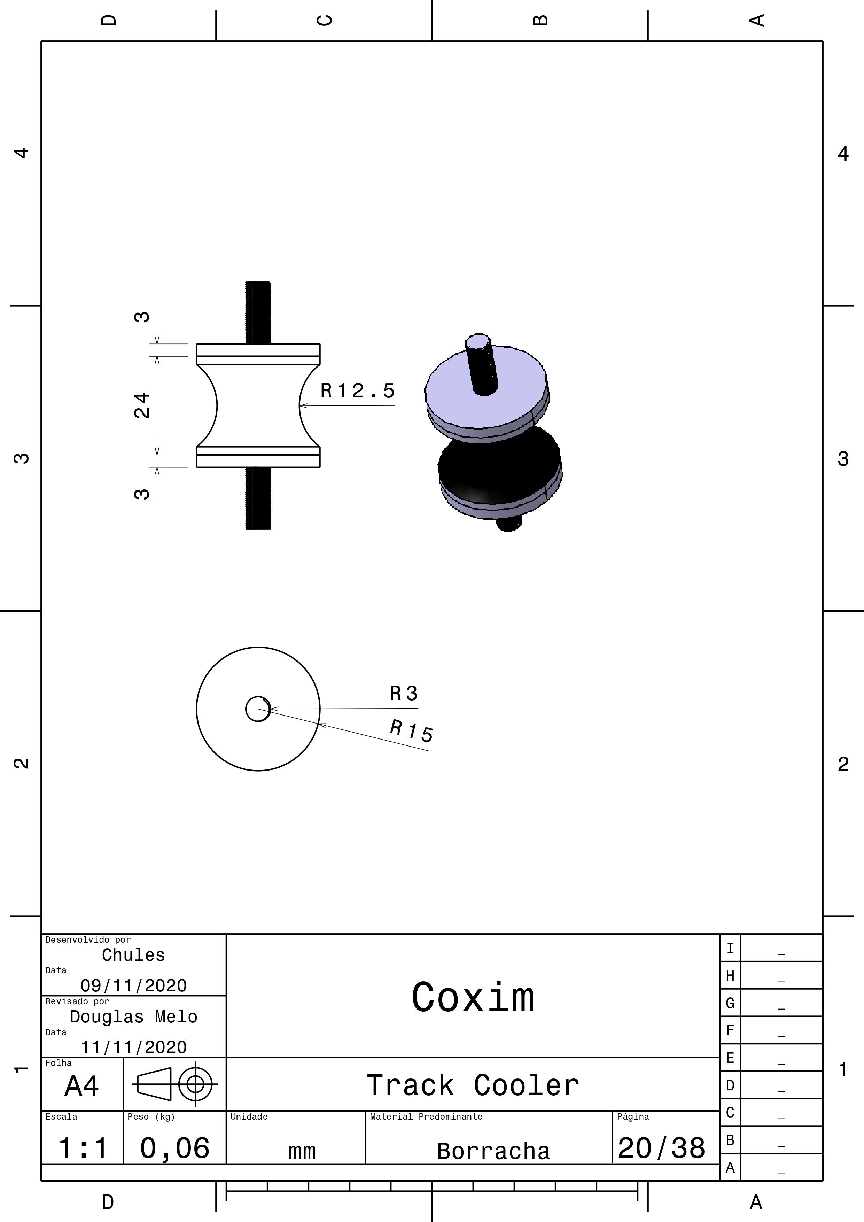
Estrutura/PC3/Desenhos técnicos/0020.jpg
