track-cooler/docs/Estrutura/PC3/Desenhos técnicos/0021.jpg

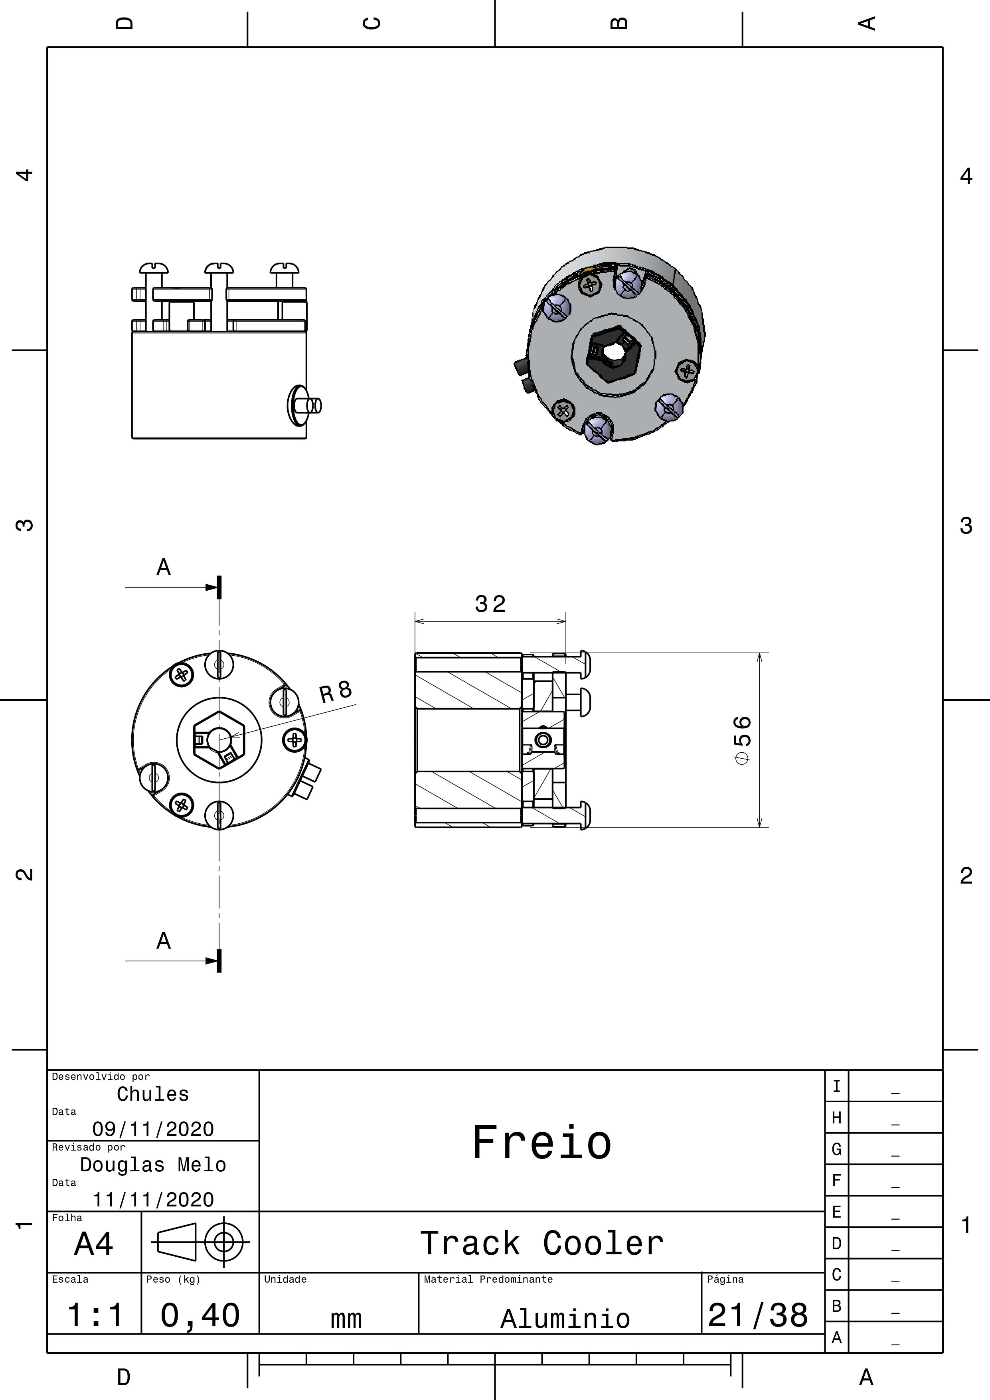
Estrutura/PC3/Desenhos técnicos/0021.jpg
