track-cooler/docs/Estrutura/PC3/Desenhos técnicos/0022.jpg

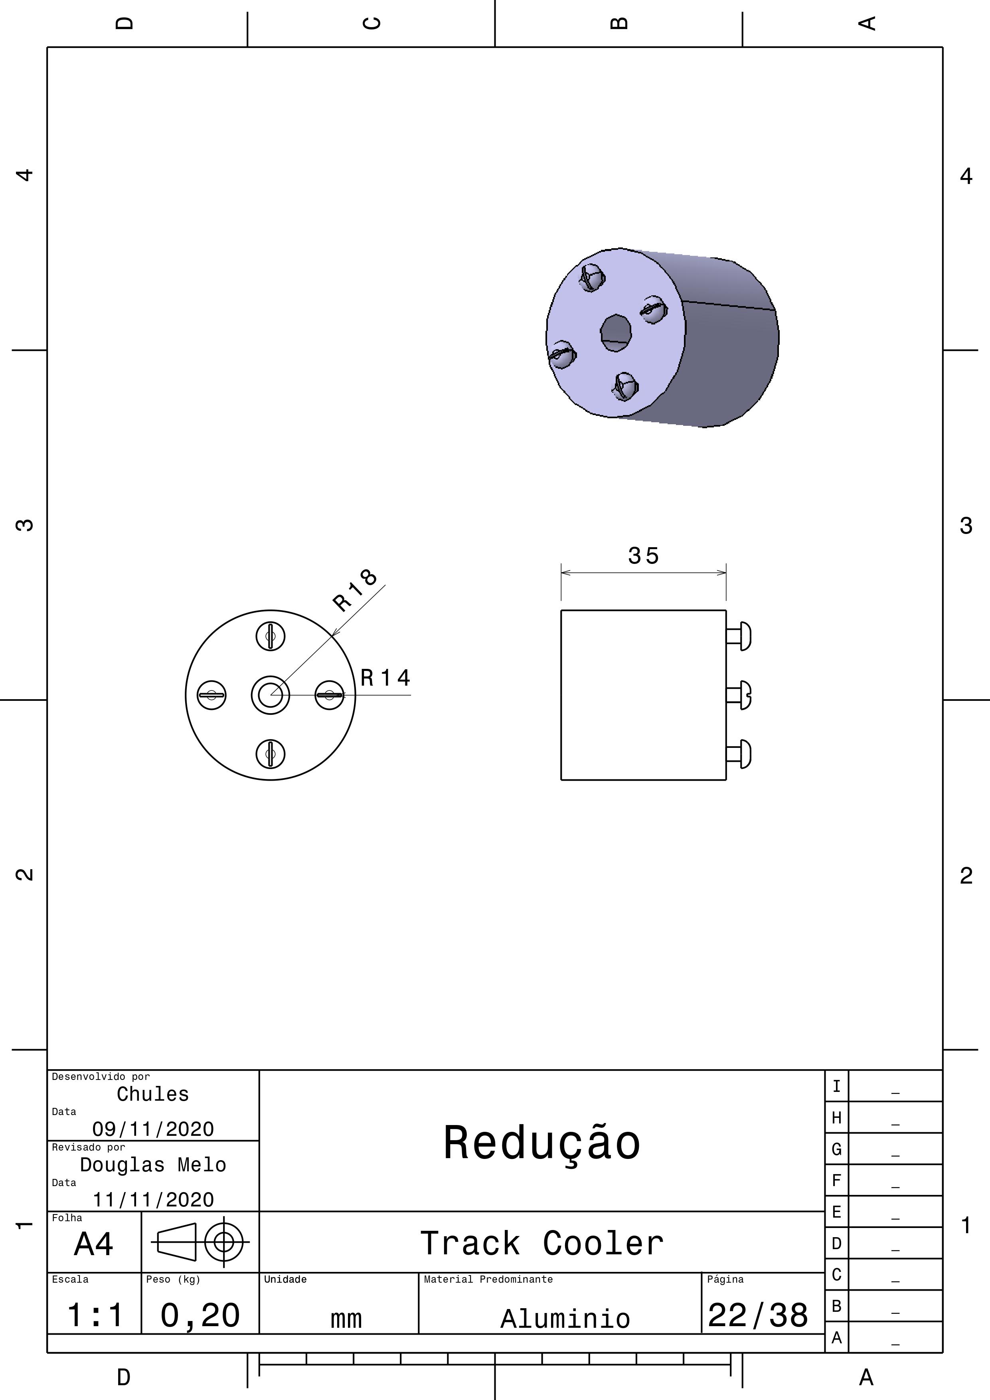
Estrutura/PC3/Desenhos técnicos/0022.jpg
