track-cooler/docs/Estrutura/PC3/Desenhos técnicos/0023.jpg

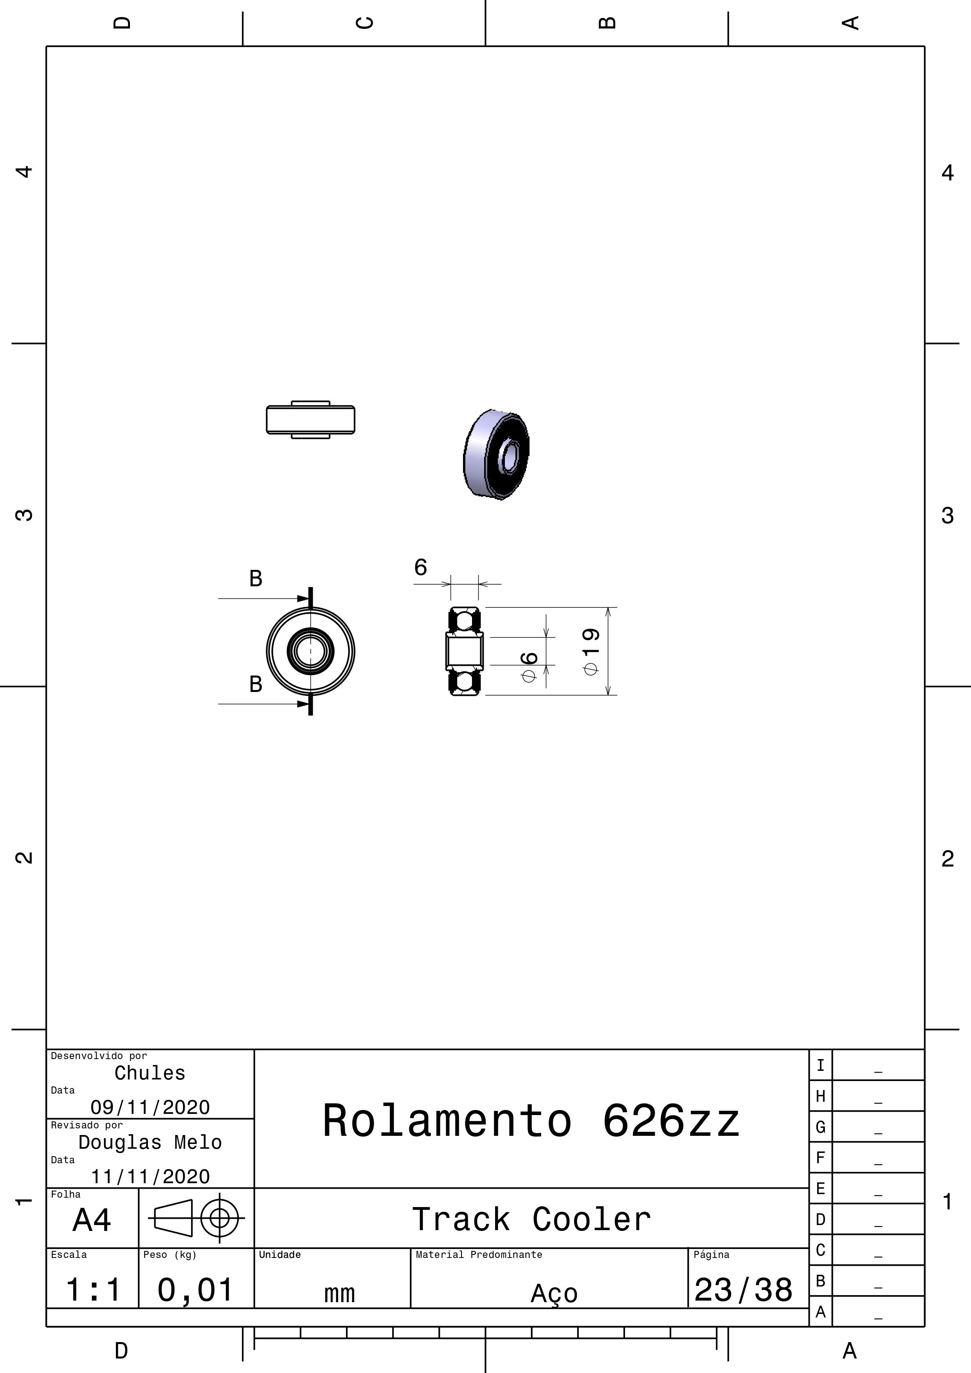
Estrutura/PC3/Desenhos técnicos/0023.jpg
