track-cooler/docs/Estrutura/PC3/Desenhos técnicos/0024.jpg

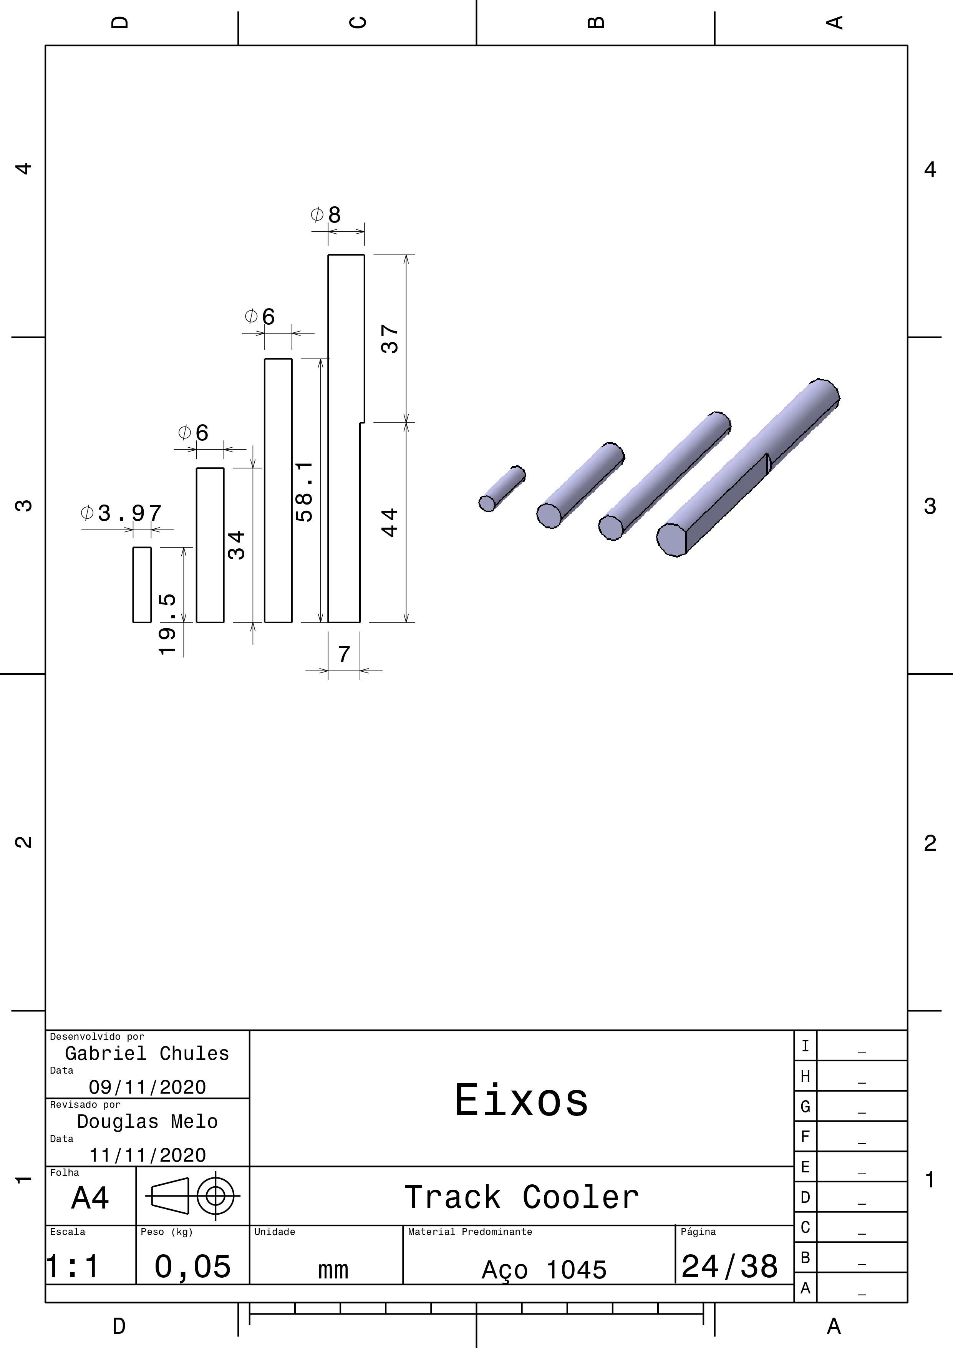
Estrutura/PC3/Desenhos técnicos/0024.jpg
