track-cooler/docs/Estrutura/PC3/Desenhos técnicos/0025.jpg

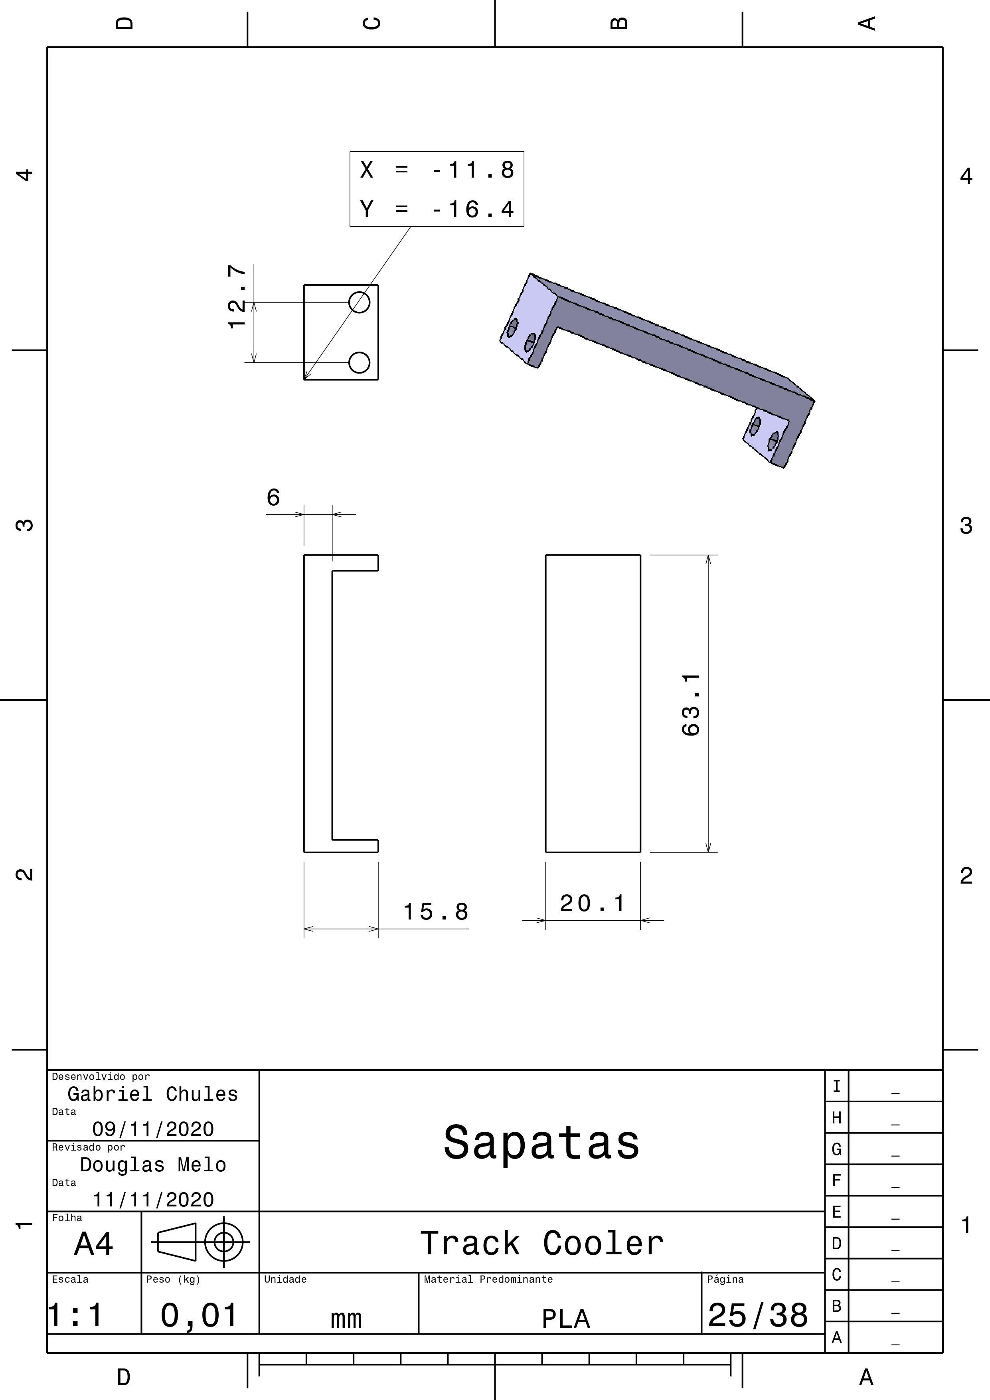
Estrutura/PC3/Desenhos técnicos/0025.jpg
