track-cooler/docs/Estrutura/PC3/Desenhos técnicos/0026.jpg

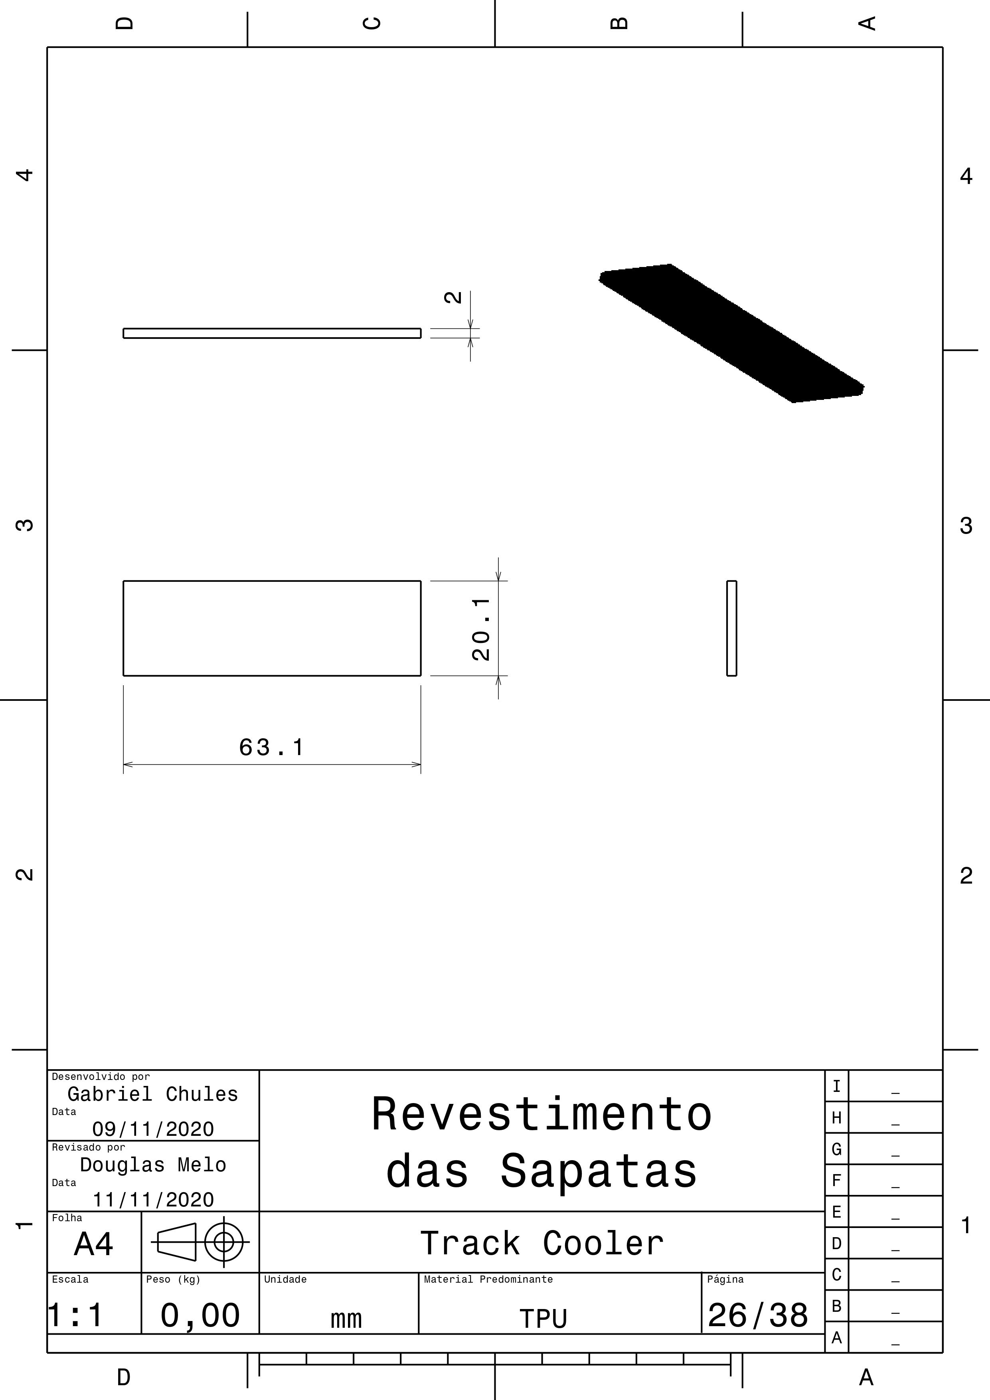
Estrutura/PC3/Desenhos técnicos/0026.jpg
