track-cooler/docs/Estrutura/PC3/Desenhos técnicos/0027.jpg

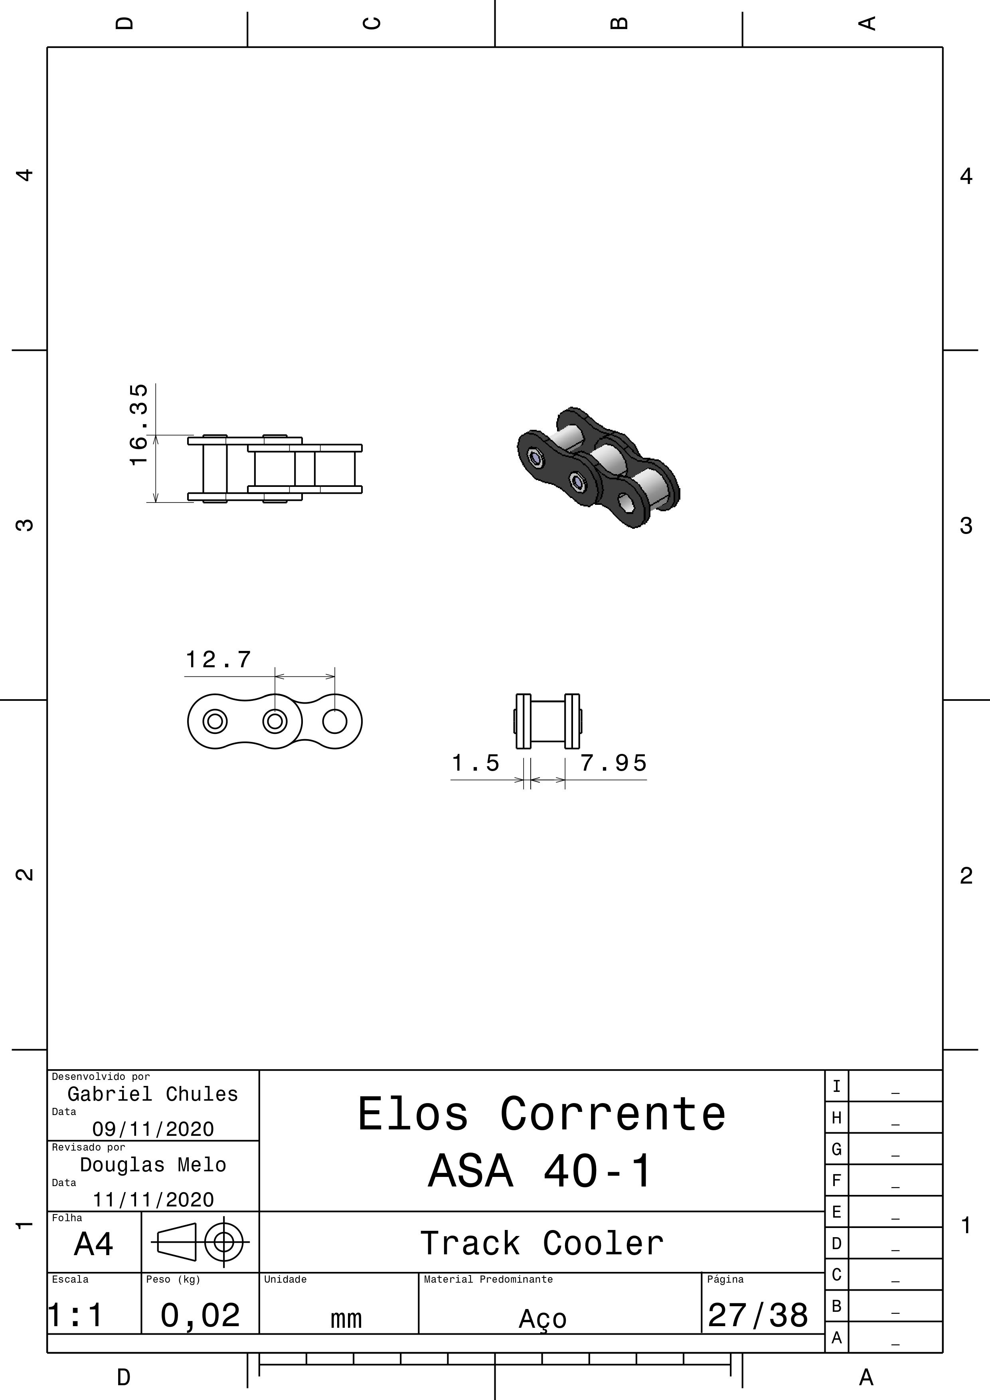
Estrutura/PC3/Desenhos técnicos/0027.jpg
