track-cooler/docs/Estrutura/PC3/Desenhos técnicos/0028.jpg

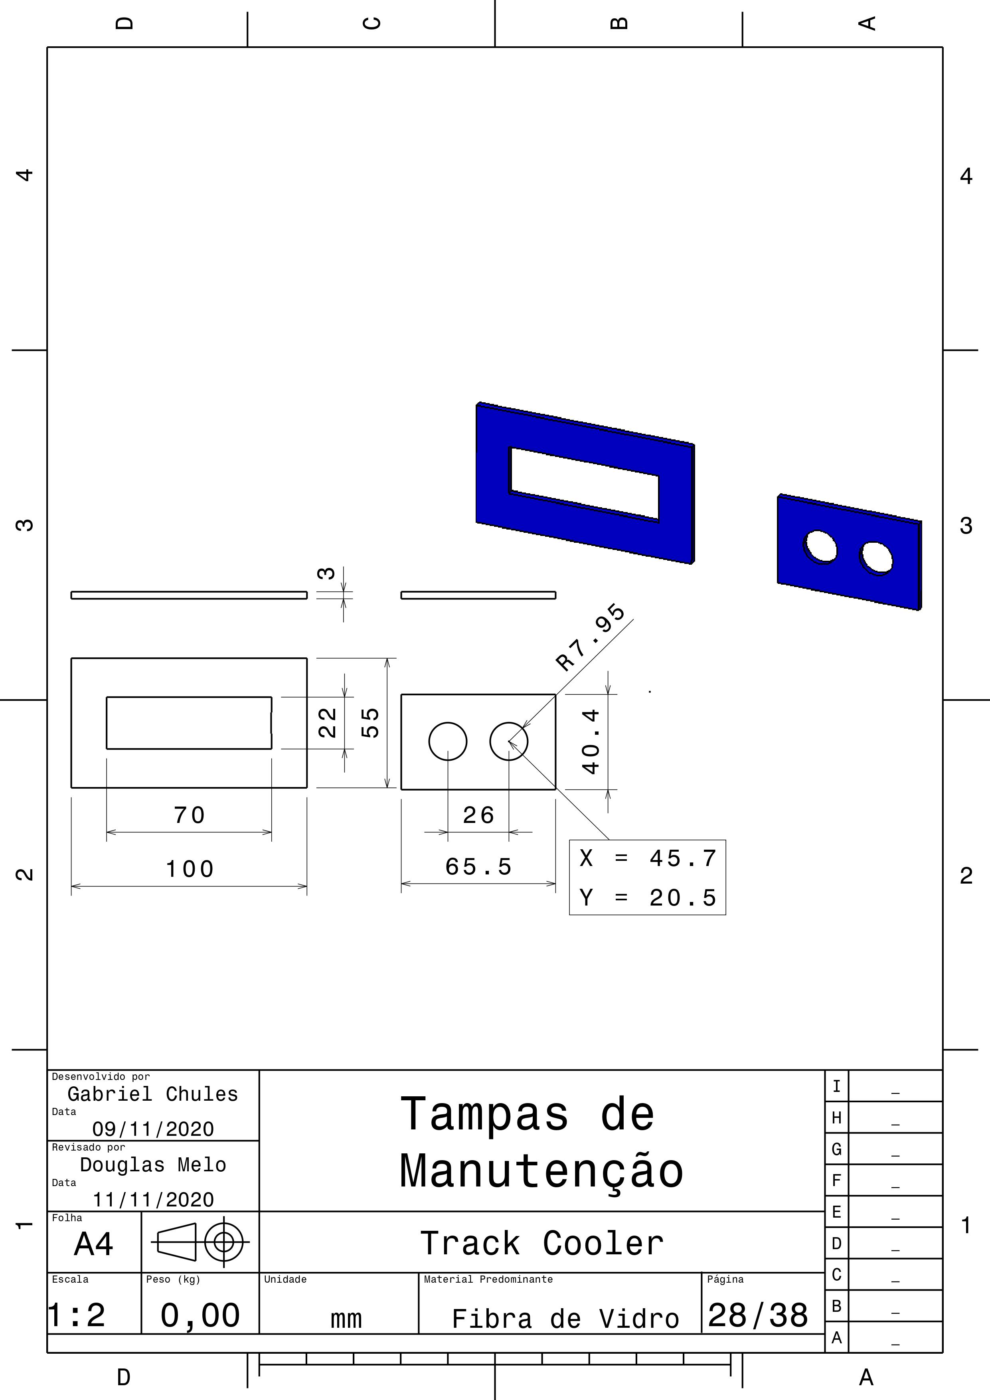
Estrutura/PC3/Desenhos técnicos/0028.jpg
