track-cooler/docs/Estrutura/PC3/Desenhos técnicos/0029.jpg

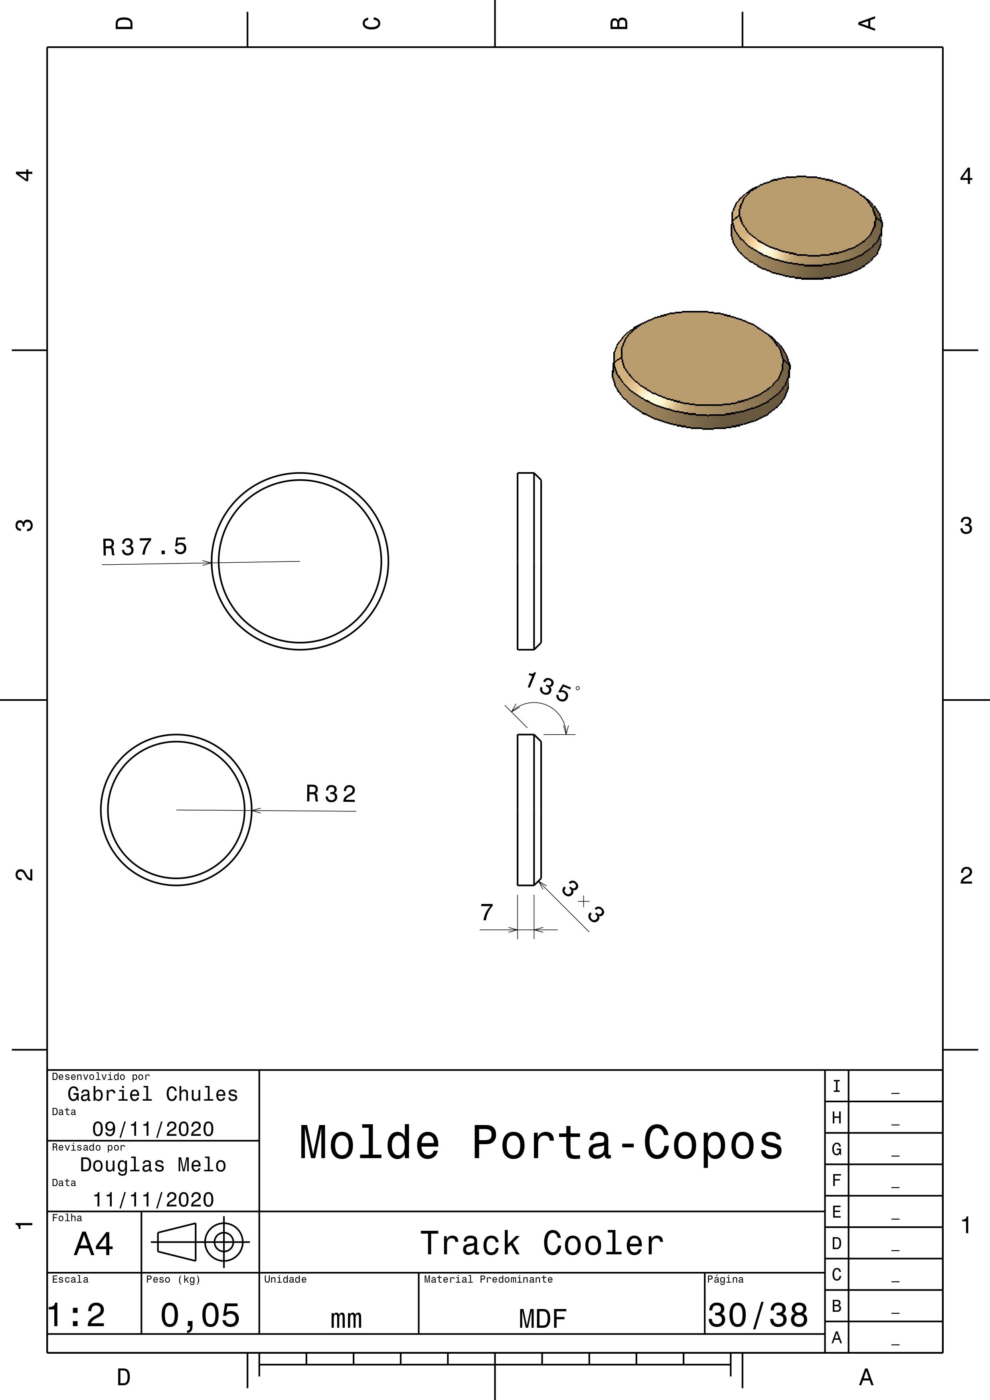
Estrutura/PC3/Desenhos técnicos/0029.jpg
