track-cooler/docs/Estrutura/PC3/Desenhos técnicos/0030.jpg

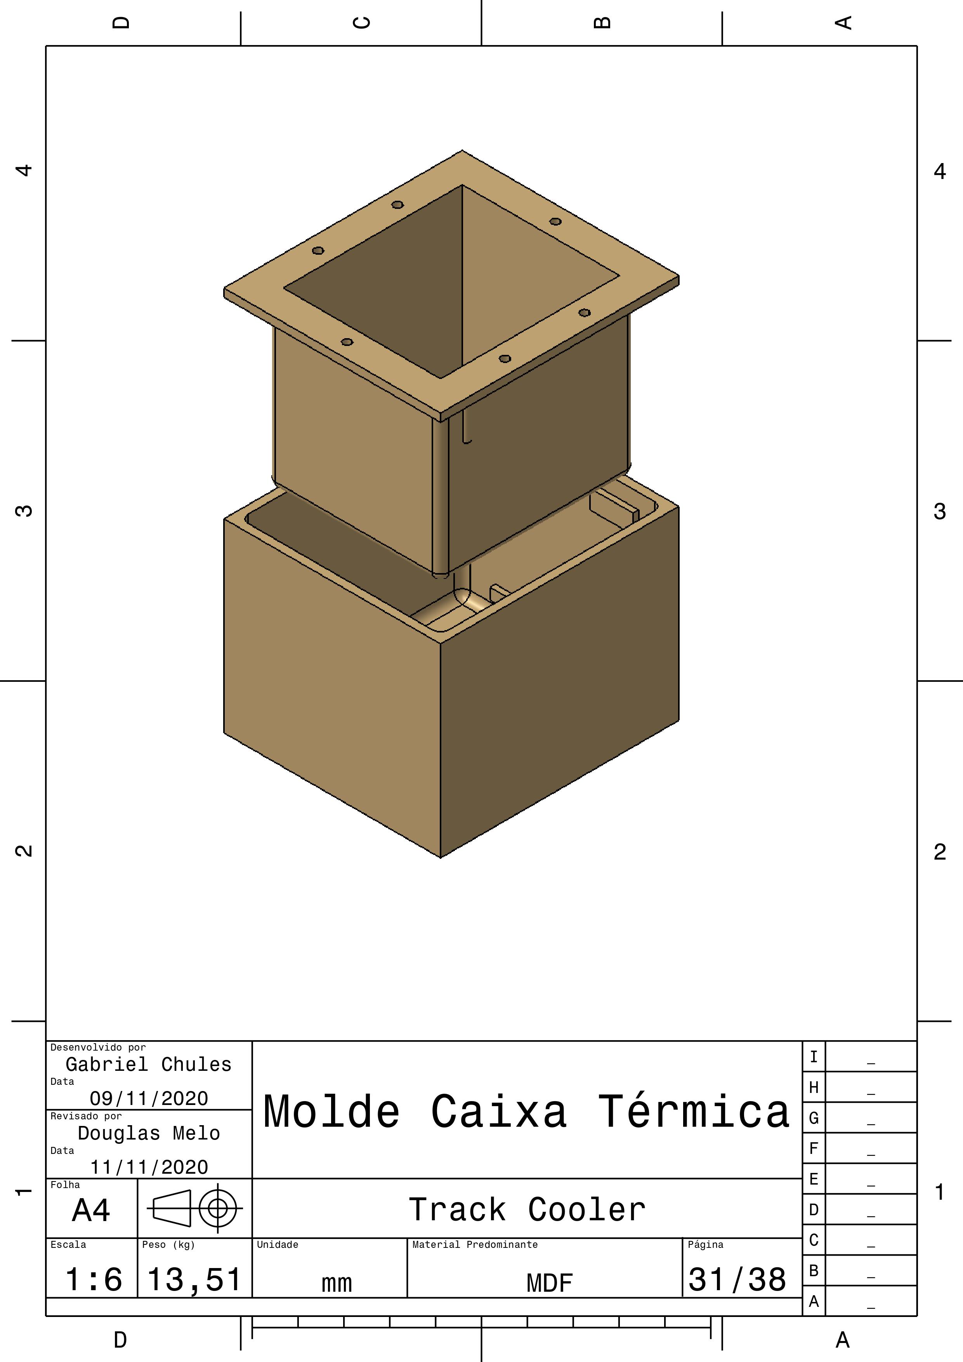
Estrutura/PC3/Desenhos técnicos/0030.jpg
