track-cooler/docs/Estrutura/PC3/Desenhos técnicos/0031.jpg

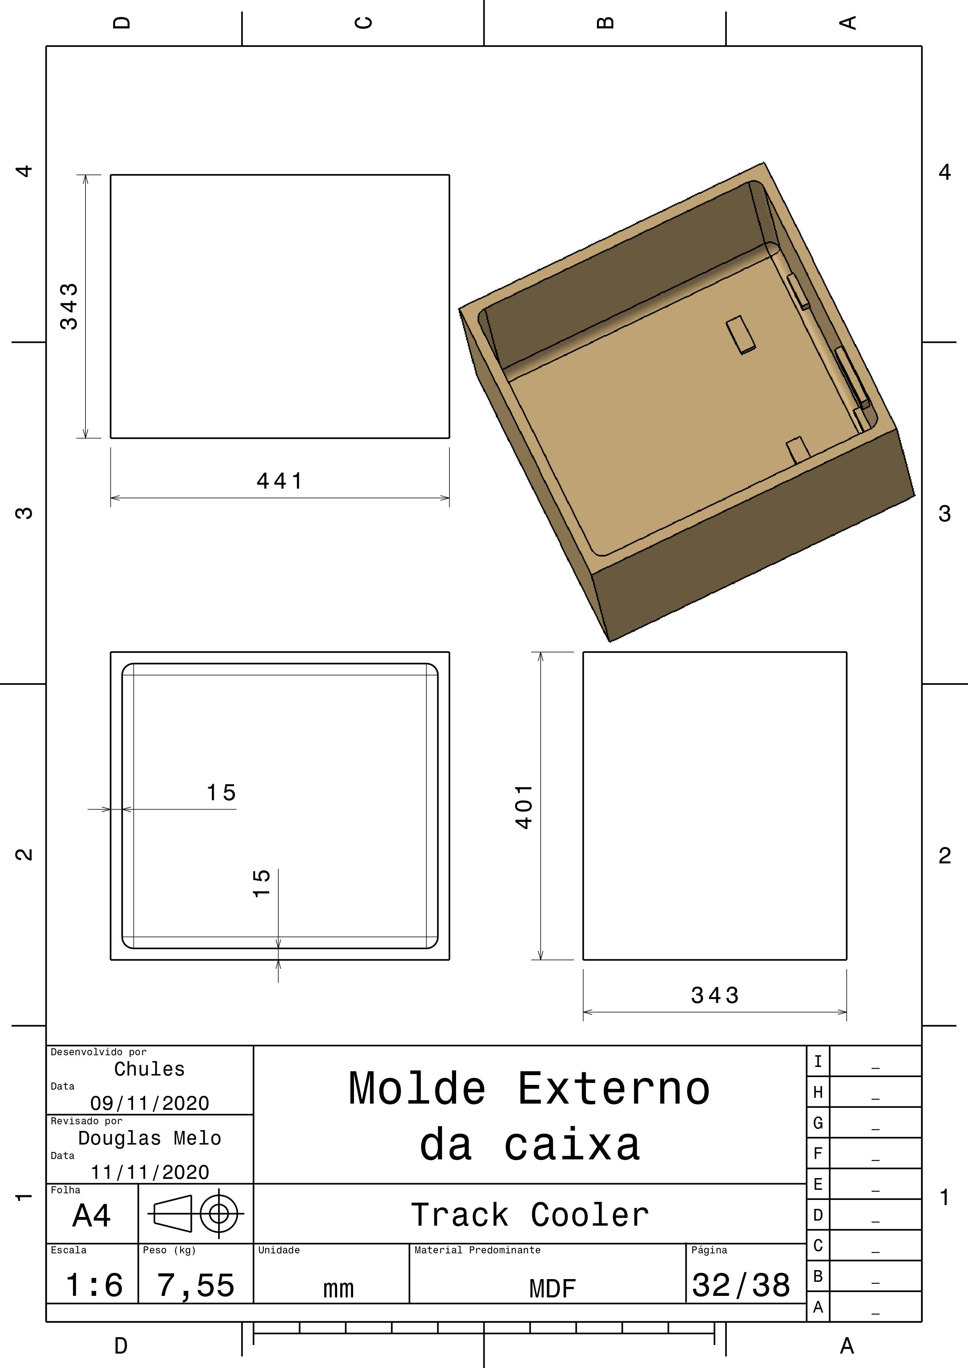
Estrutura/PC3/Desenhos técnicos/0031.jpg
