track-cooler/docs/Estrutura/PC3/Desenhos técnicos/0032.jpg

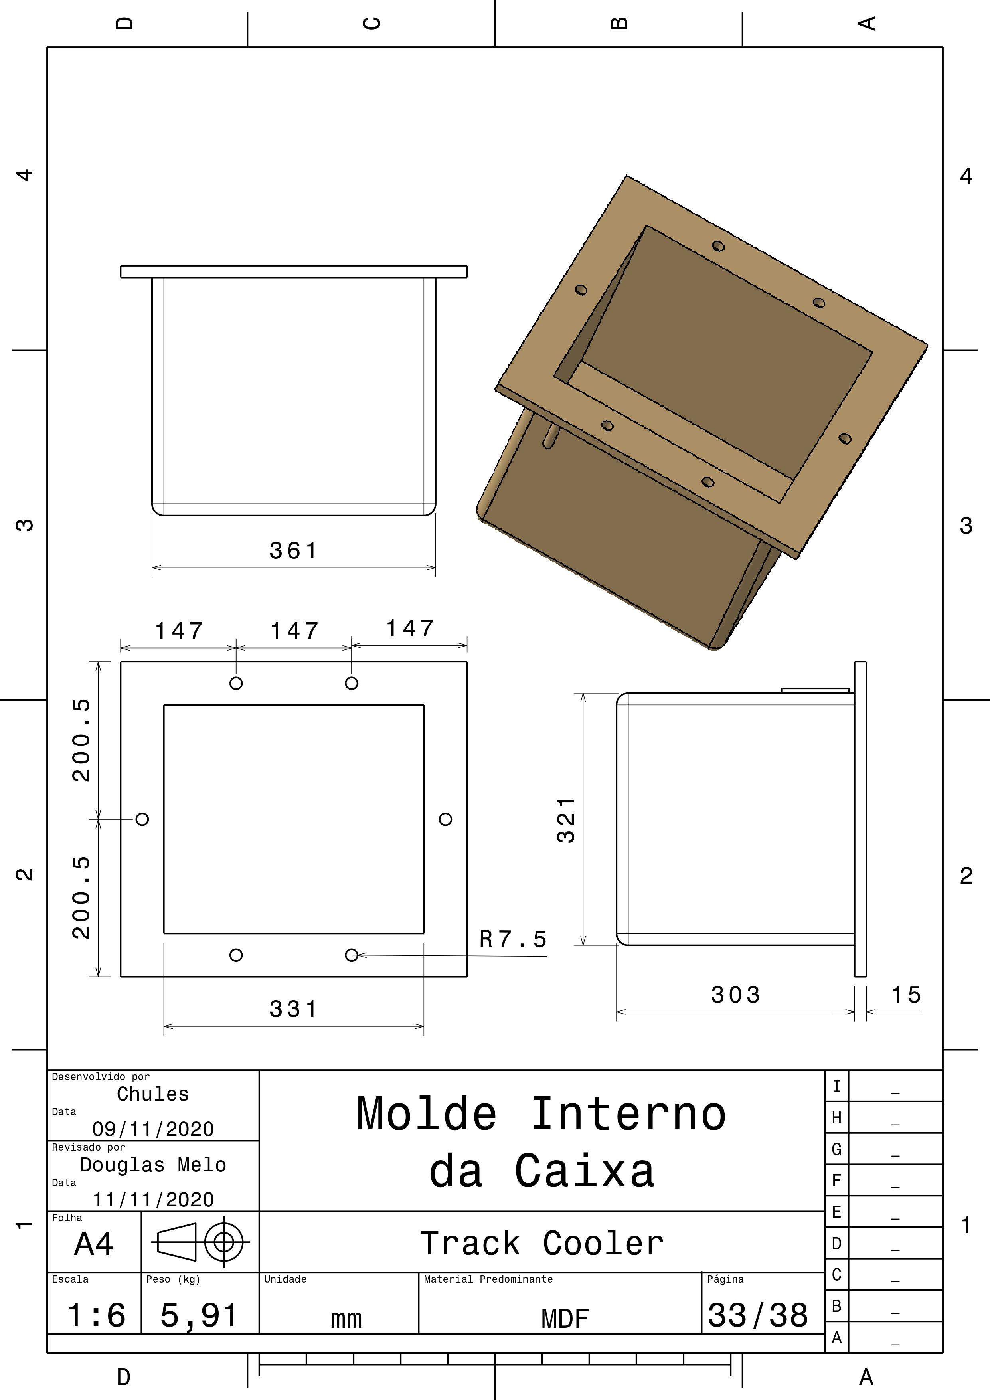
Estrutura/PC3/Desenhos técnicos/0032.jpg
