track-cooler/docs/Estrutura/PC3/Desenhos técnicos/0033.jpg

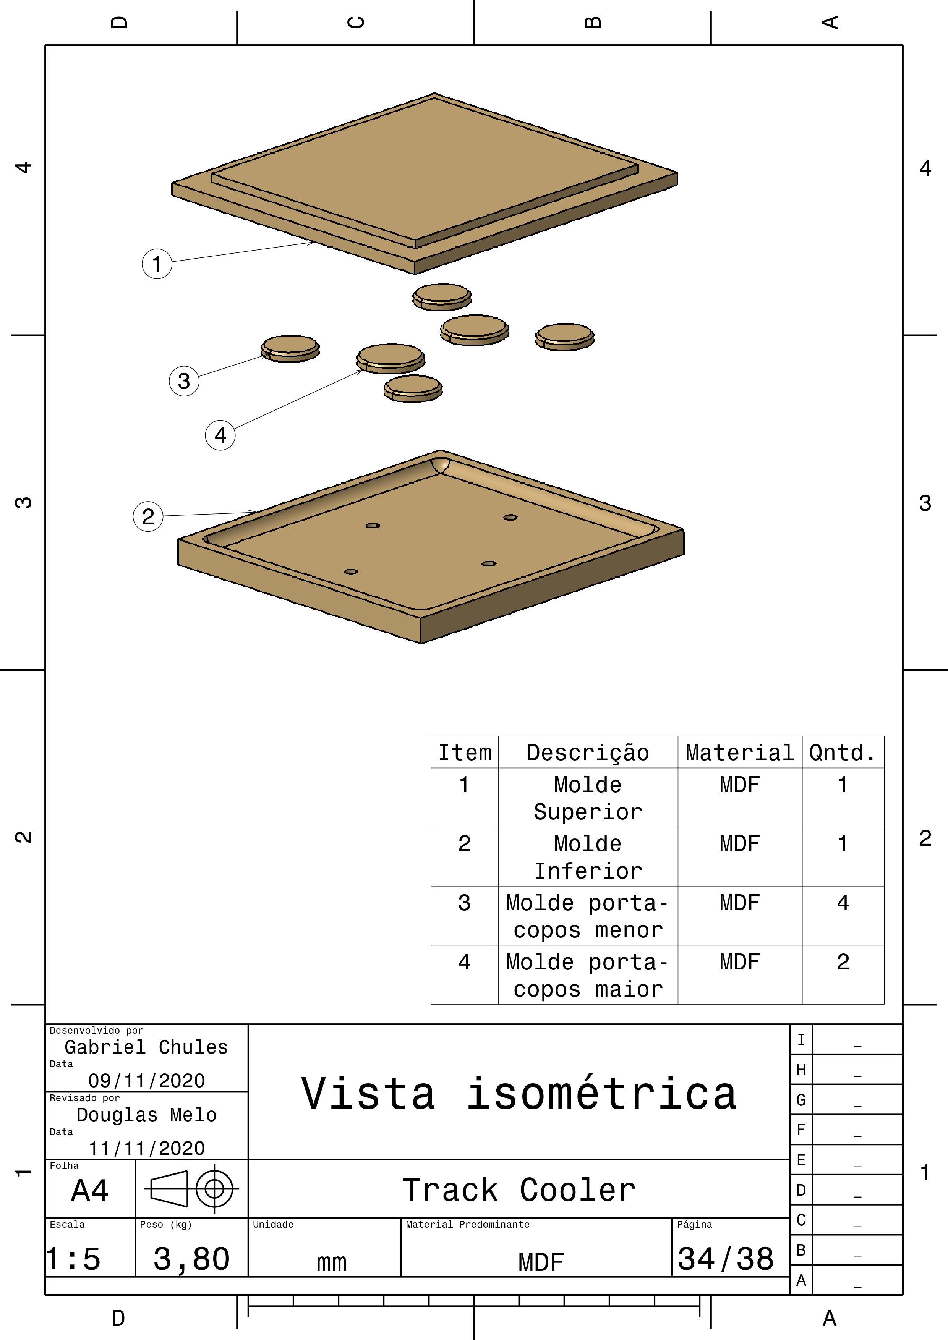
Estrutura/PC3/Desenhos técnicos/0033.jpg
