track-cooler/docs/Estrutura/PC3/Desenhos técnicos/0034.jpg

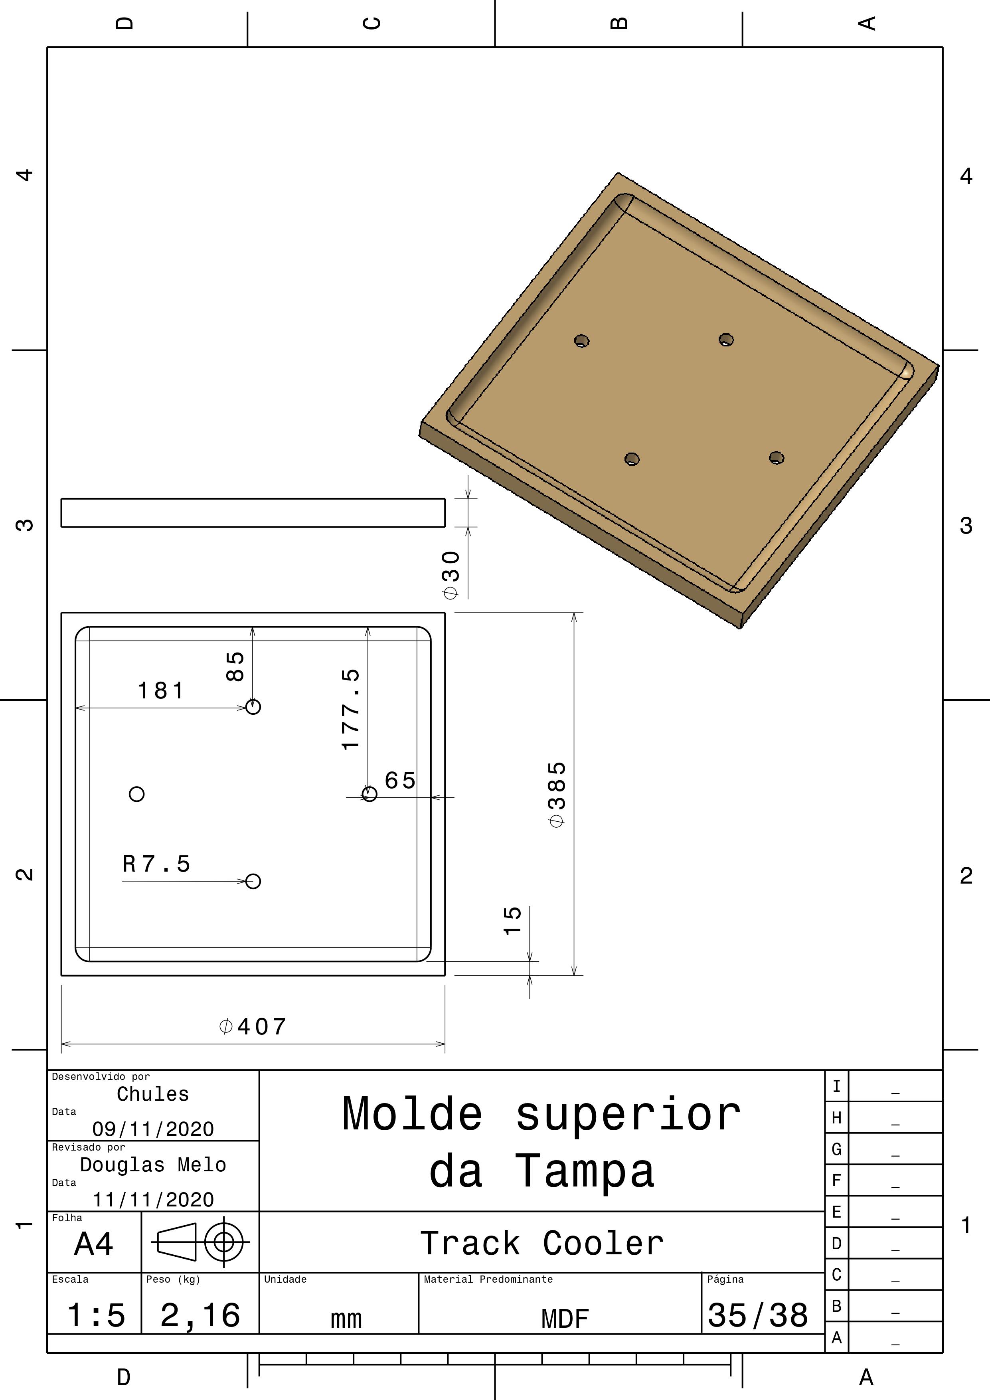
Estrutura/PC3/Desenhos técnicos/0034.jpg
