track-cooler/docs/Estrutura/PC3/Desenhos técnicos/0035.jpg

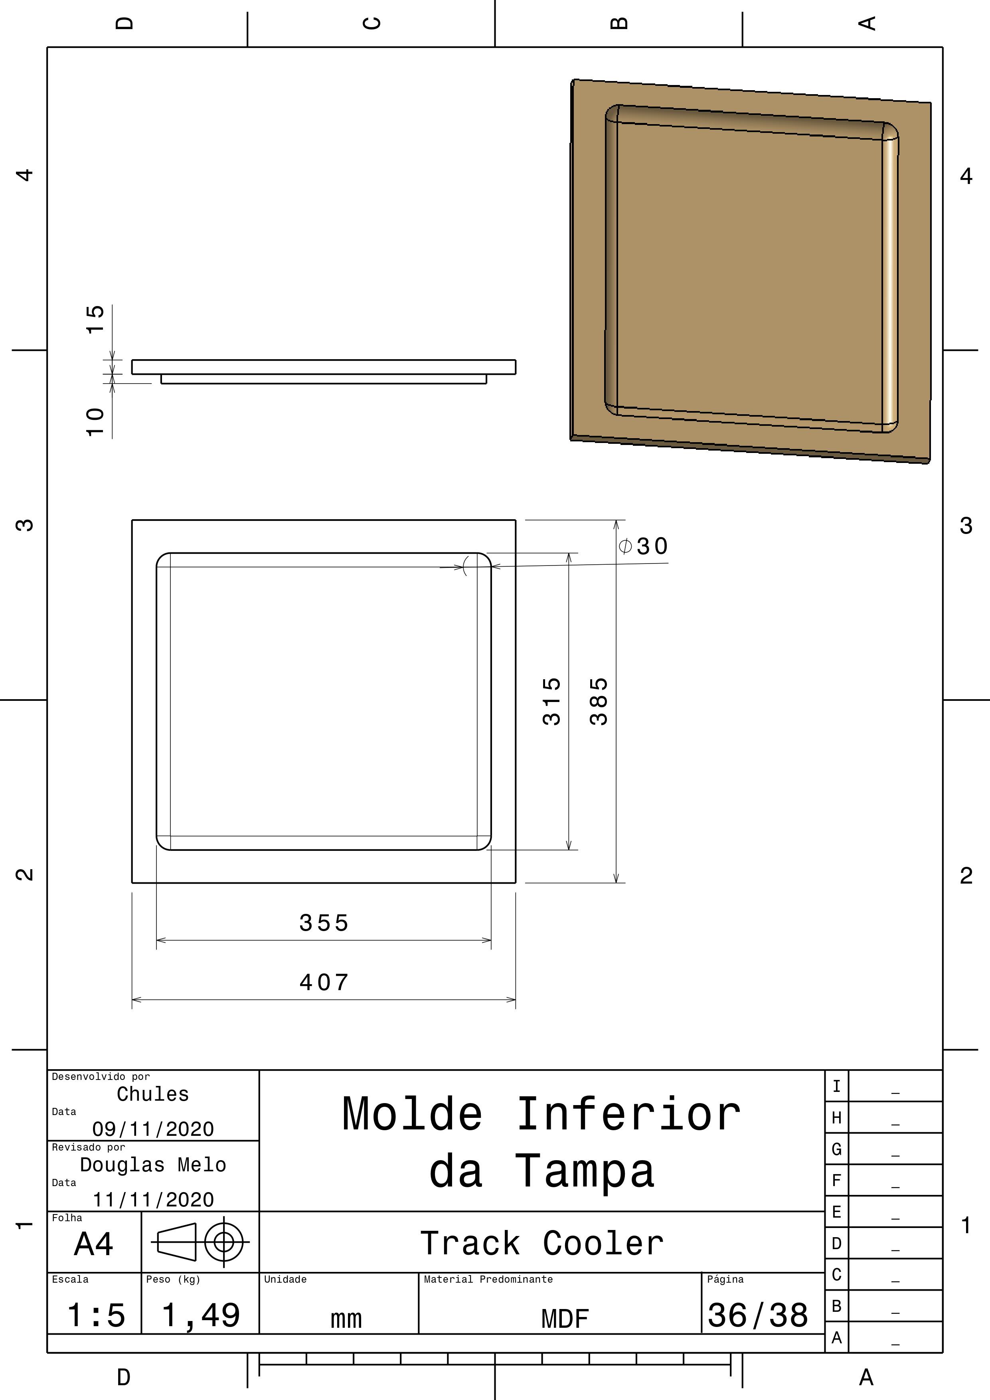
Estrutura/PC3/Desenhos técnicos/0035.jpg
