track-cooler/docs/Estrutura/PC3/Desenhos técnicos/0036.jpg

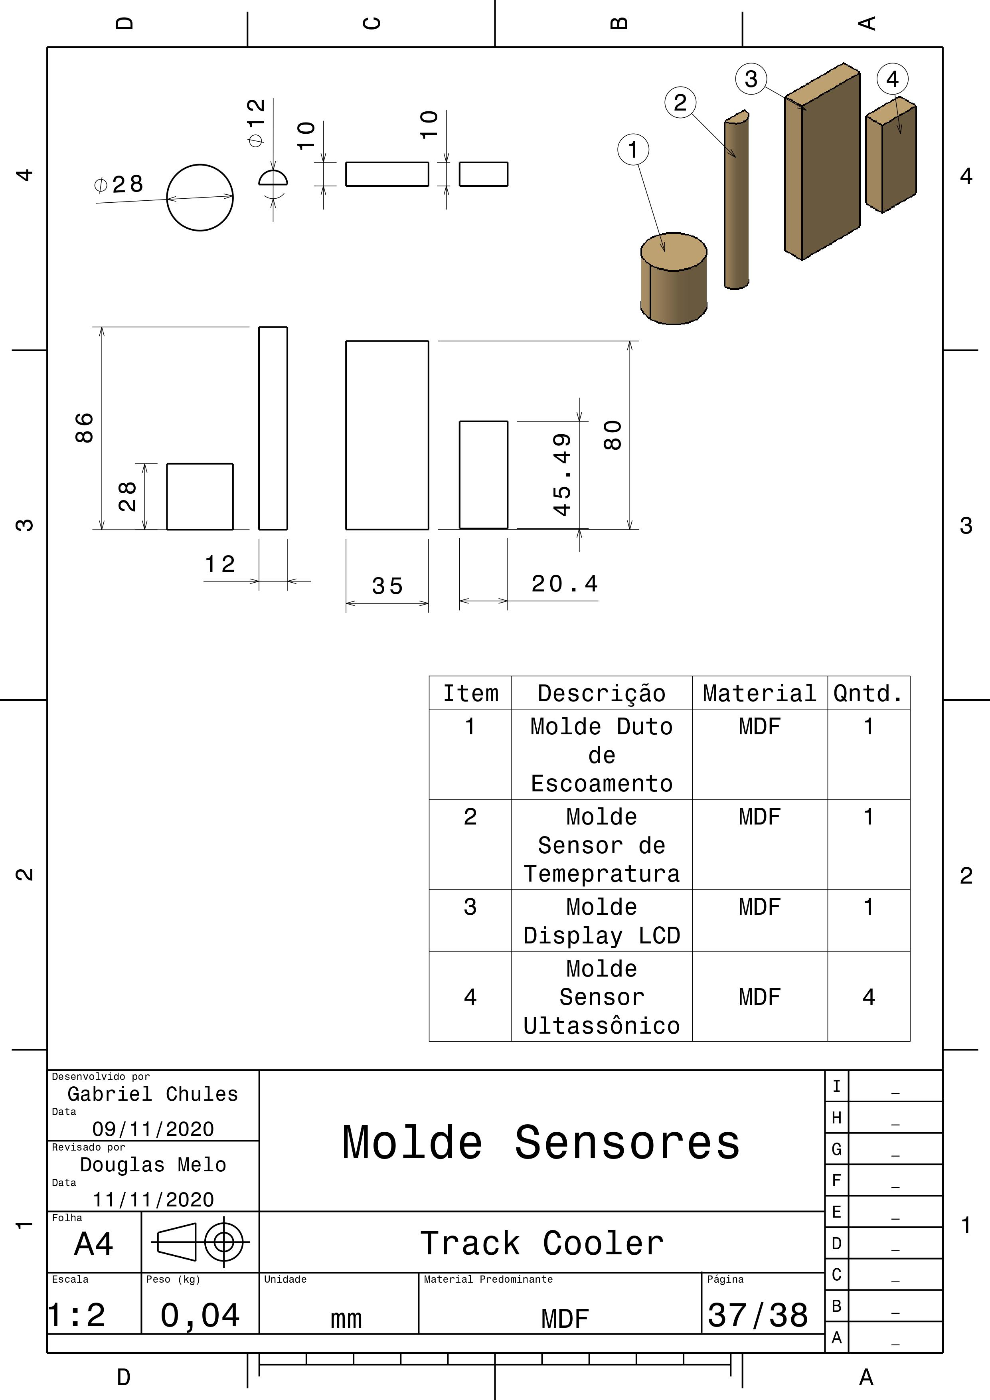
Estrutura/PC3/Desenhos técnicos/0036.jpg
