track-cooler/docs/Estrutura/PC3/Desenhos técnicos/0037.jpg

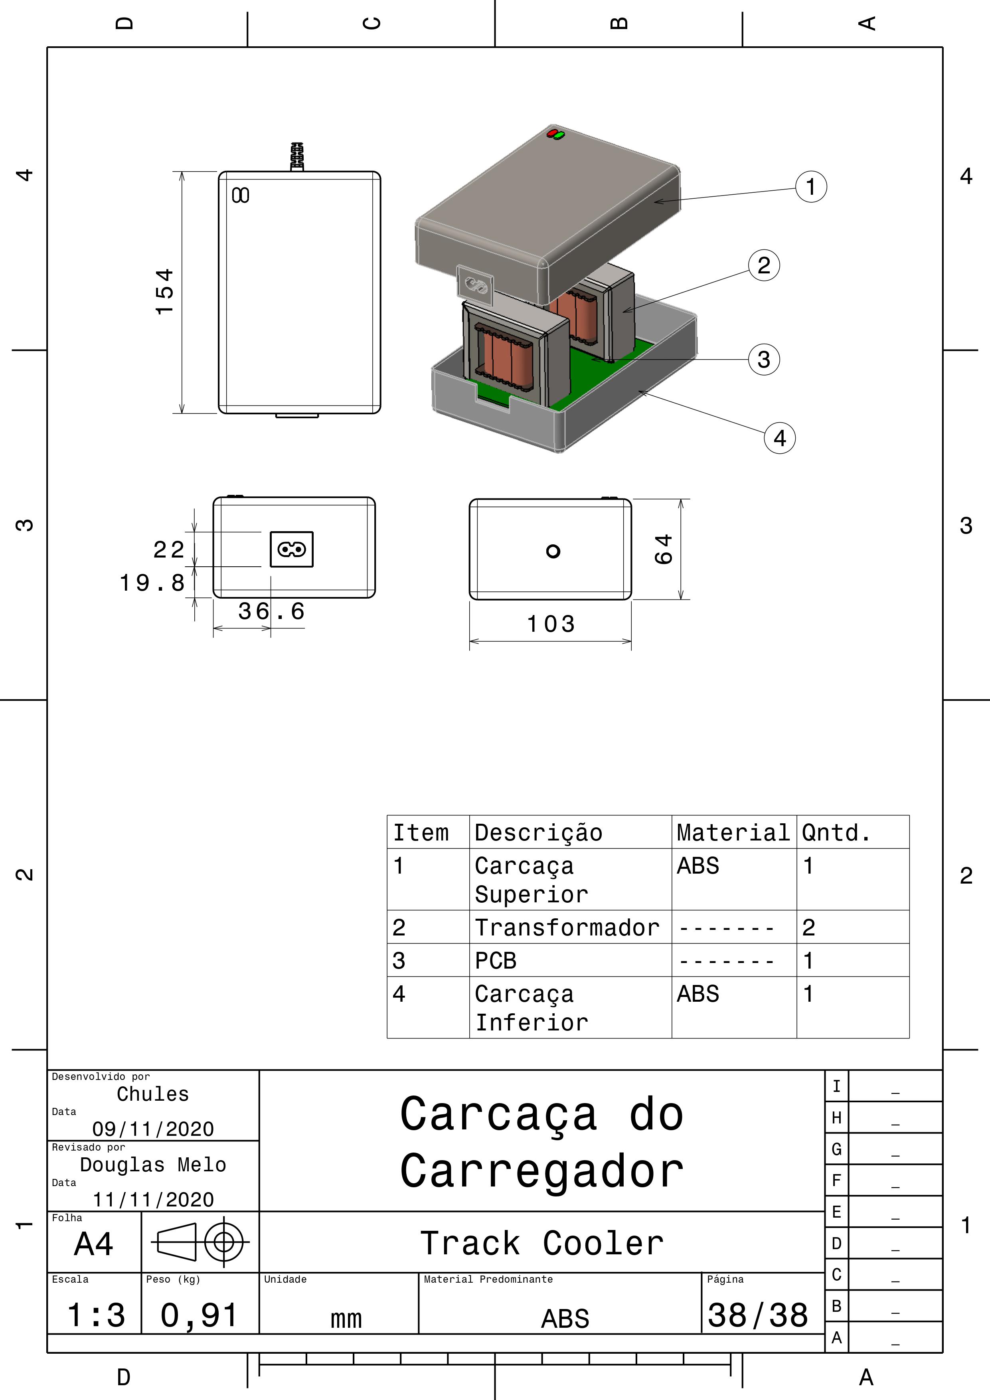
Estrutura/PC3/Desenhos técnicos/0037.jpg
