track-cooler/docs/Estrutura/PC3/Desenhos técnicos/0038.jpg

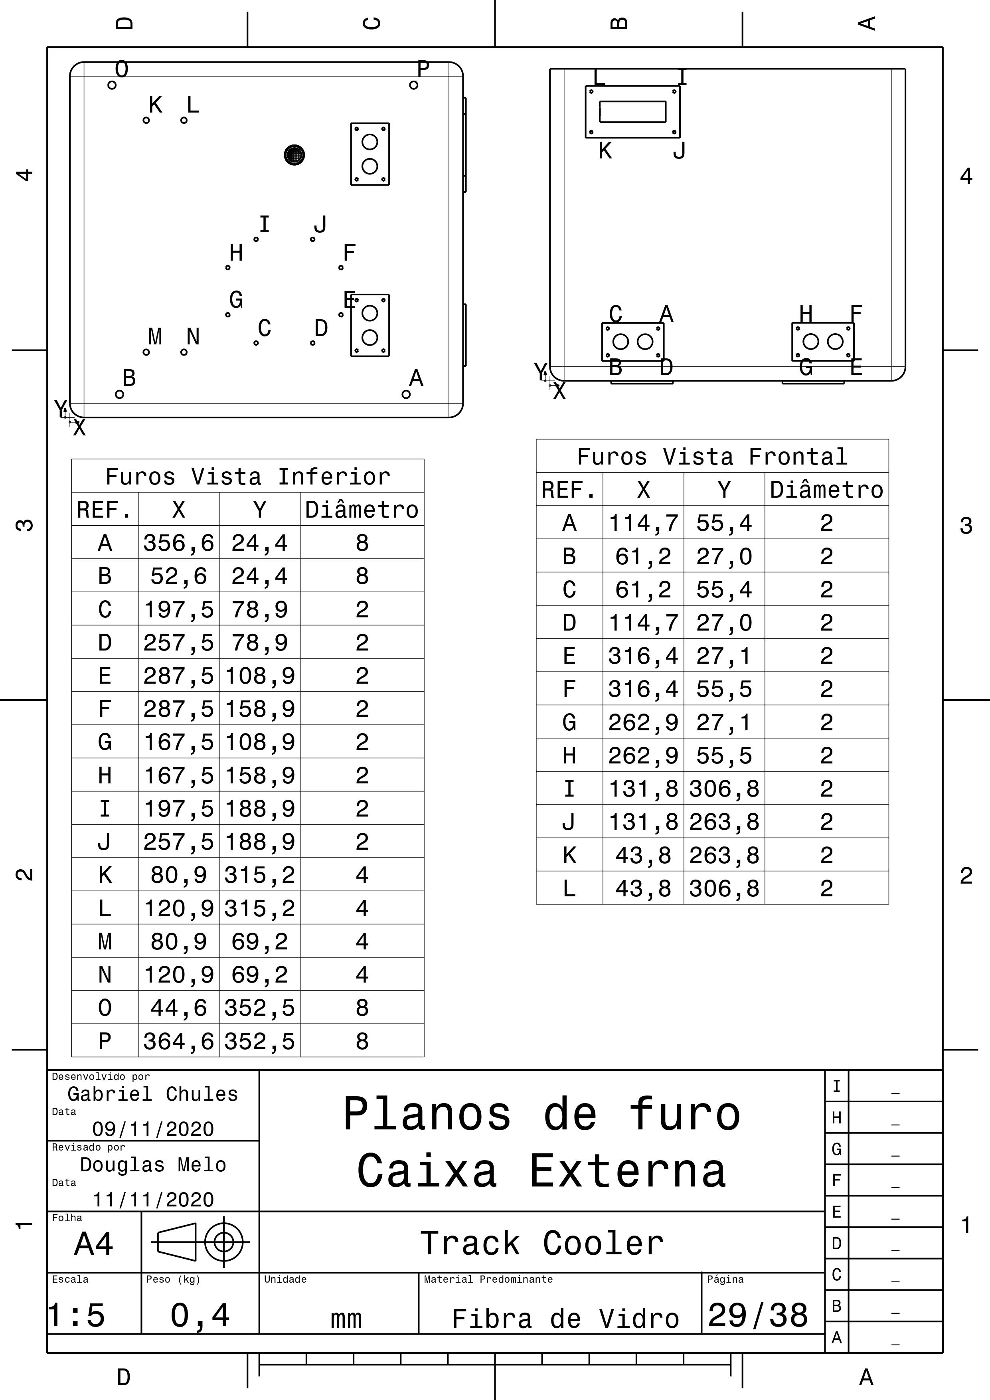
Estrutura/PC3/Desenhos técnicos/0038.jpg
