track-cooler/docs/Estrutura/PC3/arquivos .dxf para corte/4x_MDF_10mm.dxf

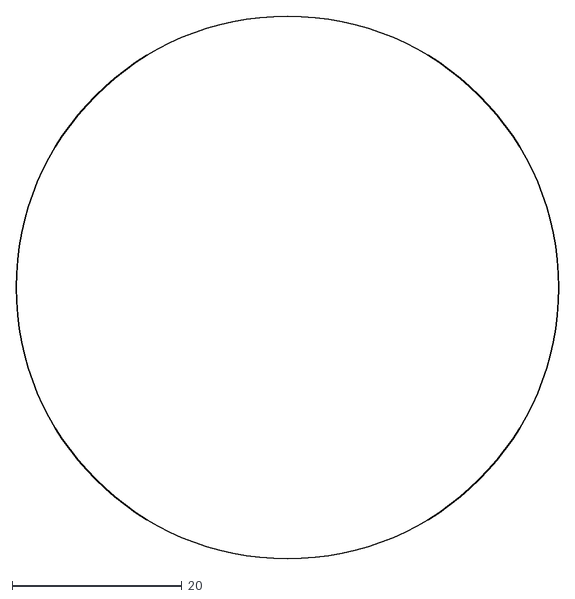
[picture p145: CAD file, 2020-11-20]
Estrutura/PC3/arquivos .dxf para corte/4x_MDF_10mm.dxf
64.0 x 64.0
