track-cooler/docs/Estrutura/PC3/arquivos .dxf para corte/1x_Fibra_de_Vidro_3mm.dxf

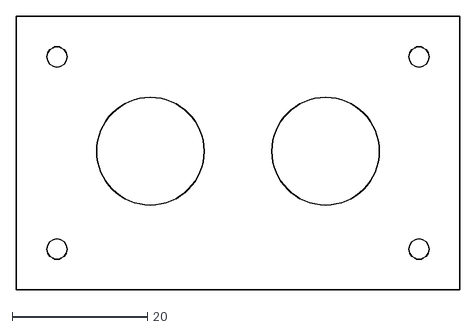
[picture p146: CAD file, 2020-11-20]
Estrutura/PC3/arquivos .dxf para corte/1x_Fibra_de_Vidro_3mm.dxf
65.5 x 40.4
