track-cooler/docs/Estrutura/PC3/arquivos .dxf para corte/2x_Aço_1020_3mm.dxf

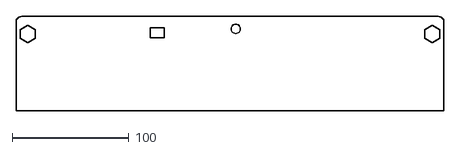
[picture p147: CAD file, 2020-11-20]
Estrutura/PC3/arquivos .dxf para corte/2x_Aço_1020_3mm.dxf
366.7 x 80.7
