track-cooler/docs/Estrutura/PC3/arquivos .dxf para corte/4x_Fibra_de_Vidro_3mm.dxf

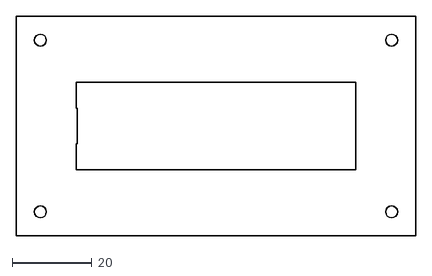
[picture p148: CAD file, 2020-11-20]
Estrutura/PC3/arquivos .dxf para corte/4x_Fibra_de_Vidro_3mm.dxf
100.0 x 55.0
