track-cooler/docs/Estrutura/PC3/arquivos .dxf para corte/1x_MDF_10mm.dxf

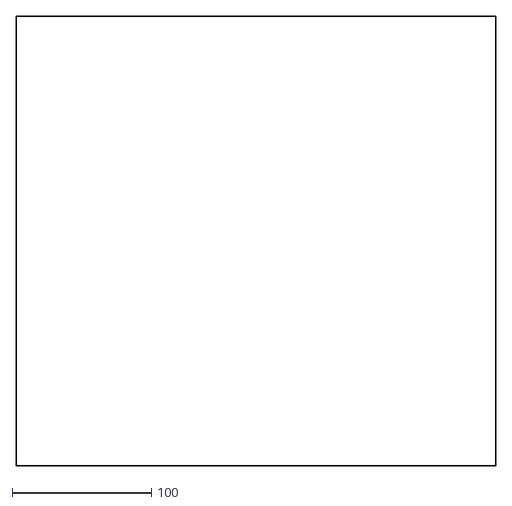
[picture p149: CAD file, 2020-11-20]
Estrutura/PC3/arquivos .dxf para corte/1x_MDF_10mm.dxf
345.0 x 323.0
