track-cooler/docs/Estrutura/PC3/arquivos .dxf para corte/2x_MDF_10mm.dxf

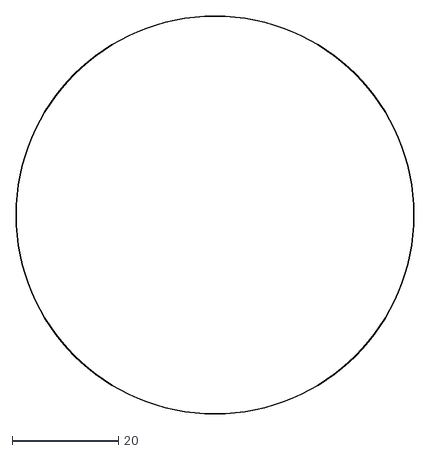
[picture p150: CAD file, 2020-11-20]
Estrutura/PC3/arquivos .dxf para corte/2x_MDF_10mm.dxf
75.0 x 75.0
