track-cooler/docs/Estrutura/PC3/arquivos .dxf para corte/1x_MDF_15mm.dxf

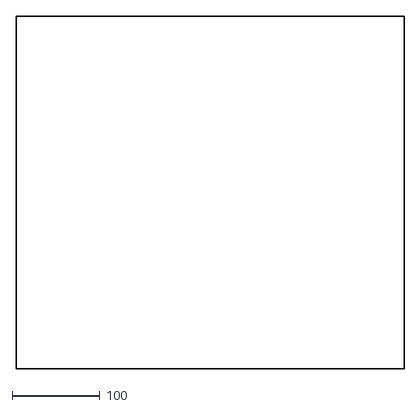
[picture p151: CAD file, 2020-11-20]
Estrutura/PC3/arquivos .dxf para corte/1x_MDF_15mm.dxf
441.0 x 401.0
