track-cooler/docs/Estrutura/PC3/arquivos .dxf para corte/2x_MDF_15mm.dxf

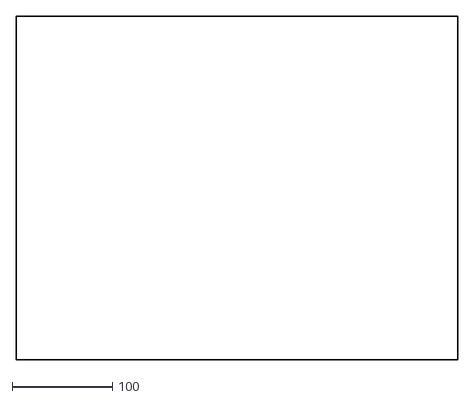
[picture p152: CAD file, 2020-11-20]
Estrutura/PC3/arquivos .dxf para corte/2x_MDF_15mm.dxf
441.0 x 343.0
