track-cooler/docs/Estrutura/PC3/arquivos .dxf para corte/2x_MDF_15mm (2).dxf

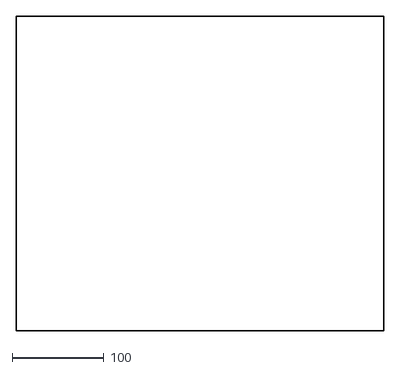
[picture p153: CAD file, 2020-11-20, an earlier design]
Estrutura/PC3/arquivos .dxf para corte/2x_MDF_15mm (2).dxf
401.0 x 343.0
