track-cooler/docs/Estrutura/PC3/arquivos .dxf para corte/1x_MDF_15mm (4).dxf

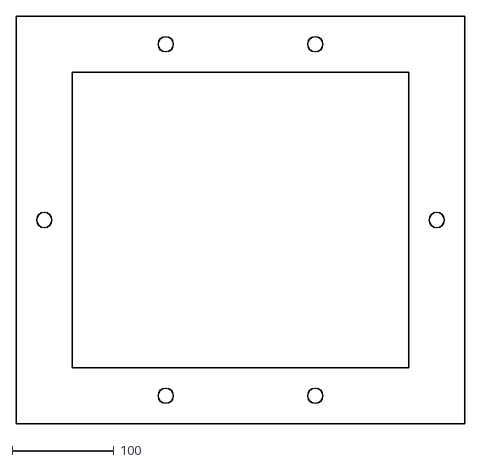
[picture p154: CAD file, 2020-11-20, an earlier design]
Estrutura/PC3/arquivos .dxf para corte/1x_MDF_15mm (4).dxf
441.0 x 401.0
