track-cooler/docs/Estrutura/PC3/arquivos .dxf para corte/1x_MDF_10mm (1).dxf

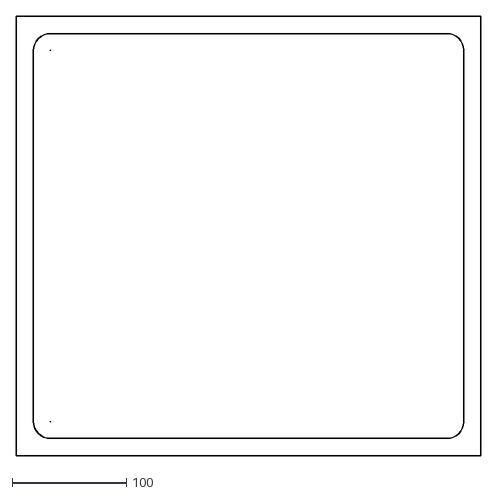
[picture p156: CAD file, 2020-11-20, an earlier design]
Estrutura/PC3/arquivos .dxf para corte/1x_MDF_10mm (1).dxf
407.0 x 385.0
