track-cooler/docs/Estrutura/PC3/arquivos .dxf para corte/2x_aço_1020_3mm (1).dxf

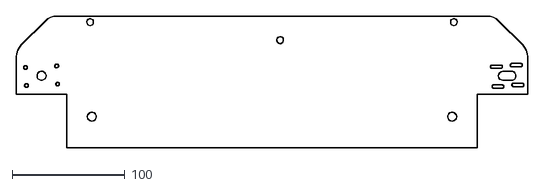
[picture p157: CAD file, 2020-11-20, an earlier design]
Estrutura/PC3/arquivos .dxf para corte/2x_aço_1020_3mm (1).dxf
454.0 x 117.0
