track-cooler/docs/Estrutura/PC3/arquivos .dxf para corte/1x_MDF_15mm (1).dxf

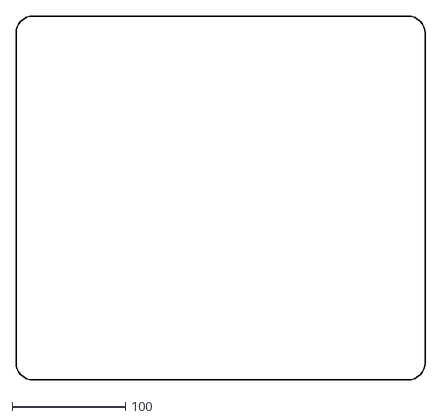
[picture p158: CAD file, 2020-11-20, an earlier design]
Estrutura/PC3/arquivos .dxf para corte/1x_MDF_15mm (1).dxf
361.0 x 321.0
