track-cooler/docs/Estrutura/PC3/arquivos .dxf para corte/2x_MDF_15mm (1).dxf

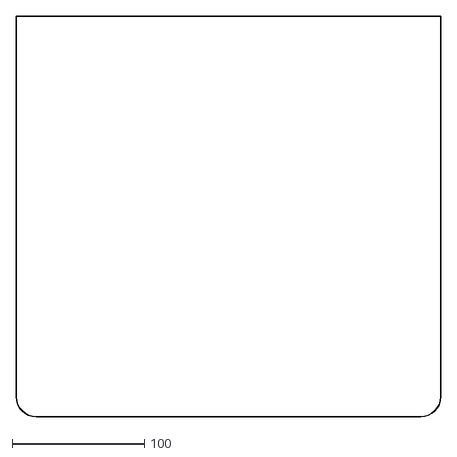
[picture p159: CAD file, 2020-11-20, an earlier design]
Estrutura/PC3/arquivos .dxf para corte/2x_MDF_15mm (1).dxf
321.0 x 303.0
