track-cooler/docs/Estrutura/PC3/arquivos .dxf para corte/1x_MDF_15mm (3).dxf

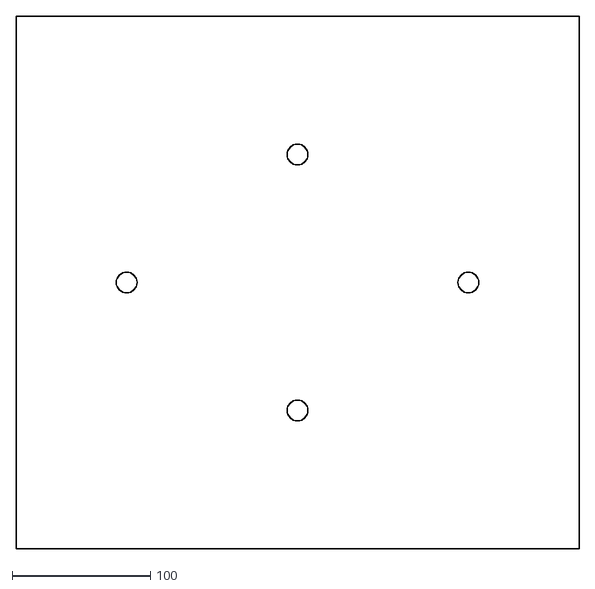
[picture p160: CAD file, 2020-11-20, an earlier design]
Estrutura/PC3/arquivos .dxf para corte/1x_MDF_15mm (3).dxf
407.0 x 385.0
