track-cooler/docs/Estrutura/PC3/Alimentacao/Diagrama unifilar.pdf

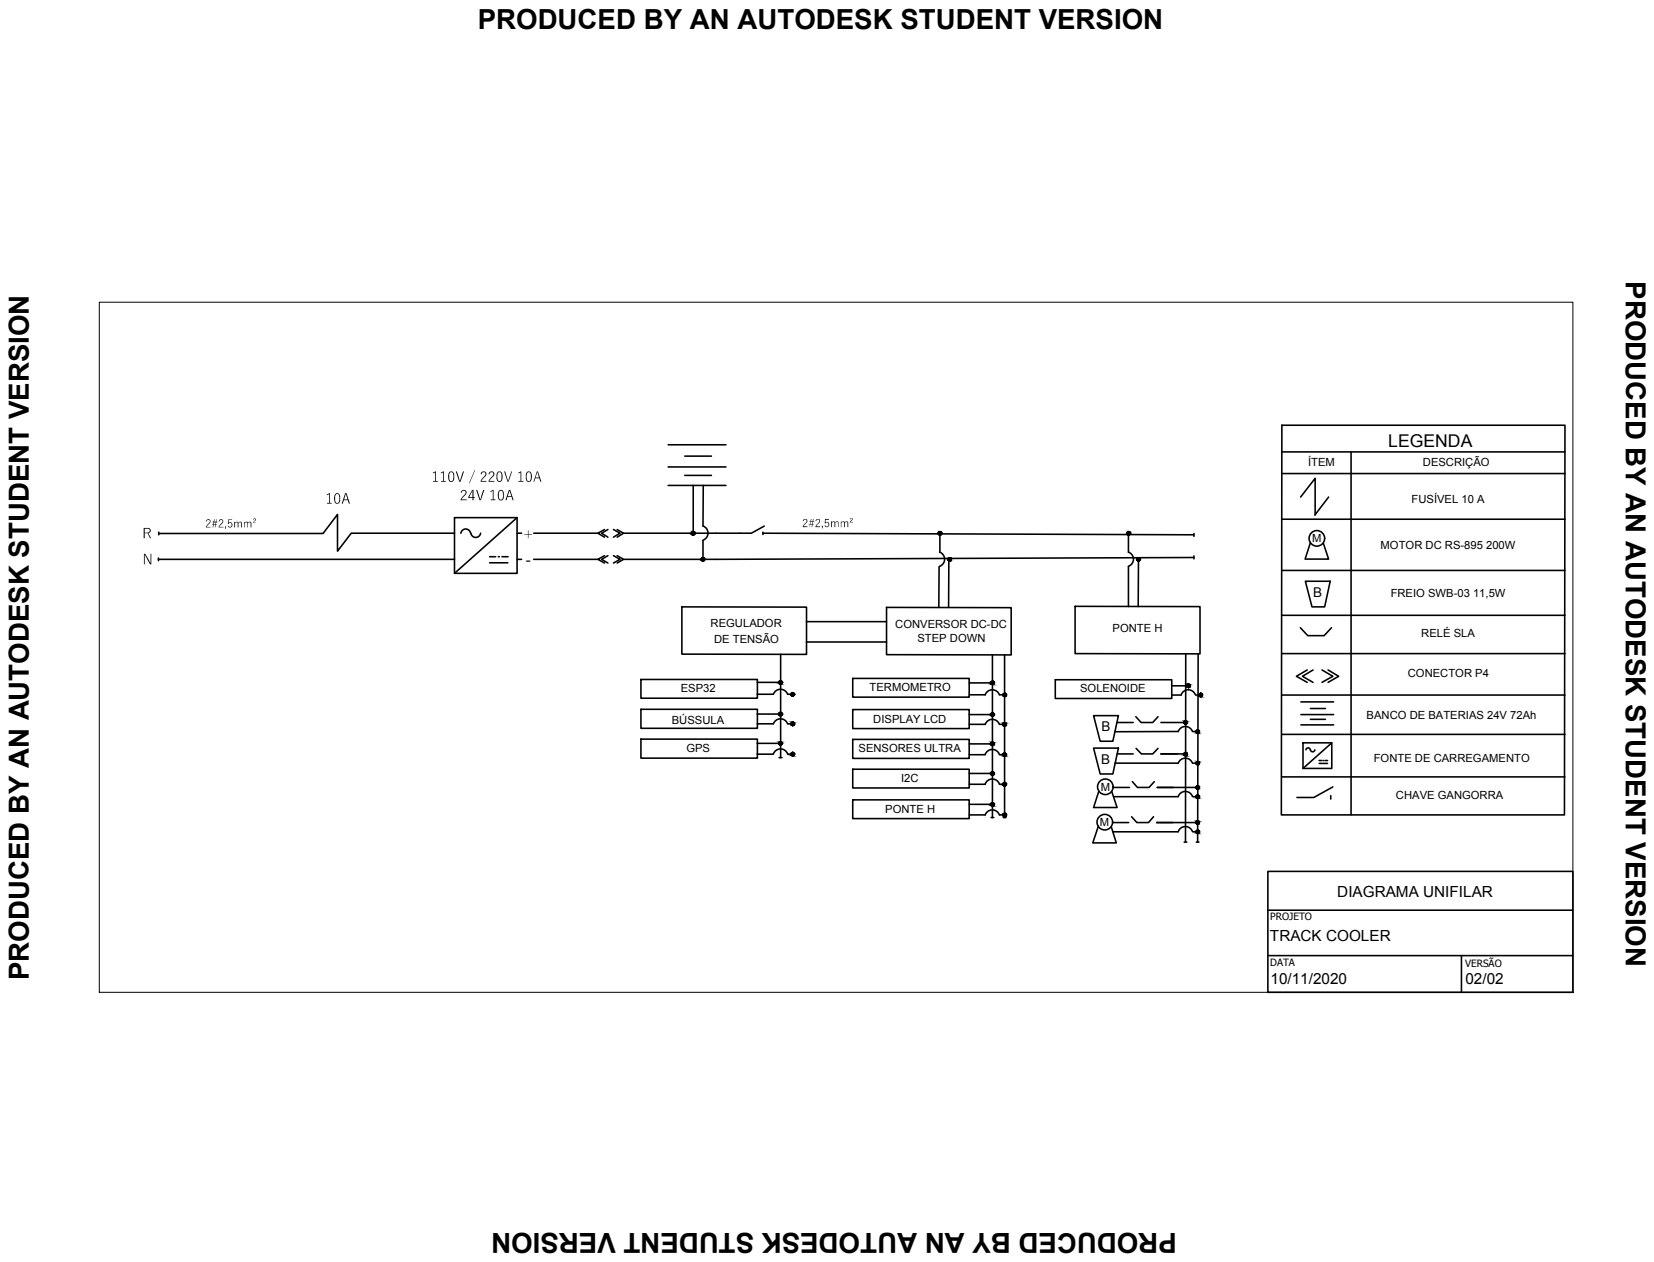
[picture p162: page 1]
CONVERSOR DC-DC STEP DOWN; SOLENOIDE; LEGENDA FUSÍVEL 10 A MOTOR DC RS-895 200W PONTE H DISPLAY LCD SENSORES ULTRA; MBMB REGULADOR DE TENSÃO ESP32 BÚSSULA GPS; ÍTEM; DESCRIÇÃO FREIO SWB-03 11,5W RELÉ SLA CONECTOR P4 BANCO DE BATERIAS 24V 72Ah FONTE DE CARREGAMENTO CHAVE GANGORRA I2C PONTE H TERMOMETRO; DIAGRAMA UNIFILAR PROJETO DATA; VERSÃO TRACK COOLER

PRODUCED BY AN AUTODESK STUDENT VERSION

PRODUCED BY AN AUTODESK STUDENT VERSION 10/11/2020 02/02 PRODUCED BY AN AUTODESK STUDENT VERSION
