track-cooler/docs/Estrutura/PC2/CAD/Desenhos técnicos - PDF/1TrackCooler_Eixos.pdf

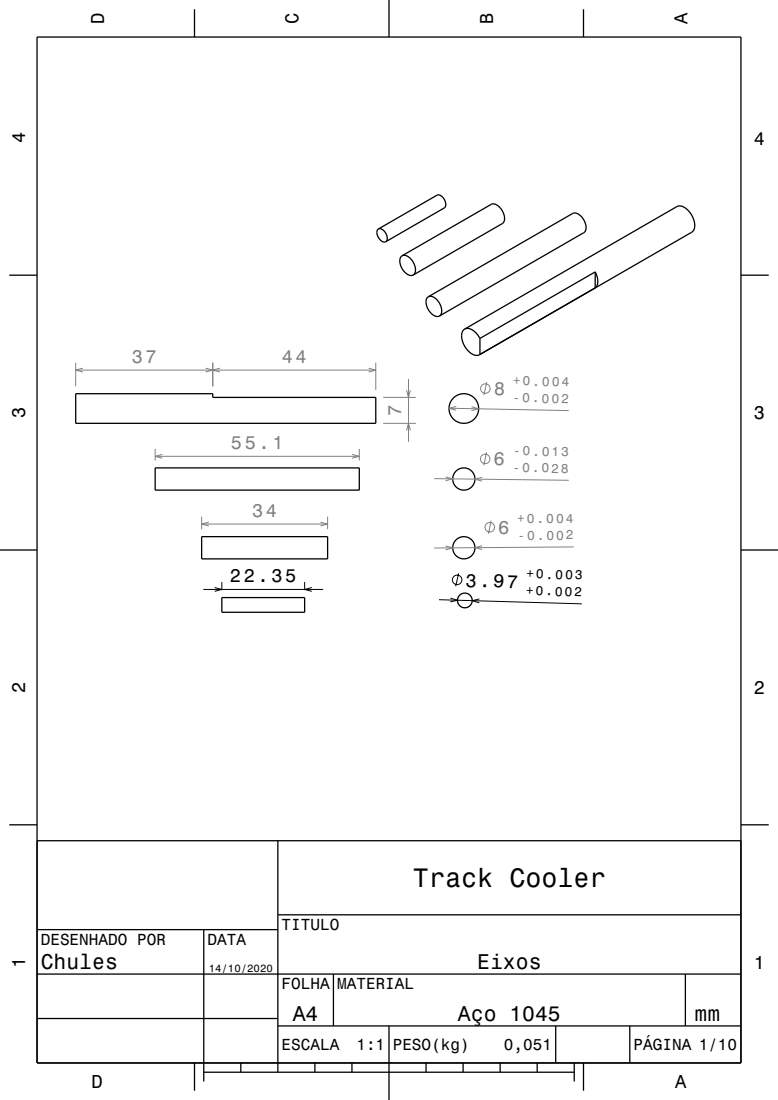
[picture p163: page 1]
Track Cooler

DESENHADO POR Chules | DATA 14/10/2020

FOLHA A4 | MATERIAL Aço 1045 | mm

ESCALA 1:1 | PESO(kg) 0,051 | | PÁGINA 1/10
