track-cooler/docs/Estrutura/PC2/CAD/Desenhos técnicos - PDF/2TrackCooler_Roldana_Nylon.pdf

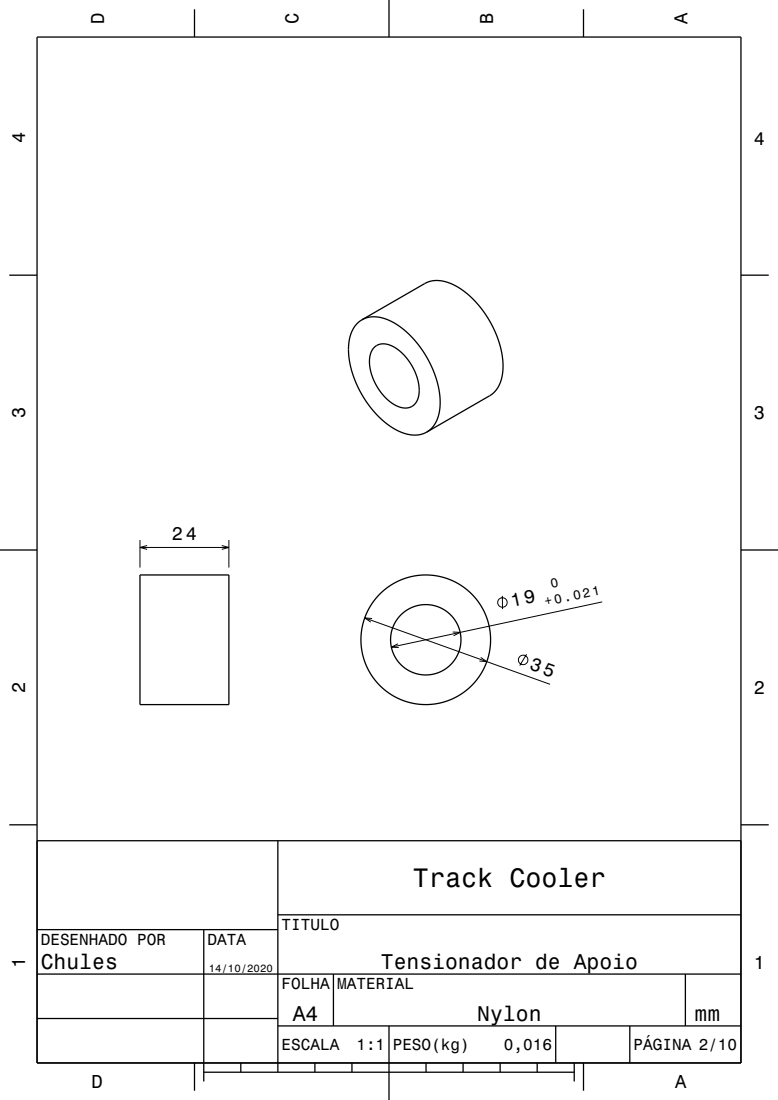
[picture p164: page 1]
Track Cooler

DESENHADO POR Chules | DATA 14/10/2020

Tensionador de Apoio

FOLHA A4 | MATERIAL Nylon | mm

ESCALA 1:1 | PESO(kg) 0,016 | | PÁGINA 2/10
