track-cooler/docs/Estrutura/PC2/CAD/Desenhos técnicos - PDF/3TrackCooler_Caixa_Térmica.pdf

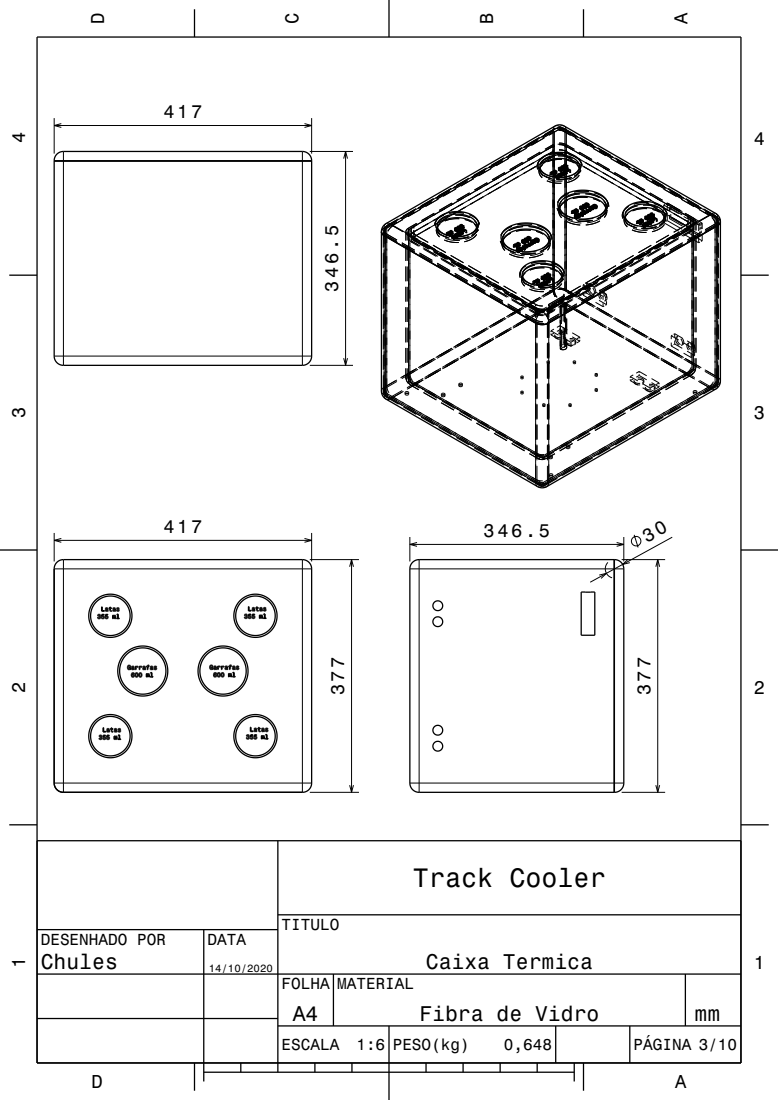
[picture p165: page 1]
DESENHADO POR; ESCALA 1:6 PESO(kg); PÁGINA; Track Cooler; Caixa Termica

Fibra de Vidro
