track-cooler/docs/Estrutura/PC2/CAD/Desenhos técnicos - PDF/4TrackCooler_Pinhão.pdf

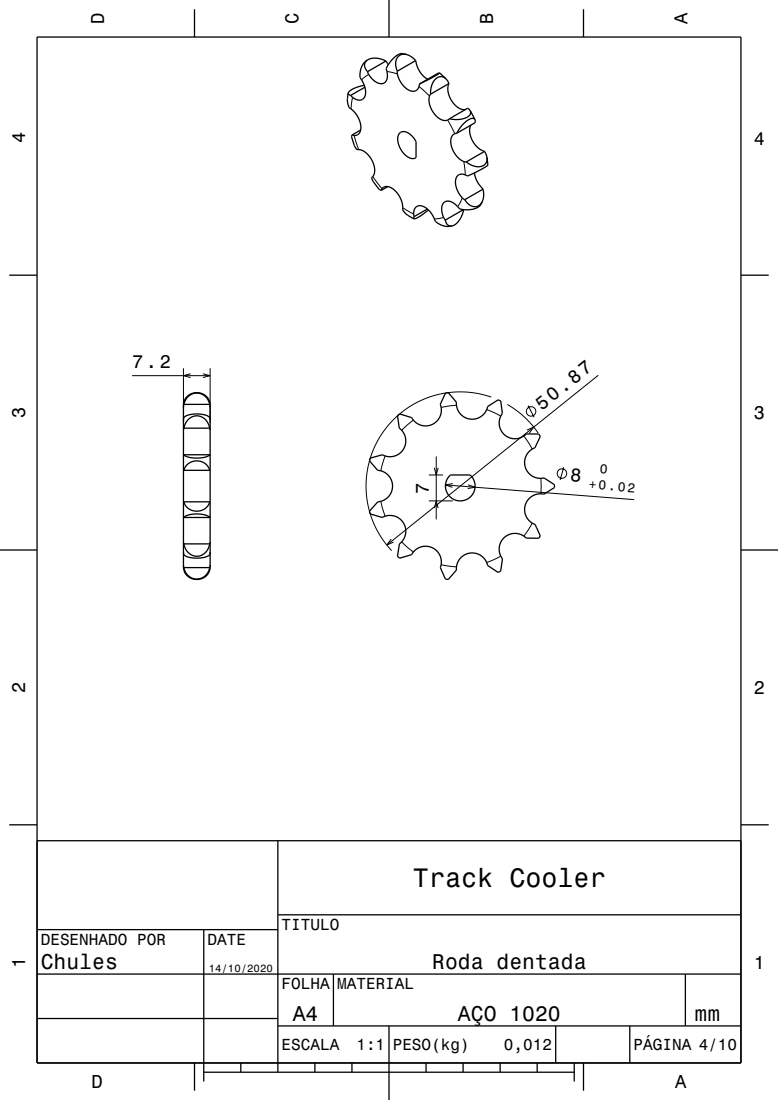
[picture p166: page 1]
Roda dentada; Track Cooler

DESENHADO POR Chules | DATE 14/10/2020

FOLHA A4 | MATERIAL AÇO 1020 | mm

ESCALA 1:1 | PESO(kg) 0,012 | | PÁGINA 4/10
