track-cooler/docs/Estrutura/PC2/CAD/Desenhos técnicos - PDF/5TrackCooler_Haste_Gangorra.pdf

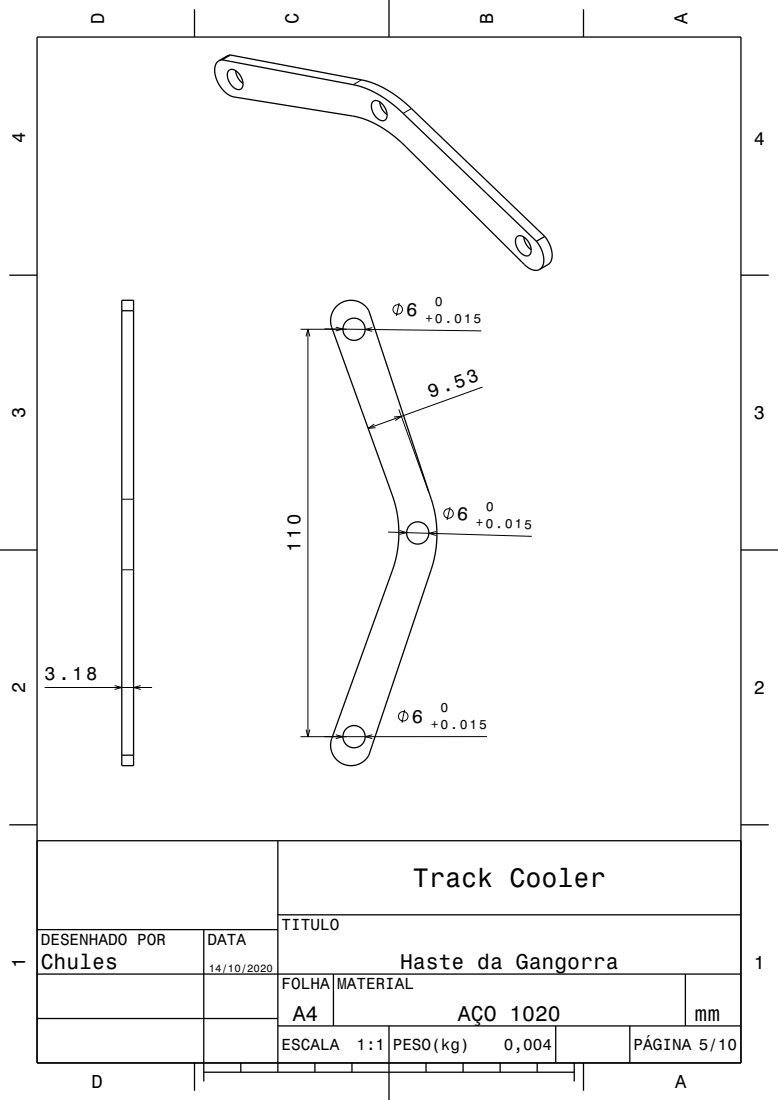
[picture p167: page 1]
Track Cooler

DESENHADO POR Chules | DATA 14/10/2020

Haste da Gangorra

FOLHA A4 | MATERIAL AÇO 1020 | mm

ESCALA 1:1 | PESO(kg) 0,004 | | PÁGINA 5/10
