track-cooler/docs/Estrutura/PC2/CAD/Desenhos técnicos - PDF/7TrackCooler_Cantoneira2.pdf

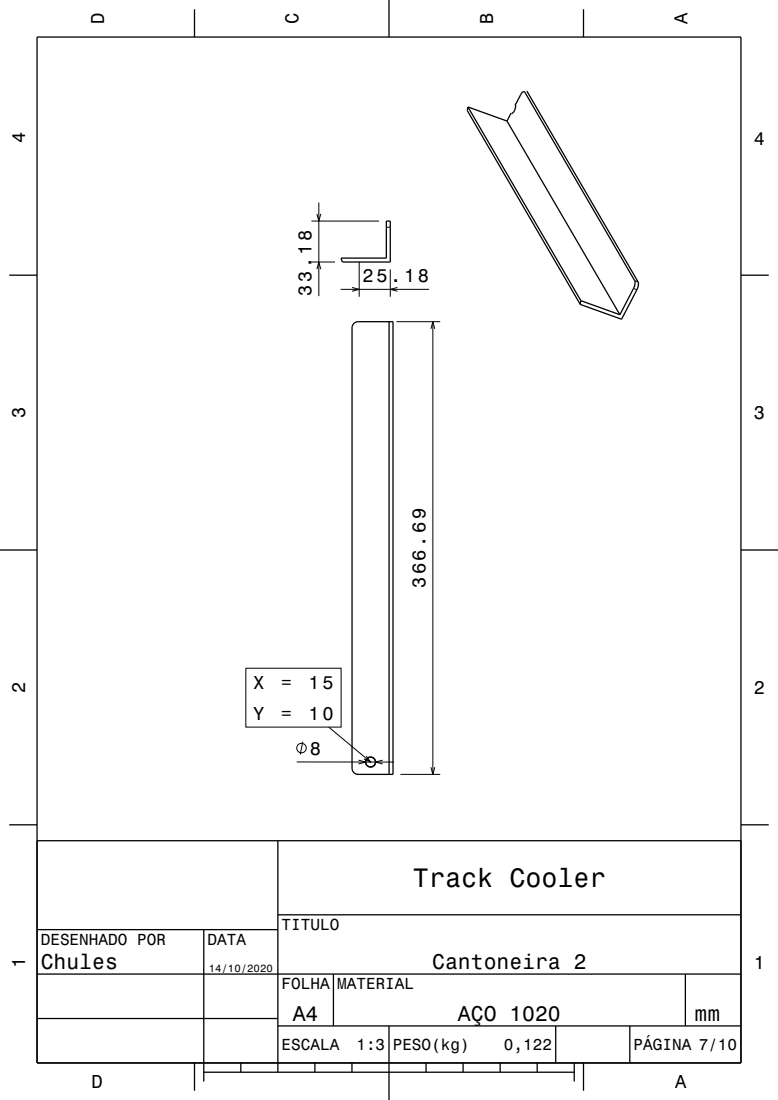
[picture p168: page 1]
Track Cooler; Cantoneira 2

DESENHADO POR Chules | DATA 14/10/2020

FOLHA A4 | MATERIAL AÇO 1020 | mm

ESCALA 1:3 | PESO(kg) 0,122 | | PÁGINA 7/10
