track-cooler/docs/Estrutura/PC2/CAD/Desenhos técnicos - PDF/8TrackCooler_Caixa_Eletrônica.pdf

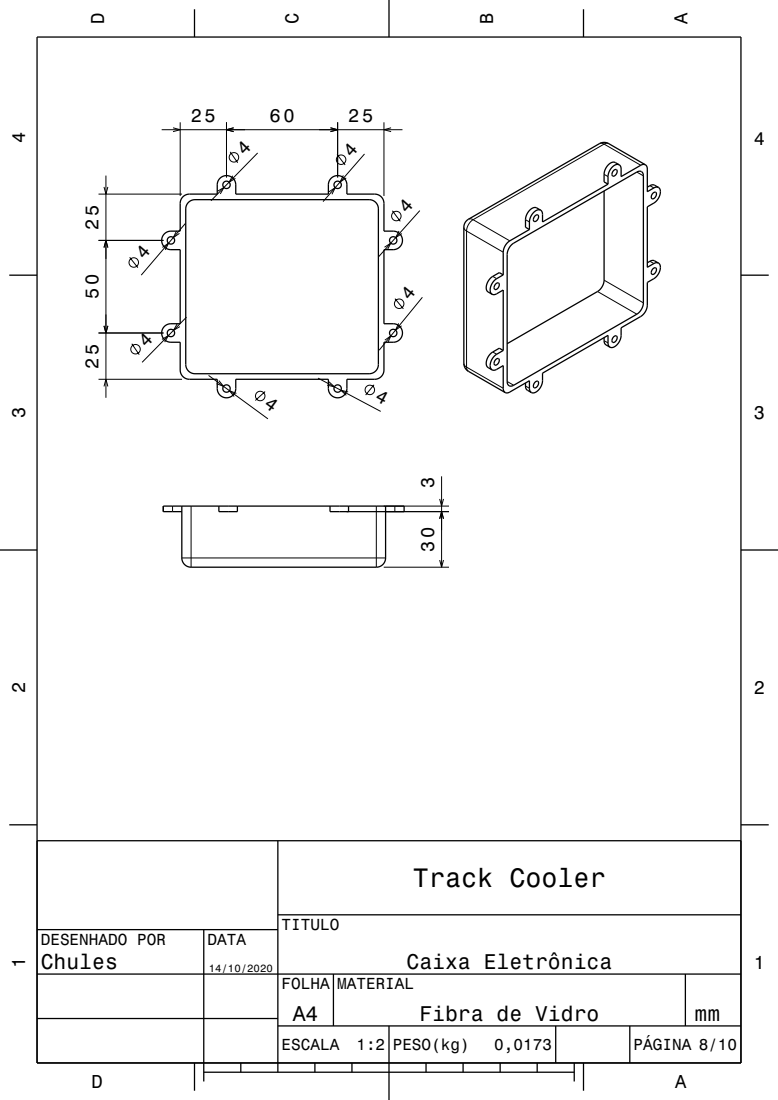
[picture p169: page 1]
Track Cooler; Caixa Eletrônica

DESENHADO POR Chules | DATA 14/10/2020

FOLHA A4 | MATERIAL Fibra de Vidro | mm

ESCALA 1:2 | PESO(kg) 0,0173 | | PÁGINA 8/10
