track-cooler/docs/Estrutura/PC2/CAD/Desenhos técnicos - PDF/9TrackCooler_Carregador.pdf

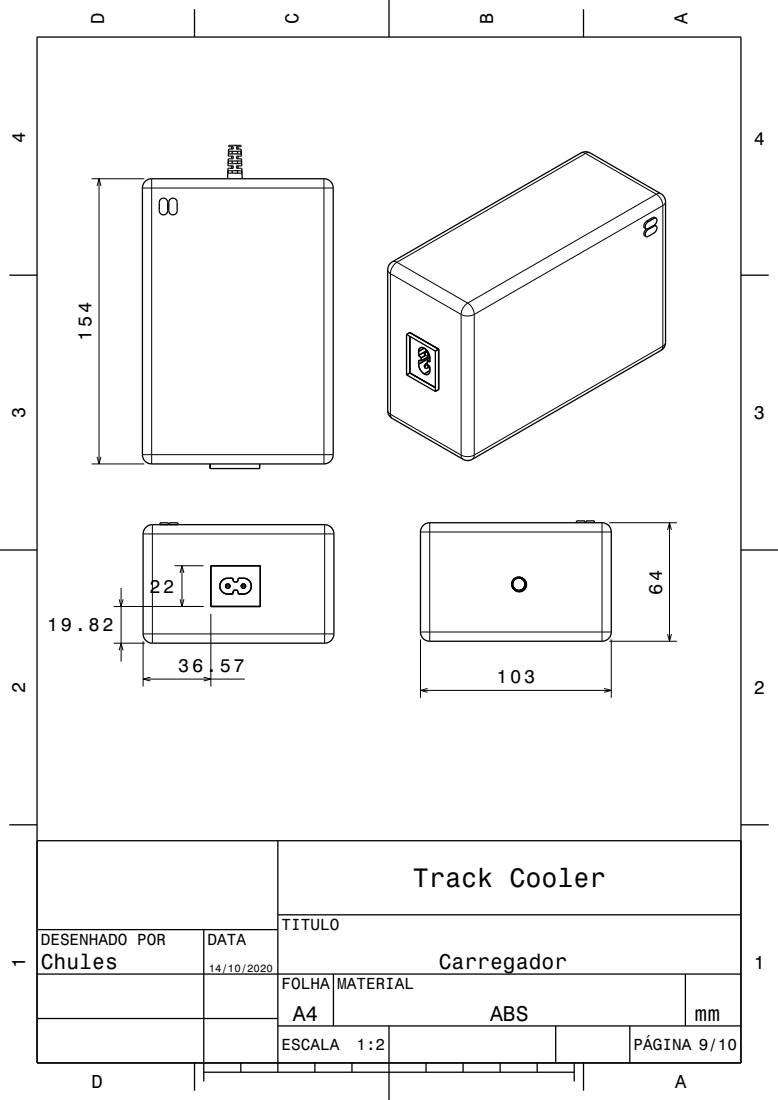
[picture p170: page 1]
Track Cooler

DESENHADO POR Chules | DATA 14/10/2020

FOLHA A4 | MATERIAL ABS | mm

ESCALA 1:2 | | | PÁGINA 9/10
