track-cooler/docs/Estrutura/PC3/Alimentacao/Circuito fonte de carregamento.PDF

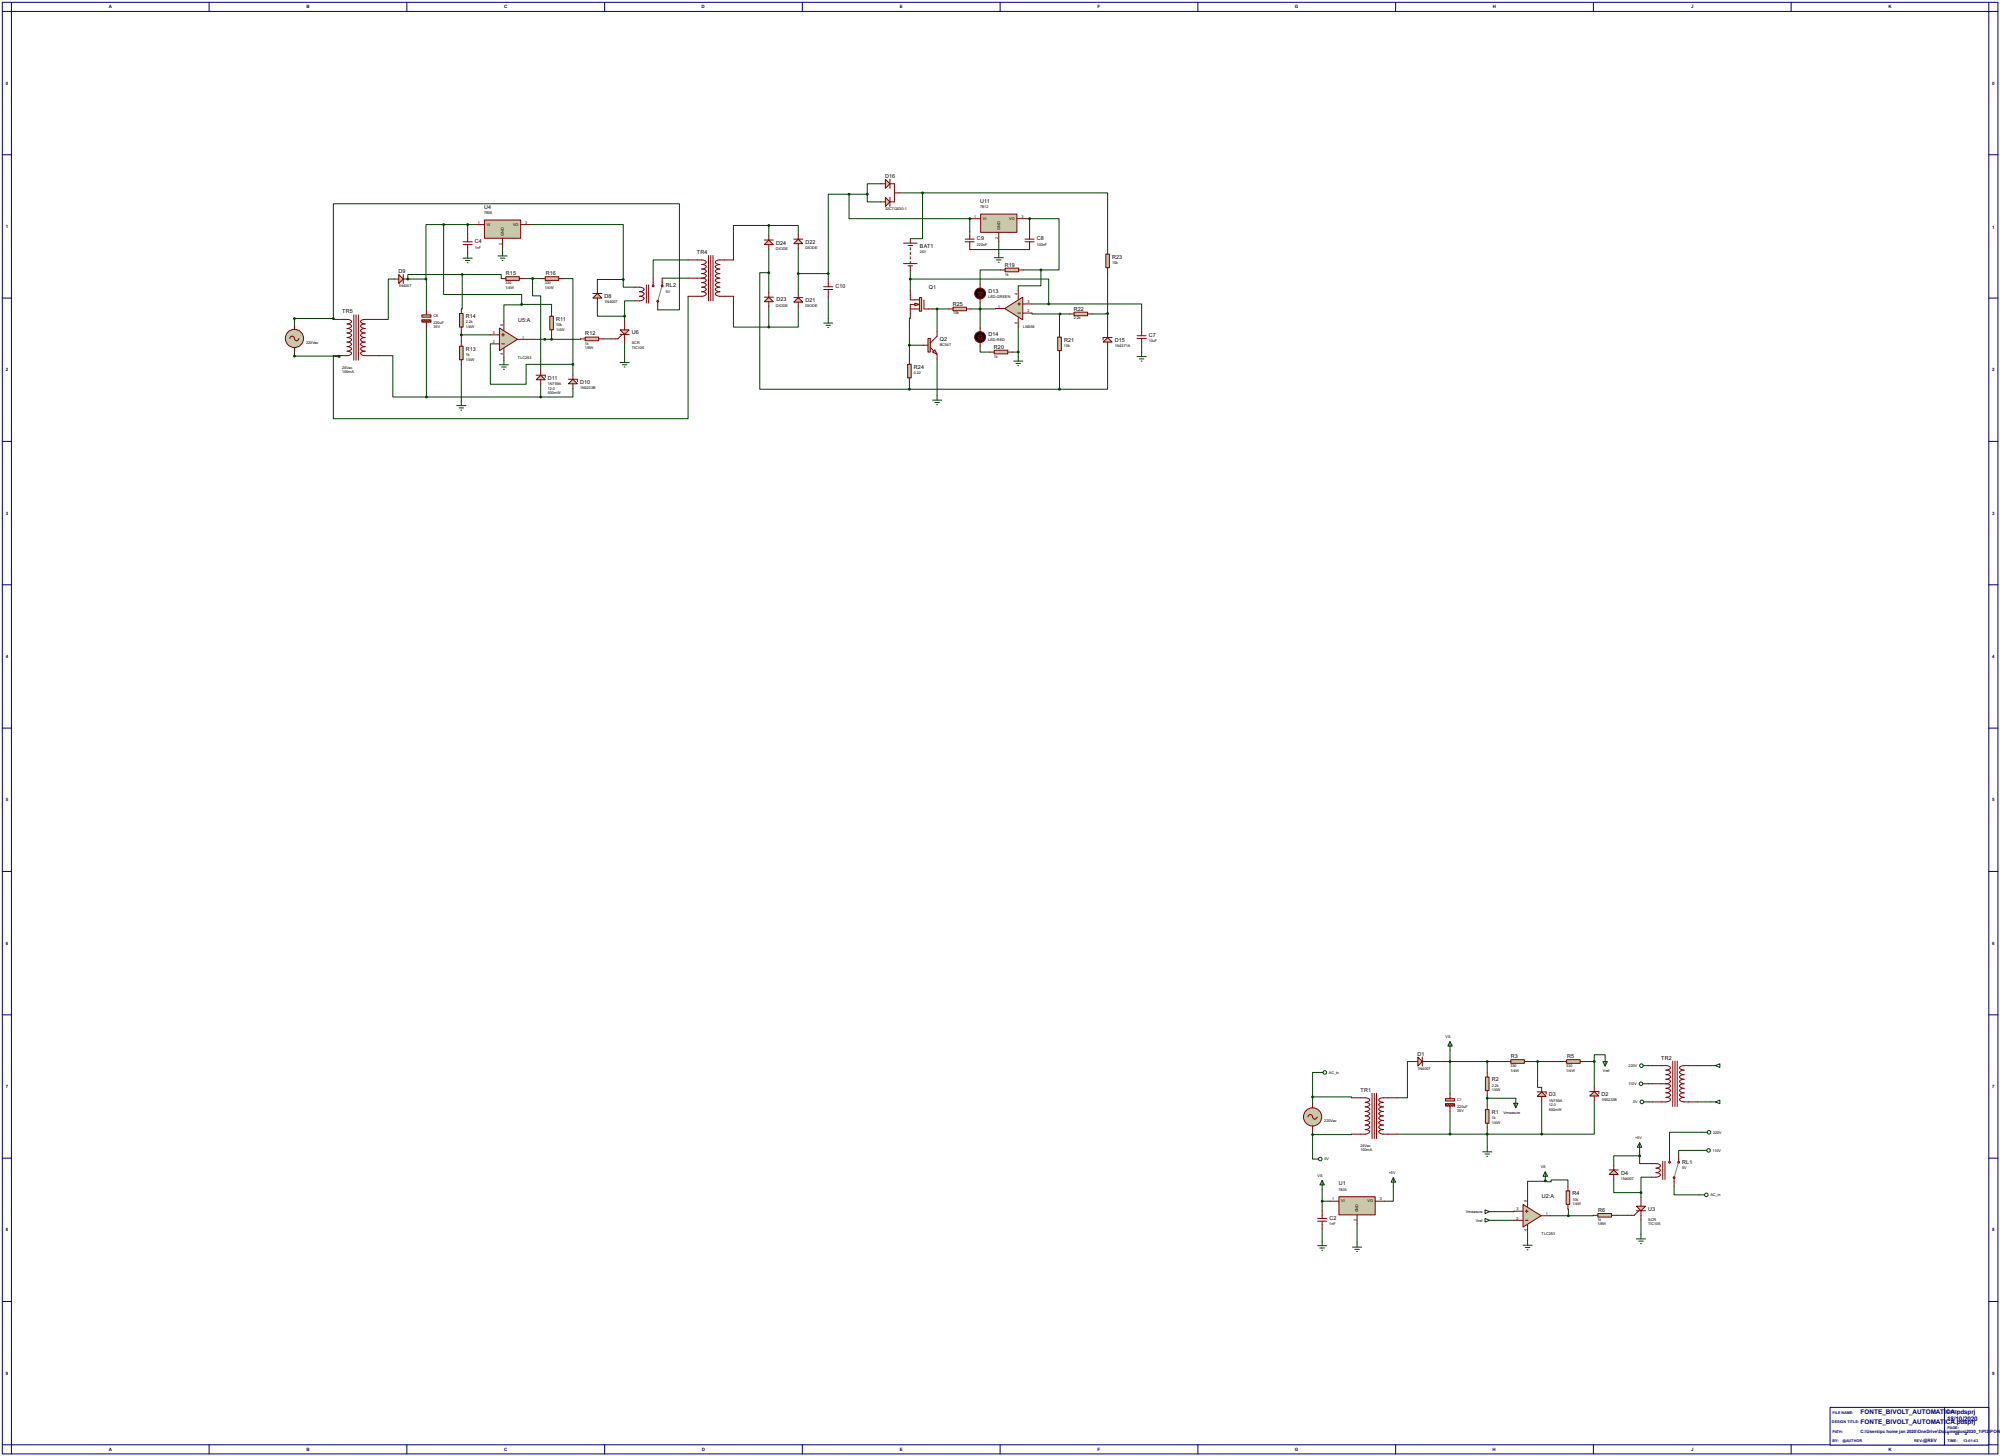
[picture p171: page 1]
