track-cooler/docs/Estrutura/PC2/CAD/Desenhos técnicos - PDF/10TrackCooler_Sapata.pdf

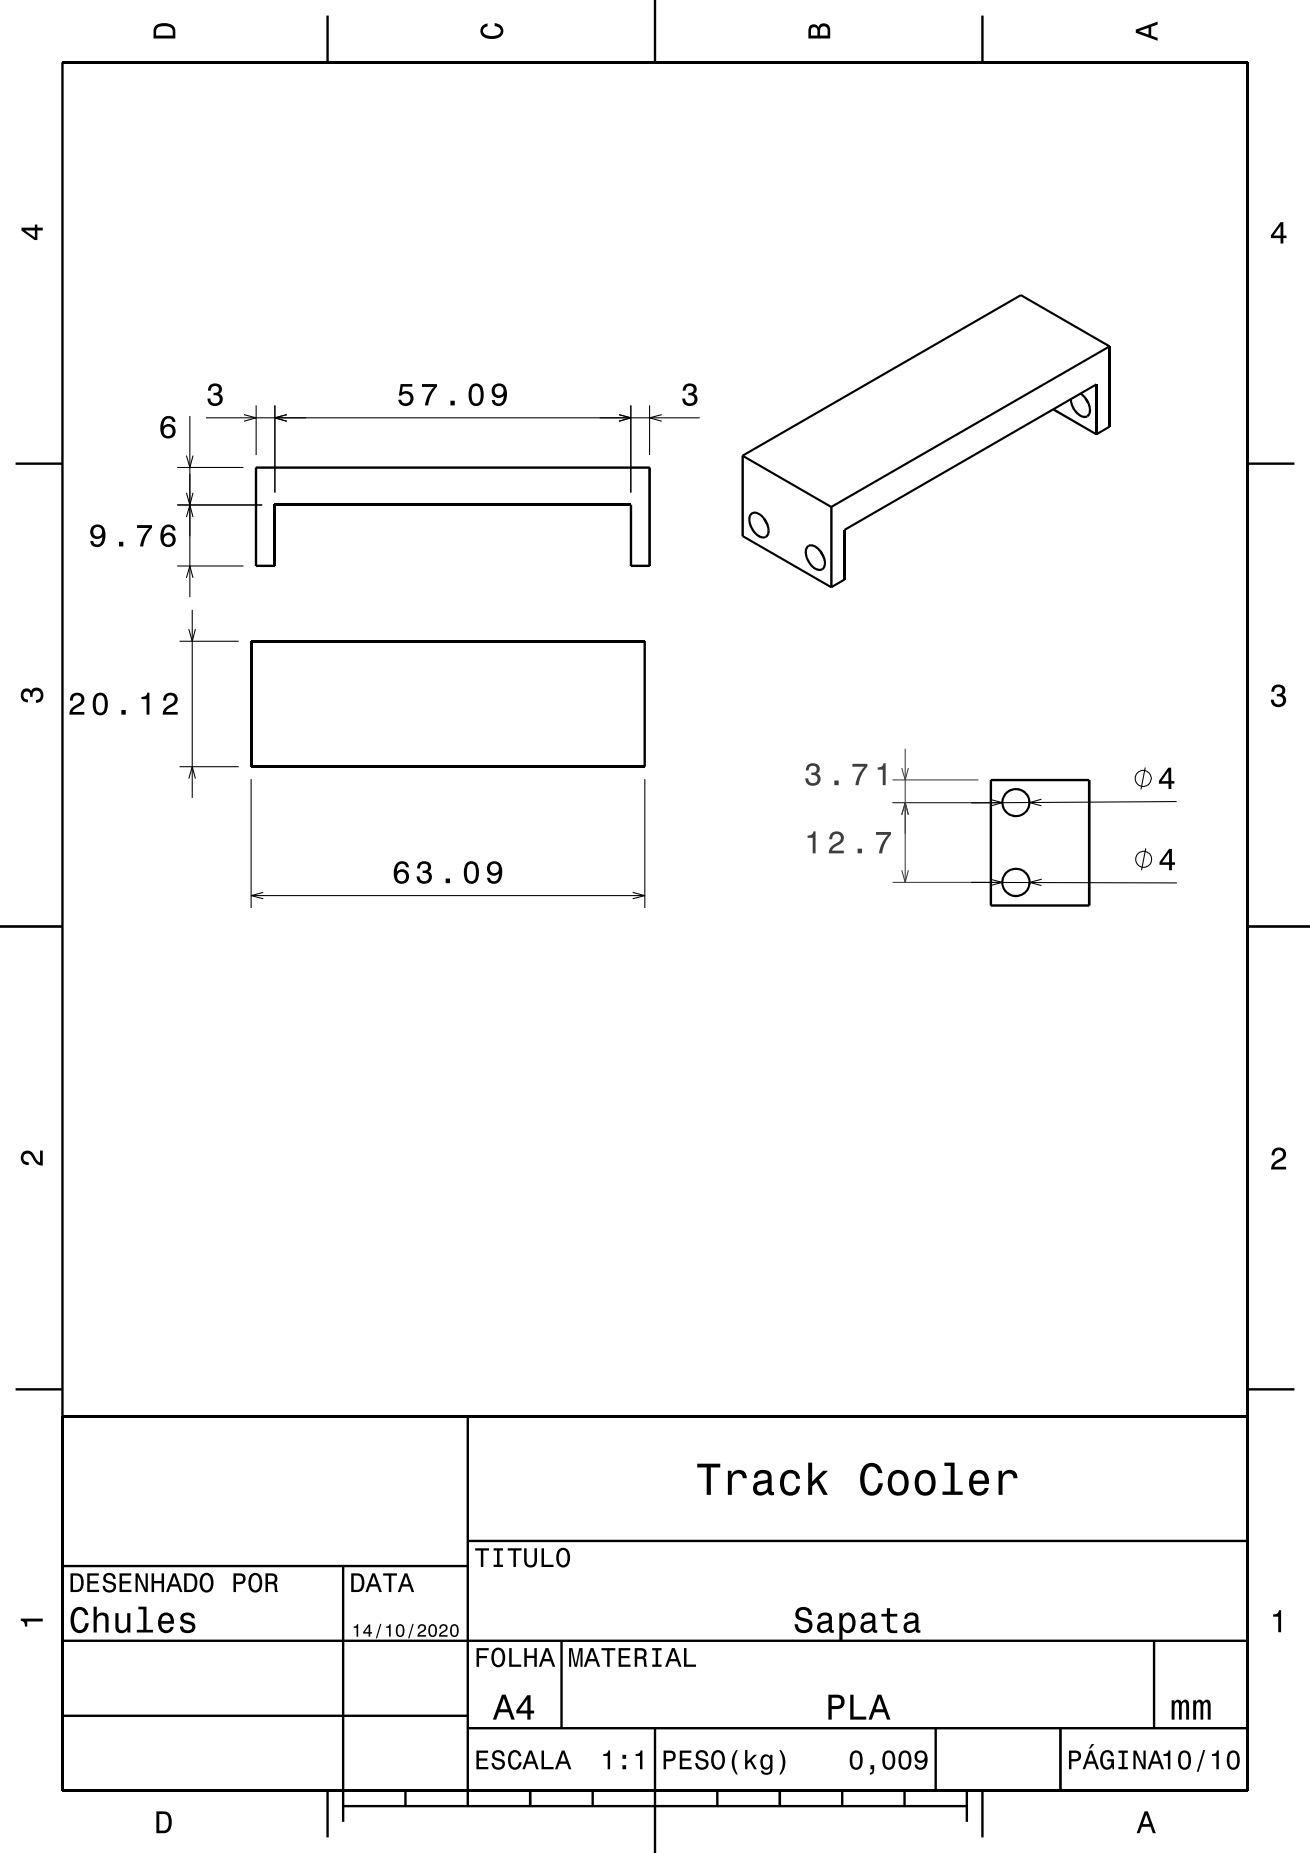
[picture p172: page 1]
