track-cooler/docs/Estrutura/PC2/CAD/Desenhos técnicos - PDF/6TrackCooler_Cantoneira_1.pdf

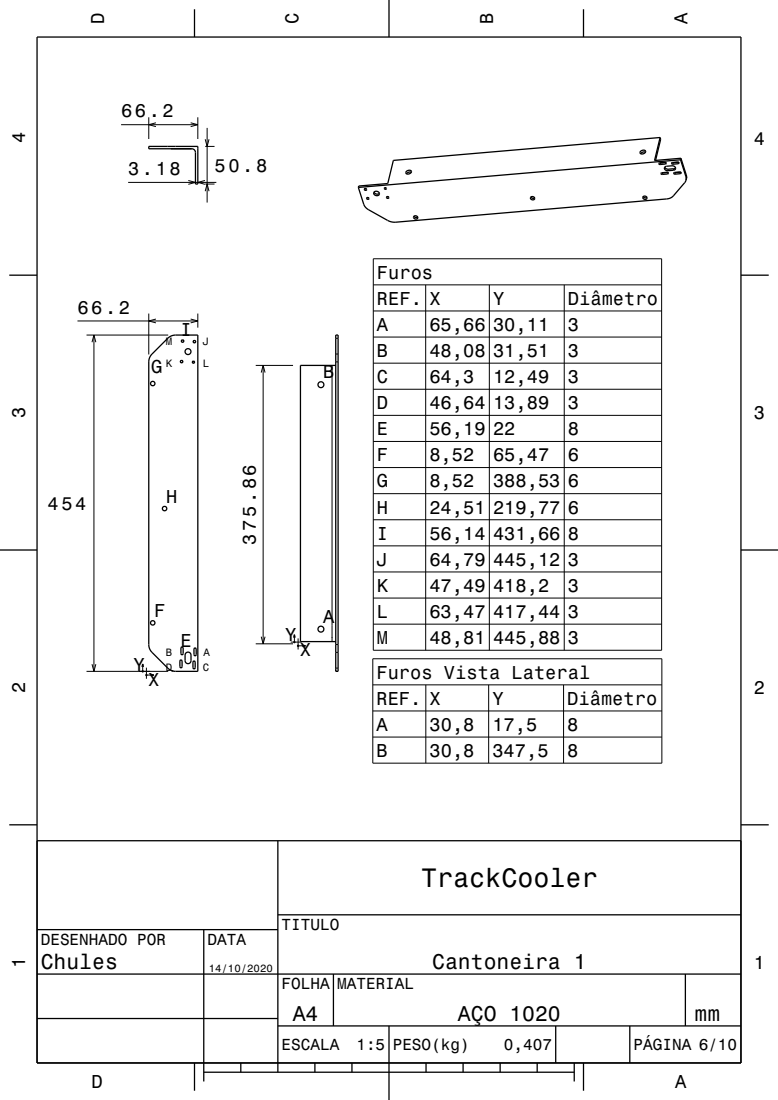
[picture p173: page 1]
Cantoneira 1

REF. | X | Y | Diâmetro
A | 65,66 | 30,11 | 3
B | 48,08 | 31,51 | 3

D | 46,64 | 13,89 | 3
E | 56,19 | 22 | 8
F | 8,52 | 65,47 | 6
G | 8,52 | 388,53 | 6
H | 24,51 | 219,77 | 6
I | 56,14 | 431,66 | 8
J | 64,79 | 445,12 | 3
K | 47,49 | 418,2 | 3
L | 63,47 | 417,44 | 3
M | 48,81 | 445,88 | 3

Furos Vista Lateral

A | 30,8 | 17,5 | 8
B | 30,8 | 347,5 | 8

DESENHADO POR Chules | DATA 14/10/2020

FOLHA A4 | MATERIAL AÇO 1020 | mm

ESCALA 1:5 | PESO(kg) 0,407 | | PÁGINA 6/10
