track-cooler/docs/(list of files, drawings)

Other design files:
Eletronica/PC3/PCB_2020-11-10_20-42-12_2020-11-10_20-42-27.json
