track-cooler/docs/(commit log)

2020-04-15 Estrutura inicial de pastas
2020-10-21 Criação de pasta para os CADs da estrutura
2020-10-21 Criação de pasta para as simulações da estrutura
2020-10-21 Imagens do CAD
2020-10-21 Simulações de estruturas
2020-10-21 Criação de pasta de sistema de alimentação
2020-10-21 Criação de pasta para análise térmica de energia
2020-10-23 Upload de imagens com detalhes das simulações
2020-11-18 Atualização das pastas de estrutura.
2020-11-29 Create Bateria 24V 36Ah.pdf
2020-11-29 Create Circuito fonte de carregamento.PDF
2020-11-29 Create Transformador 24V.pdf
2020-11-29 Create Transformador 30V.pdf
